Elite-Capstone/Project-ShutTheFrontDoor/Sketches/homepage.png

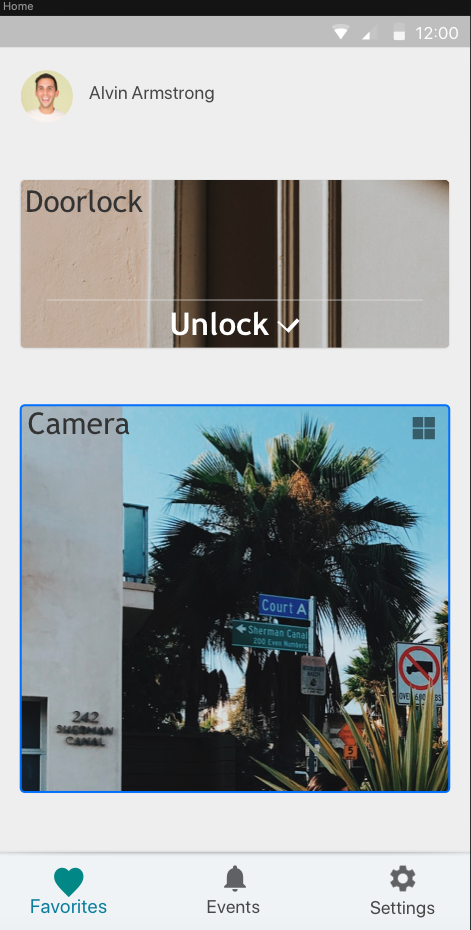
Sketches/homepage.png
