Elite-Capstone/Project-ShutTheFrontDoor/README.md

# Elite-Project
Concordia 2020 Capstone Project

On one side, it can cost a manufacturer tens of thousands of dollars for hundreds of hours of development [1] to develop an IoT product, from the hardware to the software without a dedicated in-house development team, limiting the market to larger companies. On the other side, currently, it can be more costly and troublesome for a customer to acquire a “smart front door”: they will have to buy seperate IoT devices such as a camera, a smart lock and a smart doorbell from one same ecosystem and, then, connect them together themselves. Having access to a complete package might be cheaper and easier to implement. The challenge resides in making both the user’s and the manufacturer’s life easier by helping the latter cut development costs and the former cut implementation costs. 

The aim of this project is to develop a smart door equipped with an expandable IoT platform as a two-part IoT device. The first part, the door, will come as an all-in-one solution for the customer while the second part, the expandable platform, will be available for manufacturers to add new devices to the ecosystem.

The smart door will include functionalities controlled and monitored through a mobile application. These include a smart lock, which can be locked/unlocked from the mobile interface; a camera that will allow the user to view any activities and people at their front door and a doorbell that will notify the homeowner of the presence of a visitor. All features will be enabled and powered through the use of a board. The board’s wifi module will then allow the communications for the IoT capabilities. The expandable platform will facilitate the addition of new devices to the IoT ecosystem. The prototype will use a general modular board that can be integrated in future IoT devices by simply connecting them and mapping them to the board module. All in all, this will solve both the manufacturer’s and the customer’s challenges.

A video of the completed project can be found here: https://www.youtube.com/watch?v=NI2LXENx7tQ

Regards
STFD Team
