Elite-Capstone/Project-ShutTheFrontDoor/Hardware/ESP/main-app/README.txt

This library is used to program the central MCU of the ShutTheFrontDoor Project.

GPIO List of the ESP32-SOLO-1 in ascending order
1:  TXD0 (Reserved)
2:  (in)  Cam CS
3:  RXT0 (Reserved)
4:
5:
6:  SCK
7:  SDO (out)
8:  SDI (in)
9:  SD2
10: SD3
11: CS
12: GND
13: 
14: 
15: (in) Motion Sensor Signal
16:
17:
18:
19:
NO 20
21:
22: BOOT Button
23: 
NO 24
25: (in)  Motor Fault Detect.
26: (in)  N-switch
27: (in)  Battery ADC
NO 28-31
32: (out) Motor CTRL IN 2
33: (out) Motor CTRL IN 1
34: (in)  Doorbell Signal
35: (in)  Reed Sw. Signal
36: SENSOR_VP
NO 37-38
39: SENSOR_VN

Note: Can't use ADC 2 with Wifi driver as Wifi uses ADC 2

 ADC 1           ADC 2
 CH  GPIO        CH  GPIO
 0   36          0   4
 3   39          1   0
 4   32          2   2
 5   33          3   15
 6   34          4   13
 7   35          5   12
                 6   14
                 7   27
                 8   25
                 9   26

The MCU connects to the following MQTT server:

#define MQTT_BROKER_URL "mqtt://34.95.9.208:1883"

And uses its door UUID to publish/subscribe to topics. 
This unit's UUID and topics are defined below:

#define DEFAULT_DOOR_UUID "00b288a8-3db1-40b5-b30f-532af4e12f4b"

#define NOTIFICATION_TOPIC  "notification/" DEFAULT_DOOR_UUID
#define STATUS_TOPIC        "status/" DEFAULT_DOOR_UUID
#define CMD_TOPIC           "command/" DEFAULT_DOOR_UUID

JSONs are used to communicate the MCU's state and commands. 
The formats are defined below for commands.
Command Format JSON:
{
  "name": "timeOfPublish",
  "type": "record",
  "fields": [
      {
      "name": "year",
      "type": "int"
      },
      {
      "name": "month",
      "type": "int"
      },
      {
      "name": "day",
      "type": "int"
      },
      {
      "name": "hour",
      "type": "int"
      },
      {
      "name": "minute",
      "type": "int"
      },
      {
      "name": "second",
      "type": "int"
      }
  ],
  {
    "name": "targetDevice",
    "type": "string"
  },
  {
    "name": "commandRequest",
    "type": "string"
  },
  {
    "name": "requestFlag",
    "type": "int"
  },
  {
    "name": "commandDelayMS",
    "type": "int"
  }
}

Command types:
#define MCU_SHUTDOWN_STR    "MCU shutdown"
#define MCU_GETSTATUS_STR   "Get status"
#define LOCK_DOOR_STR       "Lock door"
#define UNLOCK_DOOR_STR     "Unlock door"
#define STREAM_CAM_STR      "Stream camera"

Example command:
{
  "timeOfPublish":
  {
      "year": 2021,
      "month": 3,
      "day": 31,
      "hour": 10,
      "minute": 30,
      "second": 30
  },
  "targetDevice": "ESP32 - Main MCU",
  "commandRequest": "Get status",
  "requestFlag": 0,
  "commandDelayMS": 0
}
