Elite-Capstone/Project-ShutTheFrontDoor/Hardware/Smart Door Design with ESP32/ESP32-SOLO-1_Reference_Design/README.pdf

请使⽤用以下⼯工具打开原理理图和 PCB ⽂文件 / Use the following tools to open schematics and PCB files: SCH: Cadence/OrCAD Capture V16.6
PCB: Mentor Graphics/Pads VⅩ.2

修订历史 / Revision History

⽇日期 / Date | 版本 / Version | 发布说明 / Release notes
2018.09 | r1.0 | ⾸首次发布 / First release
2020.01 | r1.1 | 增加 asc ⽂文件/ Added an asc file.
