Elite-Capstone/Project-ShutTheFrontDoor/Division of work.png

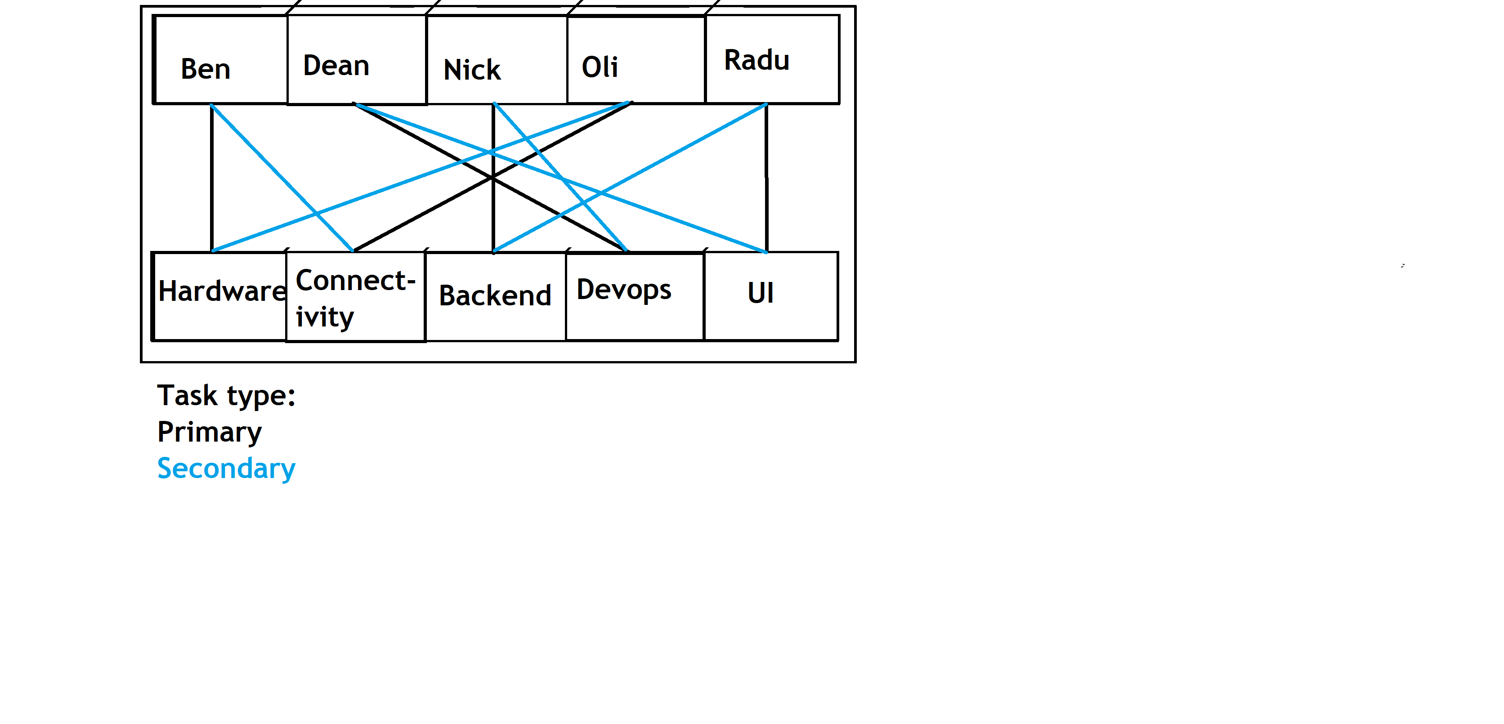
Division of work.png
