Elite-Capstone/Project-ShutTheFrontDoor/Hardware/Smart Door Design with ESP32/Team_26_Schematic_Diagrams/main pcb.png

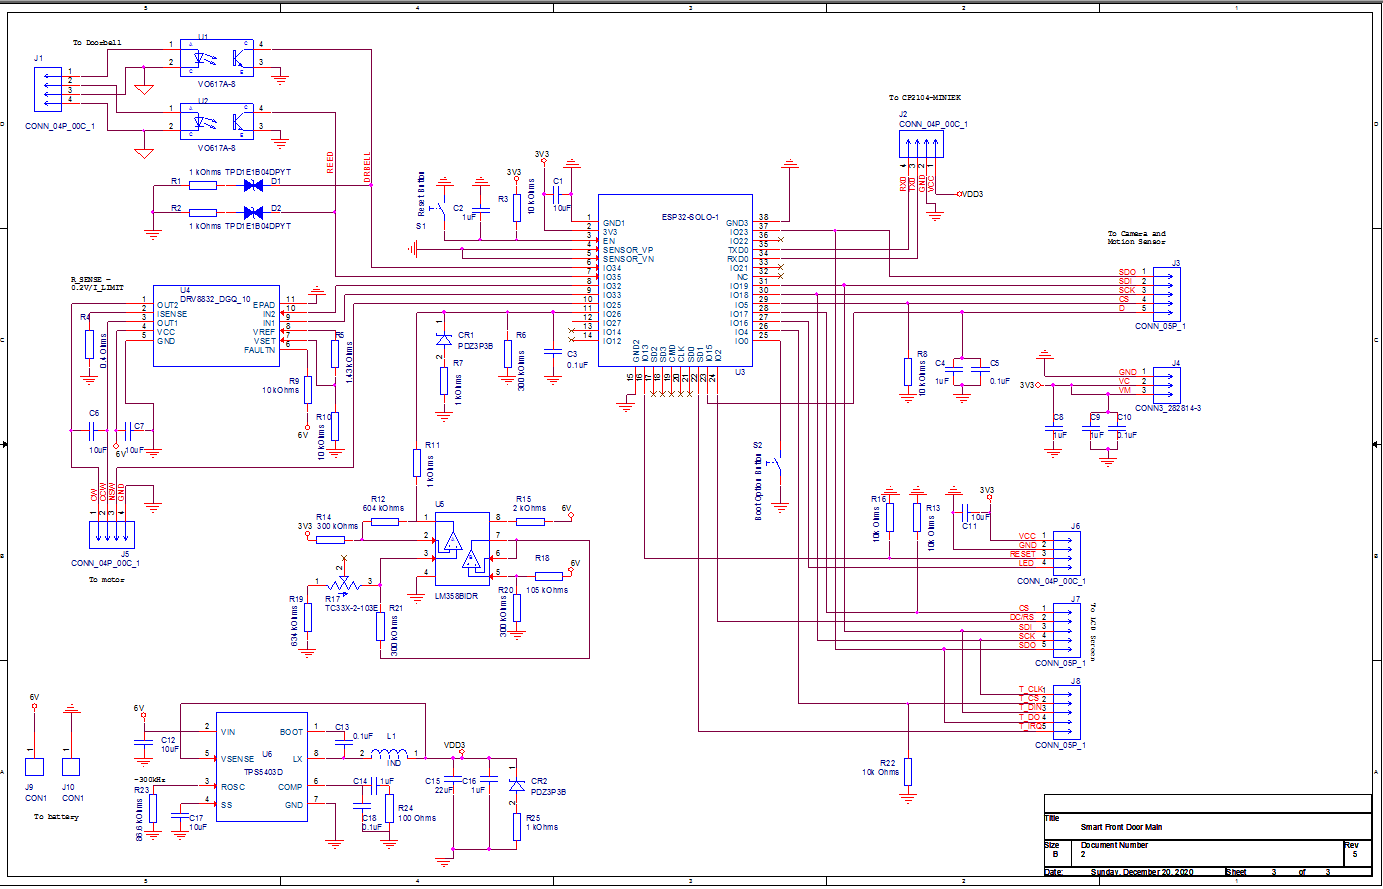
Hardware/Smart Door Design with ESP32/Team_26_Schematic_Diagrams/main pcb.png
