Elite-Capstone/Project-ShutTheFrontDoor/Hardware/Team26_PCB_Layer_Screenshots/PCB_Bottom_without_silkscreen_screenshot.PNG

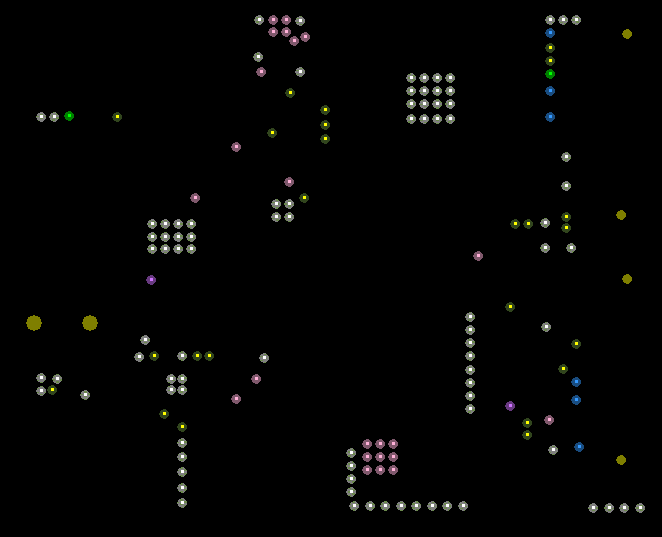
Hardware/Team26_PCB_Layer_Screenshots/PCB_Bottom_without_silkscreen_screenshot.PNG
