Elite-Capstone/Project-ShutTheFrontDoor/Hardware/Team26_PCB_Layer_Screenshots/PCB_Bypass_without_silkscreen_screenshot.PNG

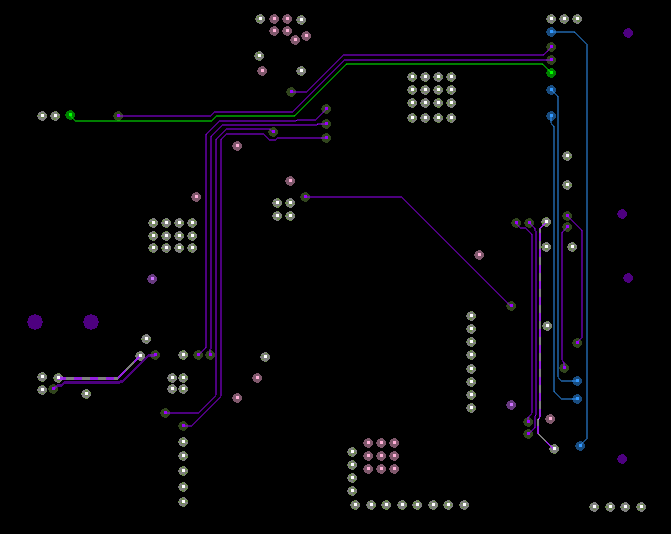
Hardware/Team26_PCB_Layer_Screenshots/PCB_Bypass_without_silkscreen_screenshot.PNG
