Elite-Capstone/Project-ShutTheFrontDoor/Hardware/Team26_PCB_Layer_Screenshots/PCB_Top_screenshot.PNG

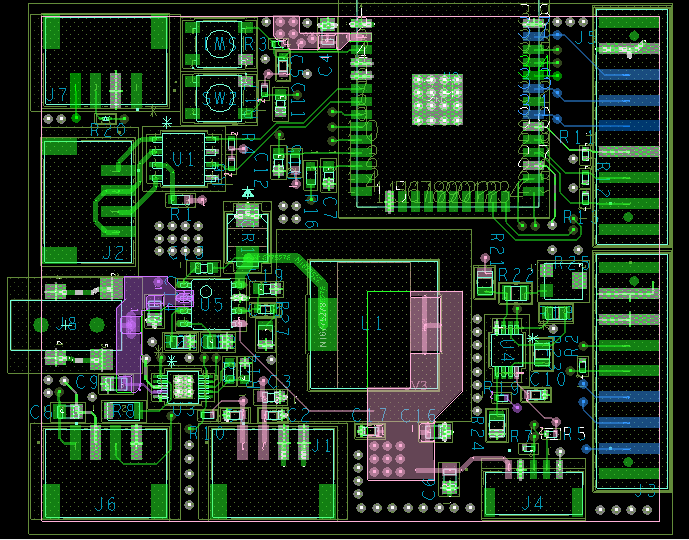
Hardware/Team26_PCB_Layer_Screenshots/PCB_Top_screenshot.PNG
