Elite-Capstone/Project-ShutTheFrontDoor/Sketches/account.png

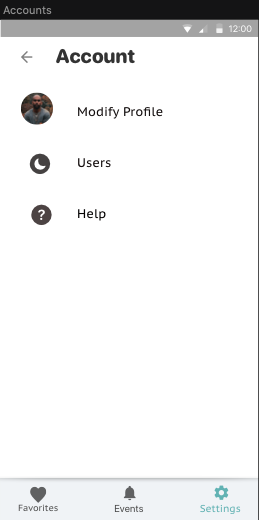
Sketches/account.png
