Elite-Capstone/Project-ShutTheFrontDoor/Sketches/add new user.png

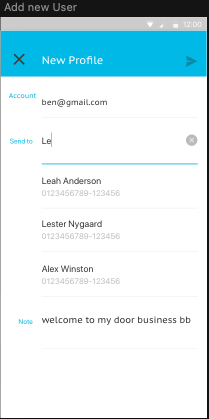
Sketches/add new user.png
