Elite-Capstone/Project-ShutTheFrontDoor/Sketches/all recordings.png

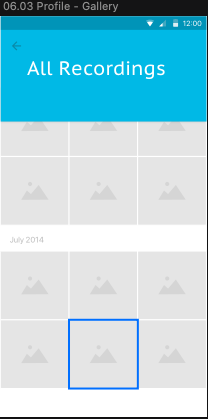
Sketches/all recordings.png
