Elite-Capstone/Project-ShutTheFrontDoor/Sketches/delete user.png

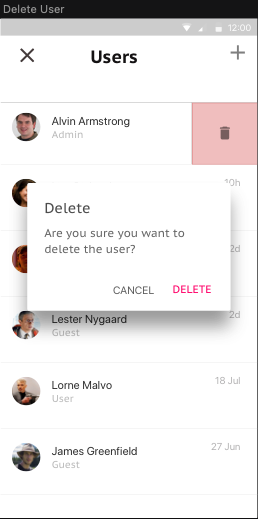
Sketches/delete user.png
