Elite-Capstone/Project-ShutTheFrontDoor/Sketches/device status.png

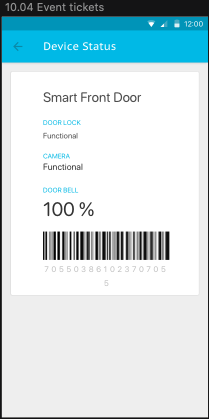
Sketches/device status.png
