Elite-Capstone/Project-ShutTheFrontDoor/Sketches/edit user.png

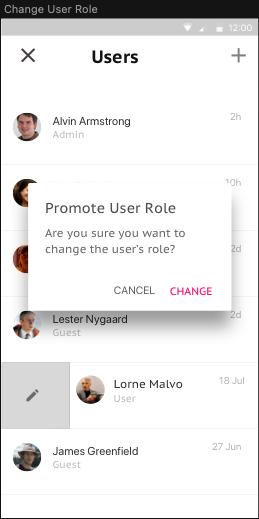
Sketches/edit user.png
