Elite-Capstone/Project-ShutTheFrontDoor/Sketches/events log.png

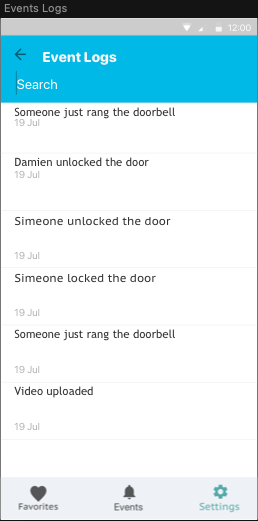
Sketches/events log.png
