Elite-Capstone/Project-ShutTheFrontDoor/Sketches/login.png

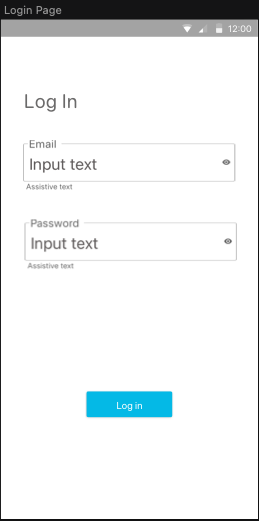
Sketches/login.png
