Elite-Capstone/Project-ShutTheFrontDoor/Sketches/modify profile.png

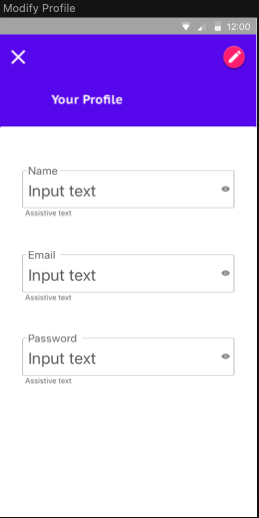
Sketches/modify profile.png
