Elite-Capstone/Project-ShutTheFrontDoor/Sketches/notifications.png

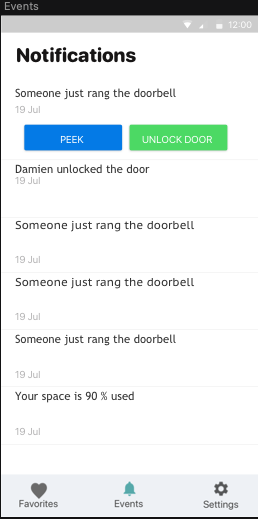
Sketches/notifications.png
