Elite-Capstone/Project-ShutTheFrontDoor/Sketches/register.png

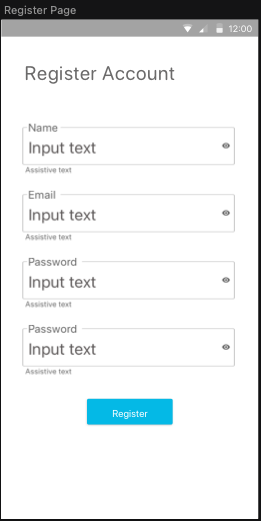
Sketches/register.png
