Elite-Capstone/Project-ShutTheFrontDoor/Sketches/settings.png

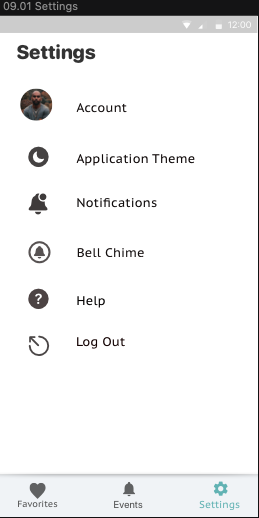
Sketches/settings.png
