Elite-Capstone/Project-ShutTheFrontDoor/Hardware/Product Orders/Team26_BOM_V4.pdf

# Bill of Materials

Company: | University of Concordia
Project Name: | Smart Front Door
Revision: | Release 4 BOM
Prepared by: | Dean Chong San, Nick Di Marco and Benjamin Lanthier, Team 26
Approved by: | Dmitry Rozhdestvenskiy
Production date 1/25/2021
Design Reference | Name | Description | Value | Qty | Unit | Manufacturer | Manufacturer P/N | Package | Type | Supplier | Supplier P/N | Unit Cost ($CDN) | Total Cost ($CDN)
- | Battery Charger | Desktop Battery Charger 7A 300 mA 6V | 300mA, 6V | 1 | pcs | ZEUS Battery Products | PCCG-SLA6V300 | Bulk | Desktop | Digi-Key | 2059-PCCG- SLA6V300-ND | 16.1 | 16.1
- | Magnet | MAGNET 1.125"L X 0.259"W PLASTIC for 59145-030 Reed switch | 57150-000 | 1 | pcs | Littelfuse Inc. | 57150-000 | Bulk | Alnico 5 (AlNiCo) | Digi-Key | 57150-000-ND | 4.05 | 4.05
- | PCB Board | Project 4-Layer PCB board - 63.5mm x 63.5 mm | - | 5 | pcs | JLCPCB | - | - | - | JLCPCB | - | | 8
- | SD Card 64 GB | SanDisk A1 Memory micro SD Card 64 GB | 64gb | 1 | pcs | SanDisk | A1 micro sd card | Single card | micro SD | Ali-Express | A1 micro sd card | 8.61 | 8.61
- | USB to Serial | RF Explorer - Adapter Board | 317990279 | 1 | pcs | Seeed Technology Co. Ltd | 317990279 | Evaluation Board | Adapter Board | Digi-Key | 1597-1492-ND | 8.42 | 8.42
BT1 | Batteries | Battery HHR PACK NIMH 6V L-A | 3.7Ah | 2 | pcs | Panasonic - BSG | HHR-380AB27F5 | 5 cells | side-to-side | Digi-Key | P018-F051-ND | 52.26 | 104.52
BT2, SW4 | Wireless Doorbell | Heath Zenith Wireless Battery Operated Door Bell Kit with 1-Push Button | # SL-7306-03 | 1 | pcs | Heath Zenith | # SL-7306-03 | Box | // | HomeDepot | # 1001341241 | 30 | 30
C1, C2, C5, C10, C15, C17 | 1µF Cap SMD | Ceramic Capacitor 1µF | 1 µF | 12 | pcs | Samsung Electro-Mechanics | CL10B105KO8NFNC | 0603 | SM | Digi-Key | 1276-1943-1-ND | 0.14 | 1.68
C16 | 22µF Cap SMD | Ceramic Capacitor 22µF | 22 µF | 2 | pcs | Samsung Electro-Mechanics | CL21A226KPCLRNC | 0805 | SM | Digi-Key | 1276-6786-1-ND | 0.52 | 1.04
C3, C7, C11, C12, C13, C19 | 0.1uF Cap SMD | 0.1µF Ceramic Capacitor | 0.1 uF | 12 | pcs | Samsung Electro-Mechanics | CC0603JRX7R7BB10 4 | 0603 | SM | Digi-Key | 311-1776-1-ND | 0.14 | 1.68
C4, C6, C8, C9, C14, C18 | 10µF Cap SMD | Ceramic Capacitor 10µF | 10 µF | 12 | pcs | Samsung Electro-Mechanics | CL21A106KOQNNNG | 0805 | SM | Digi-Key | 1276-6455-1-ND | 0.16 | 1.92
CR1 | Schottky Diode | Diode Schottky 25V 2A SMB | 25V, 2A | 4 | pcs | STMicroelectronics | STPS2L25U | DO-214AA | SM | Digi-Key | 497-5573-1-ND | 0.51 | 2.04
D1, D2 | TVS Diodes | TVS DIODE 3.6V 8.5V 2X1SON | TPD1E1B04DP YT | 4 | pcs | Texas Instruments | TPD1E1B04DPYT | 0402 | SM | Digi-Key | 296-46892-2-ND - Tape & Reel | 1.02 | 4.08
J1, J2, J6, J7 | 4-wire connector male | Connector Header Surface Mount, Right Angle 4 position | S4B-PH-SM4- TB(LF)(SN) | 8 | pcs | JST Sales America Inc | S4B-PH-SM4-TB(LF) (SN) | Shrouded | SM, Right Angle | Digi-Key | 455-1751-1-ND | 1.02 | 8.16
J14, J19 | 7-wire connector female | 7 Position Terminal Block Plug, Female Sockets 0.100" (2.54mm) 180° Free Hanging (In-Line) | 1431071310100 0 | 2 | pcs | HARTING | 14310713101000 | Shrouded | Free Hanging (In- Line) | Digi-Key | 1195-3604-ND | 3.72 | 7.44
J15 - J17 | 4-wire connector female | 4 Position Cable Assembly Rectangular Socket to Individual Wire Leads | CABLE-EH04 | 4 | pcs | Trinamic Motion Control GmbH | CABLE-EH04 | Shrouded, Socket to individual wire leads | Free Hanging, (In- Line) | Digi-Key | 1460-1292-ND | 1.7 | 6.8
J18 | 5-wire connector female | 5 Rectangular Connectors - Housing Receptable Natural | GHR-05V-S | 1 | pcs | JST Sales America Inc. | GHR-05V-S | Shrouded | Free Hanging (In- Line) | Digi-Key | 455-1595-ND | 0.25 | 0.25
J3, J5 | 7-connector male | 7 Position Terminal Block Header, Male Pins, Shrouded (4 Side) 0.100" (2.54mm) 90°, Right Angle Surface Mount | 1411071300200 0 | 4 | pcs | HARTING | 14110713002000 | Shrouded | SM, Right Angle | Digi-Key | 1195-3639-1-ND | 2.87 | 11.48
J4 | 5-wire connector male | CONN HEADER SMD R/A 5POS 1.25MM | SM05B-GHS- TB(LF)(SN) | 2 | pcs | JST Sales America Inc | SM05B-GHS-TB(LF) (SN) | Shrouded | SM, Right Angle | Digi-Key | 455-1567-1-ND | 0.5 | 1
J8 | Barrel Connector | DC POWER JACK, SMT, HORIZONTAL, | DCJ065-05-A- K1-A | 2 | pcs | GCT | DCJ065-05-A-K1-A | Bulk | SM, Right Angle | Digi-Key | 2073-DCJ065-05-A- K1-ACT-ND | 1.05 | 2.1
J9 | Barrel Plug | Cable Assembly 0.7mm ID, 2.35mm OD Plug to wire | CA-2192 | 2 | pcs | Tensility International Corp | CA-2192 | Bulk | Free Hanging, Plug to wire leads | Digi-Key | CP-2192-ND | 3.79 | 7.58
L1 | 180uH Inductor | Shielded Wirewound Inductor | 180 µH | 2 | pcs | Bourns Inc | SRR1210-181M | Nonstandard | SM | Digi-Key | SRR1210-181MCT- ND | 1.64 | 3.28
M1 | Defiant Door lock | Defiant Castle Matte Black SIngle Cylinder Electronic Keypad Deadbolt | # G7XKD01AA | 1 | pcs | Defiant | # G7XKD01AA | Box | Electronic Keypad | HomeDepot | # 1001134626 | 90 | 90
MS1 | Motion Sensor | Motion Sensor SEN0171 PIR (MOTION) SENSOR | Gravity | 1 | pcs | DFRobot | SEN0171 | Board and cables | Sensor | Digi-Key | 1738-1129-ND | 6.93 | 6.93
R1, R15, R16 | 1 kΩ Res | 1 kΩ with 1% Tolerance | 1 kΩ | 6 | pcs | Yageo | RE0603FRE071KL | 0603 | SM | Digi-Key | 13- RE0603FRE071KLCT -ND | 0.15 | 0.9
R14 | 10 kΩ Res (0.1% Tol) | RES SMD 10K OHM 0.1% 1/10W 0603 | 10 kΩ | 2 | pcs | Yageo | RE0603BRE0710KL | 0603 | SM | Digi-Key | 13- RE0603BRE0710KLC T-ND | 0.48 | 0.96
R18 | 931 kΩ Res | RES SMD 931K OHM 1% 1/8W 0805 | 931 kΩ | 2 | pcs | Yageo | RC0805FR-07931KL | 0805 | SM | Digi-Key | 311-931KCRTR-ND | 0.15 | 0.3
R19 | 300 kΩ Res | RES 300 kΩ | 300 kΩ | 2 | pcs | Yageo | RC0402JR-07300KL | 0402 | SM | Digi-Key | 311-300KJRCT-ND | 0.15 | 0.3
R2 - R7, R10 - R13, R17 | 10kΩ Res (1% Tol) | RES 10K OHM 1% 1/10W 0402 | 10 kΩ | 22 | pcs | KOA Speer Electronics Inc | RK73G1ETTP1002F | 0402 | SM | Digi-Key | 2019- RK73G1ETTP1002FC T-ND | 0.39 | 8.58
R20 - R22 | 200 kΩ Res | RES SMD 200K OHM 0.5% 1/10W 0805 | 200 kΩ | 6 | pcs | Susumu | RR1220P-204-D | 0805 | SM | Digi-Key | RR12P200KDTR-ND | 0.15 | 0.9
R23 | 150 kΩ Res | RES SMD 150K OHM 0.5% 1/10W 0805 | 150 kΩ | 2 | pcs | Susumu | RR1220P-154-D | 0805 | SM | Digi-Key | RR12P150KDTR-ND | 0.15 | 0.3
R24 | 499 Ω Res | 499 Ω Chip Resistor | 499Ω | 2 | pcs | Stackpole Electronics | RMCF0201FT499R | 0201 | SM | Digi-Key | RMCF0201FT499RCT -ND | 0.15 | 0.3
R25 | 10 kΩ Trimmer | Trimmer 10k Ω | 10 kΩ | 2 | pcs | Bourns Inc | TC33X-2-103E | SOD-23 | SM | Digi-Key | TC33X-103ECT-ND | 0.4 | 0.8
R26 | 86.6 kΩ Res | RES SMD 86.6K OHM 1% 1/8W 0805 | 86.6 kΩ | 2 | pcs | Yageo | RC0805FR-0786K6L | 0805 | SM | Digi-Key | 311-86.6KCRTR-ND | 0.15 | 0.3
R27 | 100 Ω Res | RES 100 OHM 5% 1/8W 0805 | 100 Ω | 2 | pcs | Vishay Dale | CRCW0805100RJNE AC | 0805 | SM | Digi-Key | 541-4166-2-ND | 0.15 | 0.3
R28 | 1 kΩ Res | RES 1K OHM 1/4W 1% AXIAL | 1 kΩ | 2 | pcs | Yageo | MFR-25FBF52-1K | Axial | Through hole | Digi-Key | 1.00KXBK-ND | 0.14 | 0.28
R8 | 0.4 Ω Res | 400 mΩ Chip Resistor | 400 mΩ | 2 | pcs | Yageo | RL1206FR-070R4L | 1206 | SM | Digi-Key | 311-.4LWCT-ND | 0.54 | 1.08
R9 | 1.43 kΩ Res | 1.43 kΩ Chip Resistor | 1.43 kΩ | 2 | pcs | Bourns Inc | RT0603BRE071K43L | 0603 | SM | Digi-Key | YAG4654CT-ND | 0.57 | 1.14
SW1, SW2 | Switch Button | Tactile Switch Top Actuated Surface Mount | PTS 647 SK50 SMTR2 LFS | 4 | pcs | C&K | PTS 647 SK50 SMTR2 LFS | PTS647-NO | SM | Digi-Key | PTS647SK50SMTR2L FSCT | 0.2 | 0.8
SW3 | Switch Button | Tactile Switch SPST-NO Top Actuated Through Hole | 1825910-6 | 2 | pcs | TE Connectivity ALCOSWITCH Switches | 1825910-6 | SPST-NO | Through hole | Digi-Key | 450-1650-ND | 0.15 | 0.3
SW5 | Reed Switch | SENSOR REED SW SPDT WIRE LEADS | 59145-030 | 1 | pcs | Littelfuse Inc. | 59145-030 | Wire terminated | SPDT | Digi-Key | 59145-030-ND | 6.58 | 6.58
U1 | OptoCoupler | Optoisolator Transistor Output 2500Vrms 2 Channel 8-SOIC | 2500Vrms | 2 | pcs | ON Semiconductor | MOCD207D2M | 8-SOIC | SM | Digi-Key | MOCD207D2MCT-ND | 2.18 | 4.36
U2 | ESP32-SOLO-1 | ESP32-SOLO-1 Board, 2.4GHz, 150Mbps, 3.6V | ESP32-SOLO-1 | 2 | pcs | Espressif Systems | ESP32-SOLO-1 | 38-SMD Module | SMD | Digi-Key | 1965-ESP32-SOLO- 1CT-ND | 5.12 | 10.24
U3 | Motor Controller | Bipolar Motor Driver Power MOSFET Parallel | 296-51093-1- ND | 2 | pcs | Texas Instruments | DRV8832QDGQRQ1 | 10-TFSOP. 10- MSOP | SM | Digi-Key | 296-51093-1-ND | 3.92 | 7.84
U4 | Op-Amp | IC OPAMP GP 2 CIRCUIT 8VSSOP | TLV8812DGKR | 2 | pcs | Texas Instruments | TLV8812DGKR | 8-VSSOP | SM | Digi-Key | 296-45065-2-ND | 1.28 | 2.56
U5 | Switching Reg. | Buck Switching Regulator IC Positive | 296-34972-1- ND | 2 | pcs | Texas Instruments | TPS5403DR | 8-SOIC | SM | Digi-Key | 296-34972-1-ND | 2.41 | 4.82
U6 | ESP32-CAM | ESP32-CAM DEVELOPMENT BOARD | ESP32-CAM | 1 | pcs | Seeed Technology Co., Ltd | 113990580 | DIP-16 | DIP | Digi-Key | 1597-1687-ND | 15.99 | 15.99
U7 | LCD Screen | LCD Screen Serial Port Module With PCB Adapter Micro SD (240x320) | 240x320px | 1 | pcs | Generic | MSP2807 | Bulk | DIP | Ali-Express | 2.8 inch TFT LCD Modul | 7.09 | 7.09
Note 1: The PCB price accounts for free shipping in 4-5 days | Total Cost: | 407.09
