Elite-Capstone/Project-ShutTheFrontDoor/Hardware/Product Orders/Final_BOM_Digi-Key.xlsx

# | QUANTITY | PART NUMBER | MANUFACTURER PART NUMBER | DESCRIPTION | CUSTOMER REFERENCE | BACKORDER | UNIT PRICE | EXTENDED PRICE
1 | 1 | 2059-PCCG-SLA6V300-ND | PCCG-SLA6V300 | BATT CHARGER DESKTOP 7V 300MA |  | 0 | 15.74 | 15.74
2 | 1 | 57150-000-ND | 57150-000 | MAGNET 1.125"L X 0.259"W PLASTIC |  | 0 | 4.05 | 4.05
3 | 1 | 1597-1492-ND | 317990279 | USB CP2102 SERIAL CONVERTER |  | 0 | 8.23 | 8.23
4 | 1 | 1528-2005-ND | 1446 | WIRE WRAP THIN PROTOTYPING & REP |  | 0 | 10.37 | 10.37
5 | 2 | P018-F051-ND | HHR-380AB27F5 | BATTERY PACK NIMH 6V L-A |  | 2 | 51.08 | 102.16
6 | 4 | 445-FK24X5R1C106KR000-ND | FK24X5R1C106KR000 | CAP CER 10UF 16V X5R RADIAL |  | 0 | 0.69 | 2.76
7 | 4 | 497-5573-1-ND | STPS2L25U | DIODE SCHOTTKY 25V 2A SMB |  | 0 | 0.61 | 2.44
8 | 2 | P6KE6.8ALFCT-ND | P6KE6.8A | TVS DIODE 5.8V 10.5V DO204AC |  | 0 | 0.48 | 0.96
9 | 8 | 455-1751-1-ND | S4B-PH-SM4-TB(LF)(SN) | CONN HEADER SMD R/A 4POS 2MM |  | 0 | 1 | 8.00
10 | 2 | 1195-3604-ND | 14310713101000 | TERM BLOCK PLUG 7POS STR 2.54MM |  | 0 | 3.67 | 7.34
11 | 4 | 1460-1292-ND | CABLE-EH04 | CABLE JST EHR-04 AWG 24, LENGTH |  | 0 | 1.66 | 6.64
12 | 1 | 455-1595-ND | GHR-05V-S | CONN GH HOUSING 5POS 1.25MM |  | 0 | 0.25 | 0.25
13 | 4 | 1195-3639-1-ND | 14110713002000 | TERM BLOCK HDR 7POS 90DEG 2.54MM |  | 0 | 2.82 | 11.28
14 | 2 | 455-1567-1-ND | SM05B-GHS-TB(LF)(SN) | CONN HEADER SMD R/A 5POS 1.25MM |  | 0 | 0.69 | 1.38
15 | 2 | 2073-DCJ065-05-A-K1-ACT-ND | DCJ065-05-A-K1-A | DC POWER JACK, SMT, HORIZONTAL, |  | 0 | 1.02 | 2.04
16 | 2 | CP-2192-ND | CA-2192 | CABLE ASSY STR 0.70MM 6' 24 AWG |  | 0 | 3.71 | 7.42
17 | 2 | SRR1210-181MCT-ND | SRR1210-181M | FIXED IND 180UH 1.9A 250MOHM SMD |  | 0 | 1.76 | 3.52
18 | 1 | 1738-1129-ND | SEN0171 | PIR (MOTION) SENSOR |  | 0 | 6.78 | 6.78
19 | 2 | P300KDACT-ND | ERA-6AEB304V | RES 300K OHM 0.1% 1/8W 0805 |  | 0 | 0.46 | 0.92
20 | 2 | 311-931KCRCT-ND | RC0805FR-07931KL | RES SMD 931K OHM 1% 1/8W 0805 |  | 0 | 0.15 | 0.30
21 | 2 | 541-CRCW0805499RFKEACCT-ND | CRCW0805499RFKEAC | RES 499 OHM 1% 1/8W 0805 |  | 0 | 0.15 | 0.30
22 | 2 | TC33X-103ECT-ND | TC33X-2-103E | TRIMMER 10K OHM 0.1W J LEAD TOP |  | 0 | 0.38 | 0.76
23 | 2 | 311-86.6KCRCT-ND | RC0805FR-0786K6L | RES SMD 86.6K OHM 1% 1/8W 0805 |  | 0 | 0.15 | 0.30
24 | 2 | CF18JT180RCT-ND | CF18JT180R | RES 180 OHM 1/8W 5% CF AXIAL |  | 0 | 0.15 | 0.30
25 | 2 | 13-RL0805FR-070R4LCT-ND | RL0805FR-070R4L | RES 0.4 OHM 1% 1/8W 0805 |  | 0 | 0.65 | 1.30
26 | 2 | 311-1.43KCRCT-ND | RC0805FR-071K43L | RES SMD 1.43K OHM 1% 1/8W 0805 |  | 0 | 0.15 | 0.30
27 | 4 | PTS647SK50SMTR2LFSCT | PTS 647 SK50 SMTR2 LFS | TACT 4.5 X 4.5, 5.0 MM H, 2.5N, |  | 0 | 0.19 | 0.76
28 | 2 | 450-1650-ND | 1825910-6 | SWITCH TACTILE SPST-NO 0.05A 24V |  | 0 | 0.15 | 0.30
29 | 1 | 59145-030-ND | 59145-030 | SENSOR REED SW SPDT WIRE LEADS |  | 0 | 6.57 | 6.57
30 | 2 | MOCD207D2MCT-ND | MOCD207D2M | OPTOCOUPLER PHOTOTRANS |  | 0 | 2.25 | 4.50
31 | 2 | 1965-ESP32-SOLO-1CT-ND | ESP32-SOLO-1 | RX TXRX MOD WIFI TRACE ANT SMD |  | 0 | 5.01 | 10.02
32 | 2 | 296-51093-1-ND | DRV8832QDGQRQ1 | IC MOTOR DRIVER PAR 10-MSOP |  | 0 | 3.83 | 7.66
33 | 2 | 296-45065-1-ND | TLV8812DGKR | IC OPAMP GP 2 CIRCUIT 8VSSOP |  | 0 | 1.28 | 2.56
34 | 2 | 296-34972-1-ND | TPS5403DR | IC REG BUCK 3.3V 1.7A 8SOIC |  | 0 | 2.49 | 4.98
35 | 1 | 1597-1687-ND | 113990580 | ESP32-CAM DEVELOPMENT BOARD(WITH |  | 0 | 15.63 | 15.63
