Elite-Capstone/Project-ShutTheFrontDoor/Hardware/Smart Door Design with ESP32/ESP32-SOLO-1_Reference_Design/05_BOM List/ESP32-SOLO-1_V1_BOM(V1.1).xlsx

ESP32-SOLO-1_V1_BOM(V1.1)
ID | Qty | Ref Des | Value | Package | ICs | Description
1 | 2 | C1, C2 | 22 pF ± 10%/6.3 V | 0201 | Capacitor | Ceramic capacitor
2 | 1 | C3 | 100 pF ± 10%/6.3 V | 0201 | Capacitor | Ceramic capacitor
3 | 4 | C4, C9, C10, C19 | 0.1 uF ± 10%/6.3 V | 0201 | Capacitor | Ceramic capacitor
4 | 1 | C5 | 10 nF ± 10%/6.3 V | 0201 | Capacitor | Ceramic capacitor
5 | 1 | C6 | 3.3 nF ± 10%/6.3 V | 0201 | Capacitor | Ceramic capacitor
6 | 3 | C11, C18, C20 | 1 uF ± 20%/10 V | 0201 | Capacitor | Ceramic capacitor
7 | 1 | C13 | 10 uF ± 20%/6.3 V | 0402 | Capacitor | Ceramic capacitor
9 | 1 | C14 * | 3.6 pF ± 0.1 pF/50 V | 0201 | Capacitor | Ceramic capacitor
10 | 1 | C15 * | 2.7 pF ± 0.1 pF/50 V | 0201 | Capacitor | Ceramic capacitor
11 | 1 | L4 * | 2.0 nH ± 0.1 nH | 0201 | Inductor | Inductor
12 | 1 | L5 | 2.0 nH ± 0.1 nH | 0201 | Inductor | Inductor
14 | 1 | R2 | 0 R ± 5% | 0201 | Resistor | Chip resistor
15 | 1 | R3 | 499 R ± 1% | 0201 | Resistor | Chip resistor
16 | 1 | R1 | 20 K ± 5% | 0201 | Resistor | Chip resistor
17 | 1 | D1 | LESD8D3.3CAT5G | SOD882 | ESD protection (TVS) | TVS diode, 3.3 V
18 | 1 | U1 | 40 MHz ± 10 ppm | CRYS/SMD/4P/3.2X2.5 | Crystal | 40 MHz crystal
19 | 1 | U2 | ESP32-S0WD | QFN48_5x5 | Chip | ESP32 (5 mm * 5 mm)
20 | 1 | U3 | GD25Q32CSIG&GD25Q32CTIG | SOP8-208 mil & 150 mil | Flash | Flash (3.3 V)
Note: * Please note that Murata is recommended for C14, C15 and L4.
