Elite-Capstone/Project-ShutTheFrontDoor/(list of files, cad)

Other CAD files:
Hardware/Smart Door Design with ESP32/LIB_ESP32-SOLO-1/ESP32-SOLO-1/Allegro/esp32solo1.psm
Hardware/Smart Door Design with ESP32/LIB_ESP32-SOLO-1/ESP32-SOLO-1/DEHDL/esp32_solo_1/chips/chips.prt
