Elite-Capstone/Project-ShutTheFrontDoor/(threads)

Thread 57 (2020-11-17):

DOC-4.4.1 - ESP32 - Solo-1 Ki-CAD component design

BigBen03, 2020-11-17:
---
ESP32 - Solo-1 Ki-CAD component design
Component design to be used in the hardware schematic

BigBen03, 2020-11-17:
Found an OrCAD already made design by Espressif themselves. Design will be pushed to git.

Closed 2020-11-17.

Thread 60 (2020-11-18):

Make list of tools used during design phase

BigBen03, 2020-11-18:
Ben: I used OrCAD Pspice and draw.io for the flow chart

nickydime, 2020-11-25:
Draw.io for flowchart
Azure for CosmosDB set up
Azure for Blob Storage set up

RaduP13, 2020-11-26:
draw.io
google forms
survey monkey

BigBen03, 2020-11-26:
Google sheets and schematic/flow chart standards IEC/ISO

superDeano, 2020-11-26:
I used:
 Sketch for ui sketches design,
omnigaffle for the different charts and diagrams,
Android studio to create project.
GitKraken for committing the stuffs I made.

nickydime, 2020-11-30:
Tools discussed in the report (Skipped some that were common/repetitive):
- Draw.io
- Survey Monkey/Google Forms
- Google Sheets
- Sketch
- Android Studio
- Azure

Closed 2020-11-30.

Thread 67 (2020-11-28):

Add Alternatives Tables for Hardware

BigBen03, 2020-11-28:
Discuss different choices for
Board
Camera
Lock                                 ----DONE----
Doorbell                          ----DONE----
Power Supply
Optional: LCD Screen

RaduP13, 2020-12-03:
Lock and Doorbell done

Closed 2021-01-11.

Thread 78 (2021-01-13):

UI-1.8.2 Authentication Page

superDeano, 2021-01-13:
- Text Fields for email, name, password, ...
- Log in button
- Shortcut for Register page in case user needs to create an account

Closed 2021-02-03.

Thread 86 (2021-01-13):

UI-1.11.2 Saved Recordings (MediaShare) Activity

superDeano, 2021-01-13:
- Shortcut from camera view on homepage
- Display saved videos in recycler view in 3 columns
- Ability to watch a selected video
- Ability to download videos
- Ability to delete videos

Closed 2021-04-08.

Thread 113 (2021-02-02):

Design PCB

BigBen03, 2021-02-02:
Use approved schematic and basic components from JLC PCB's library to design the projects PCB

BigBen03, 2021-02-02:
PCB has been given feedback by Dmitry on Jan 27th and has been given green light to order once ready.

BigBen03, 2021-02-02:
The PCB design was ordered on Jan 31st. 5 PCBs will be produced with all capacitors and most of the resistors surface mounted by JLC PCB.

Closed 2021-02-02.

Thread 125 (2021-02-18):

CAM-1.1.3 - Taking pictures

BigBen03, 2021-02-18:
The ESP module must be able to take pictures at the press of a button (through an app or through a physical switch attached to the ESP32-CAM GPIOs). The picture must be locally saved (SD card) or sent through wifi/http request

Thread 128 (2021-02-18):

LOCK-1.1.2.2 - Confirming lock operation is successful

BigBen03, 2021-02-18:
---
The MCU must be able to detect that the lock has fully rotated into the bolt socket and isn't stuck somewhere.
If the bolt is stuck, a fault current will be detected and the signal will be send from the motor controller

Closed 2021-04-04.

Thread 134 (2021-02-19):

CAM-1.1.6 - Toggle start/end Video stream with GPIO

BigBen03, 2021-02-19:
The camera must be able to start and end streaming on an event, such as a button press or hardware signal toggle so that we can implement event detection later on with the motion sensor.

The signal can be received through a pulled-up GPIO.

The start/end stream should be able to receive an HTTP end point and stream to it

Closed 2021-03-25.

Thread 174 (2021-03-16):

BCK - MQTT requests

BigBen03, 2021-03-16:
Create HTTP requests to send to the board when a user wants to (un)lock the door, start the camera server, access the battery voltage

Closed 2021-04-02.

Thread 185 (2021-04-02):

BELL-1.1 - Attach doorbell switch to MCU

BigBen03, 2021-04-02:
Solder wires to the doorbell switch such that when it is pressed, the board's GPIO is pulled down

Closed 2021-04-08.
