Elite-Capstone/Project-ShutTheFrontDoor/Hardware/Team26 _ Schematics/Component _ Door Lock_R2.pdf

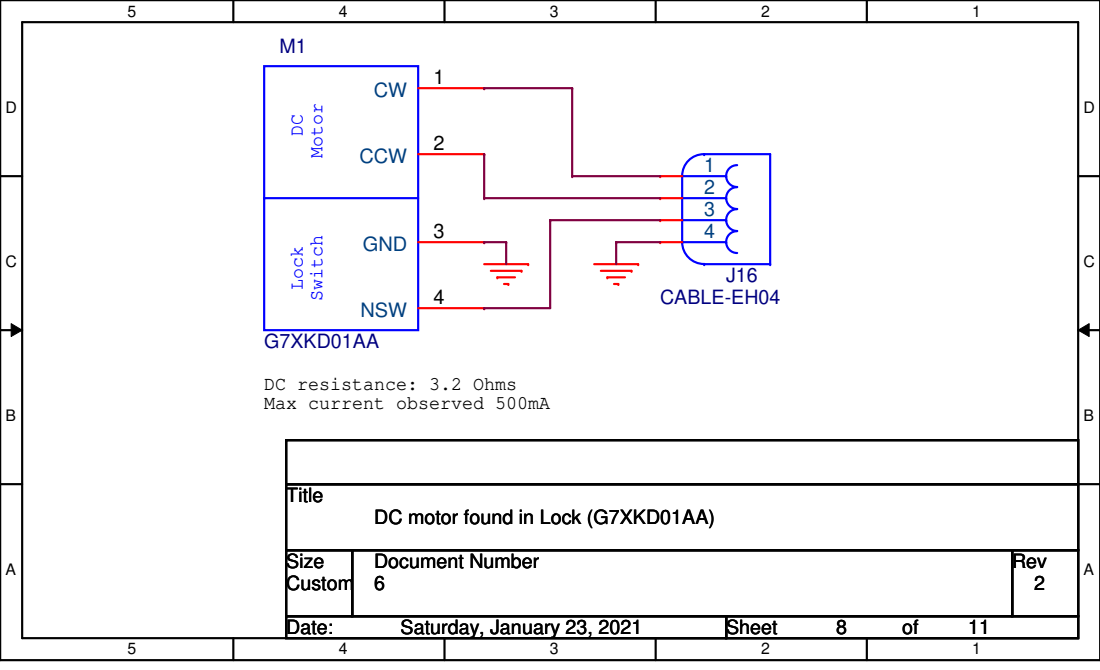
[picture p19: page 1]
Title; Size; Document Number; Rev; Date:; Sheet; Custom; Saturday, January 23, 2021; J16 CABLE-EH04; Motor 1; Lock; Switch; G7XKD01AA; CCW; GND; NSW

DC resistance: 3.2 Ohms
Max current observed 500mA

DC motor found in Lock (G7XKD01AA)
