Elite-Capstone/Project-ShutTheFrontDoor/Hardware/Team26 _ Schematics/Component _ LCD Screen_R3.pdf

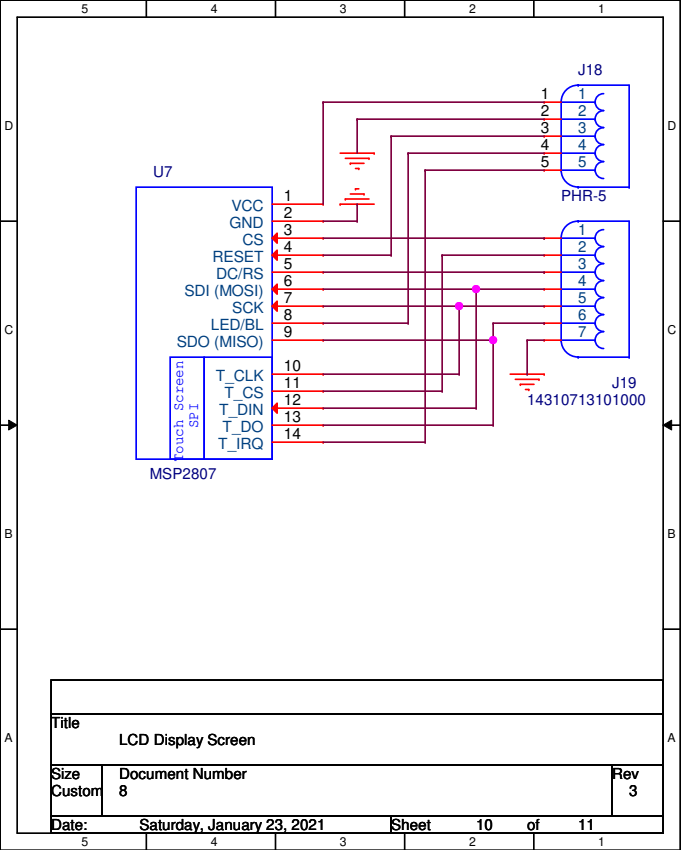
[picture p20: page 1]
Title; Size; Document Number; Rev; Date:; Sheet; Custom; Saturday, January 23, 2021; PHR-5; Touch Screen; SPI; MSP2807; VCC; GND; RESET; SDI (MOSI); SCK; LED/BL; SDO (MISO); T_CLK; T_DIN; T_IRQ

LCD Display Screen
