Elite-Capstone/Project-ShutTheFrontDoor/Hardware/Team26 _ Schematics/Components _ Battery_R1.pdf

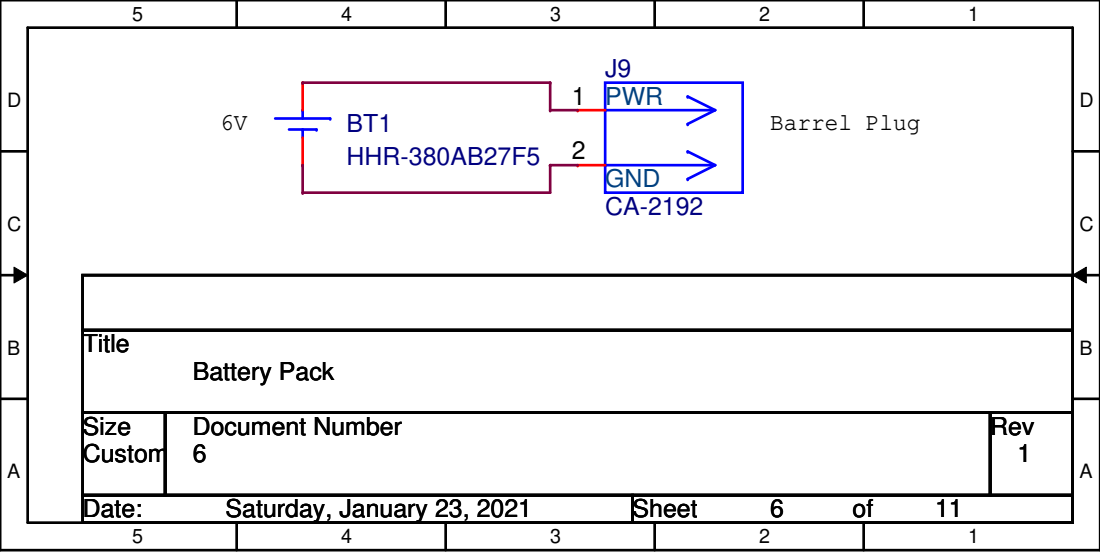
[picture p21: page 1]
Barrel Plug; Title; Size; Document Number; Rev; Date:; Sheet; Battery Pack; Custom; Saturday, January 23, 2021; 1 PWR; GND; BT1 HHR-380AB27F5
