Elite-Capstone/Project-ShutTheFrontDoor/Hardware/Team26 _ Schematics/Components _ Cam_and_MSensor_R3.pdf

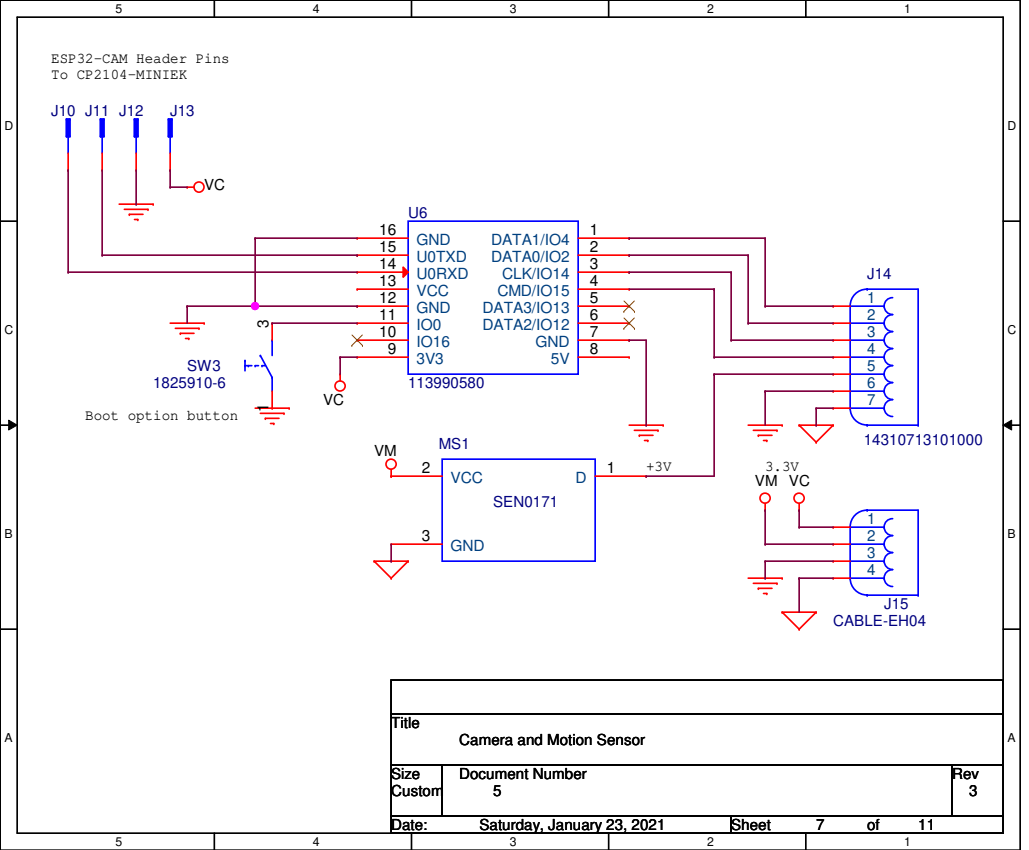
[picture p22: page 1]

ESP32-CAM Header Pins To CP2104-MINIEK | | J12

Camera and Motion Sensor
