Elite-Capstone/Project-ShutTheFrontDoor/Hardware/Team26 _ Schematics/Components _ Doorbell_Reed_R4.pdf

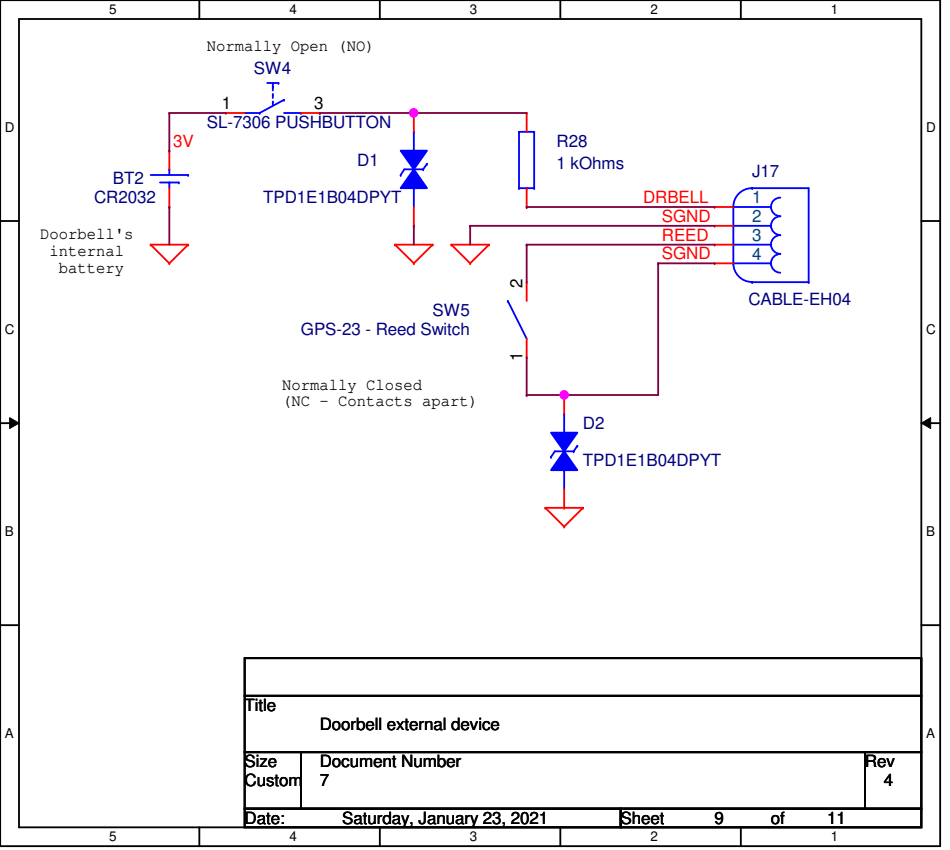
[picture p23: page 1]
Doorbell's internal battery; Title; Size; Document Number; Rev; Date:; Sheet; Custom; Saturday, January 23, 2021; SL-7306 PUSHBUTTON; R28 1 kOhms; TPD1E1B04DPYT; CABLE-EH04; SGND REED SGND; DRBELL

Normally Open (NO)

GPS-23 - Reed Switch

Normally Closed
(NC - Contacts apart)

Doorbell external device
