Elite-Capstone/Project-ShutTheFrontDoor/Hardware/Smart Door Design with ESP32/Components Schematics/Component _ Door Lock_R2.pdf

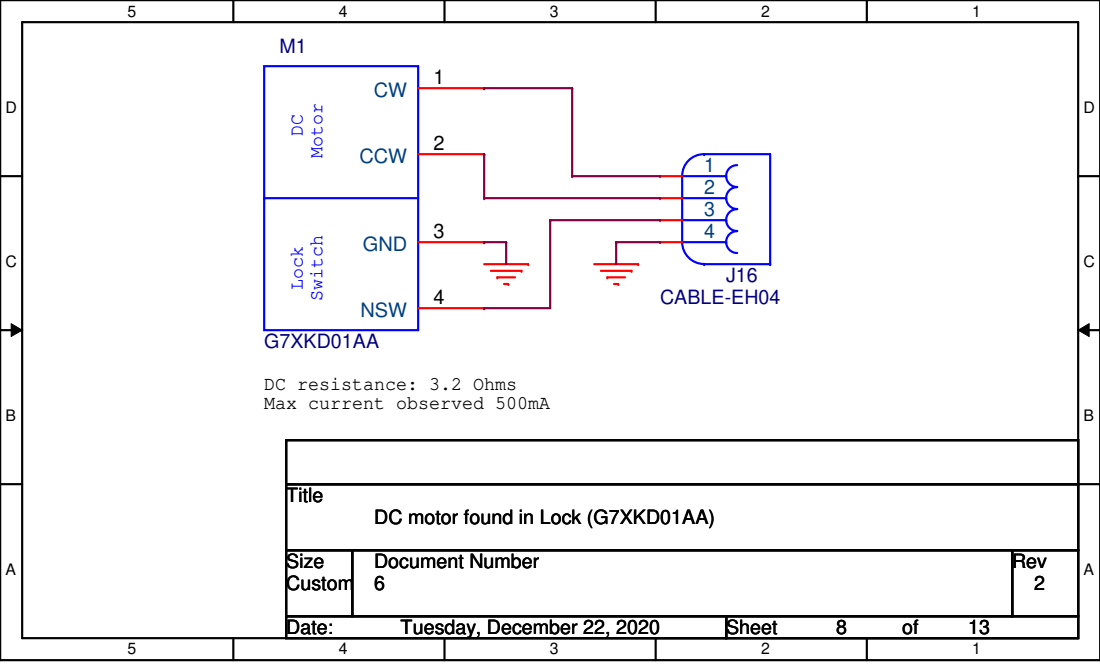
[picture p24: page 1]
Title; Size; Document Number; Rev; Date:; Sheet; Custom; Tuesday, December 22, 2020; Motor; Lock; Switch; G7XKD01AA; CCW; GND; NSW; J16 CABLE-EH04

DC resistance: 3.2 Ohms
Max current observed 500mA

DC motor found in Lock (G7XKD01AA)
