Elite-Capstone/Project-ShutTheFrontDoor/Hardware/Smart Door Design with ESP32/Components Schematics/Components _ Battery_R1.pdf

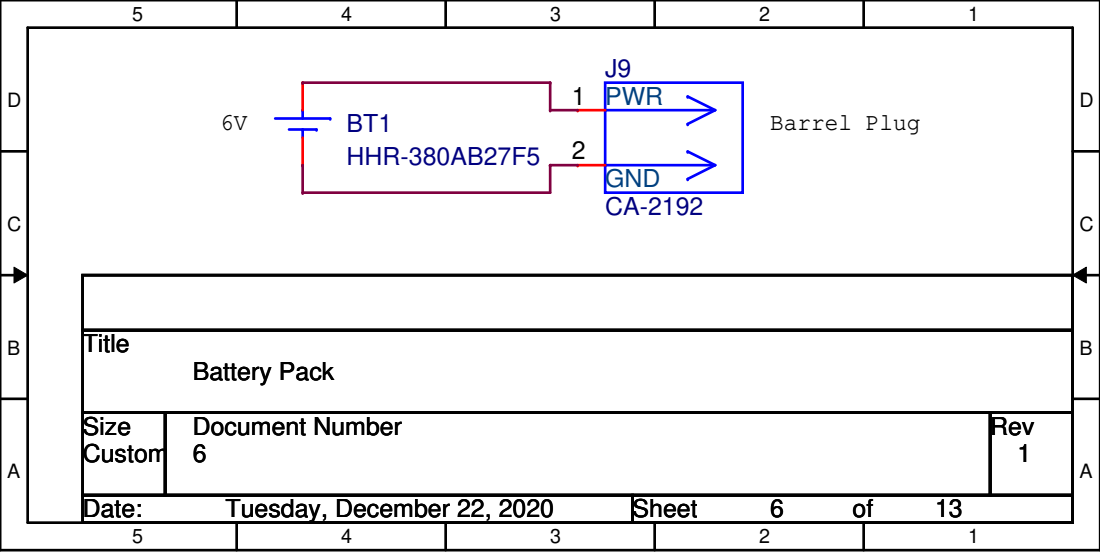
[picture p25: page 1]
Barrel Plug; Title; Size; Document Number; Rev; Date:; Sheet; Battery Pack; Custom; Tuesday, December 22, 2020; 1 PWR; GND; BT1 HHR-380AB27F5
