Elite-Capstone/Project-ShutTheFrontDoor/Hardware/Smart Door Design with ESP32/Components Schematics/Components _ Cam_and_MSensor_R3.pdf

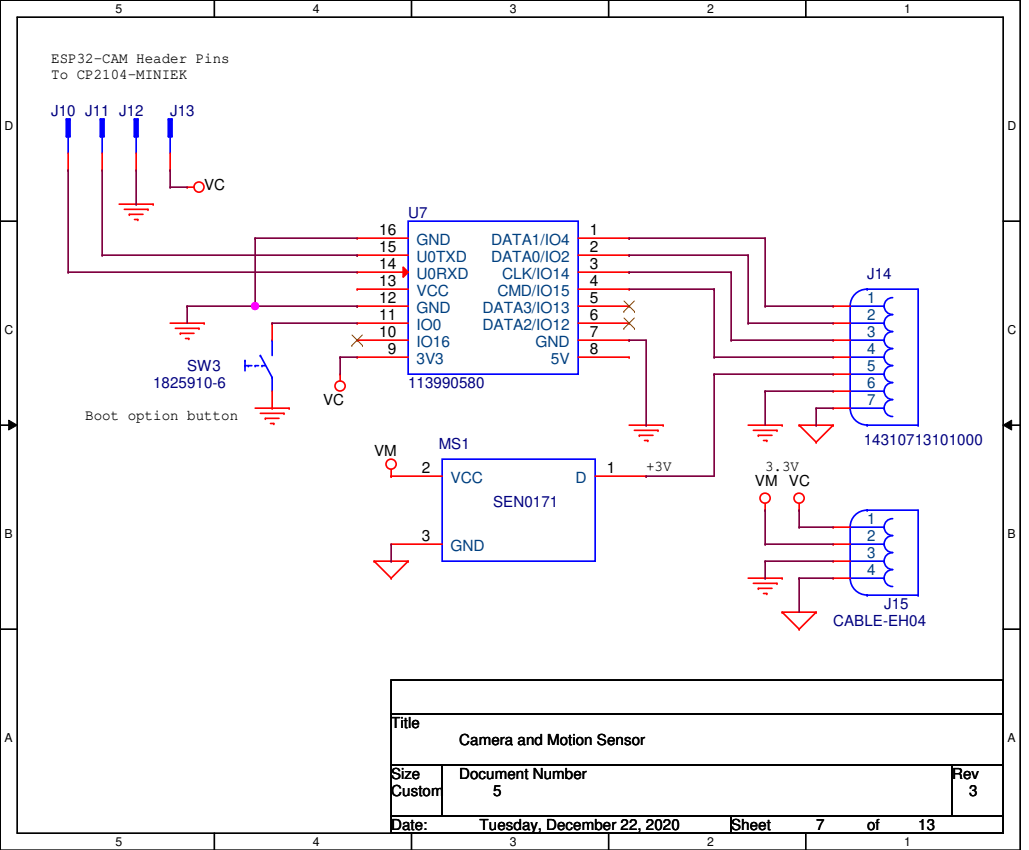
[picture p26: page 1]

ESP32-CAM Header Pins To CP2104-MINIEK | | J12 | | J13

Camera and Motion Sensor
