Elite-Capstone/Project-ShutTheFrontDoor/Hardware/Smart Door Design with ESP32/Components Schematics/Components _ Doorbell_Reed_R4.pdf

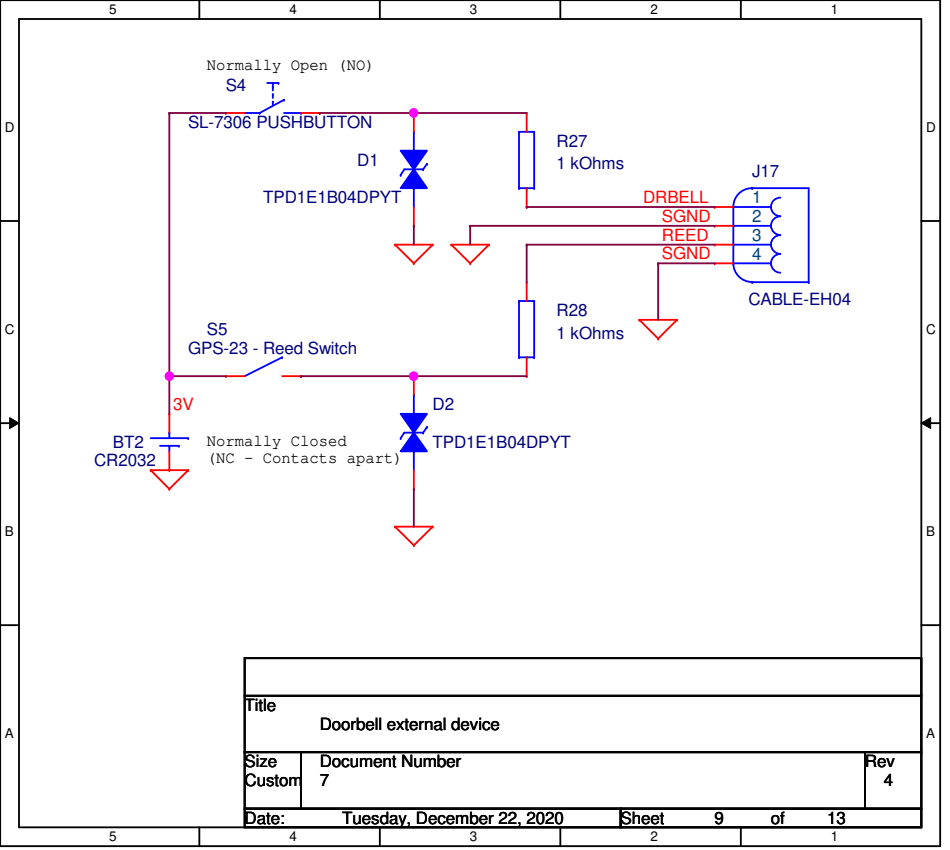
[picture p27: page 1]
Title; Size; Document Number; Rev; Date:; Sheet; Custom; Tuesday, December 22, 2020; CABLE-EH04; SL-7306 PUSHBUTTON; TPD1E1B04DPYT; 1 kOhms; R27 1 kOhms; SGND REED SGND; DRBELL

Normally Open (NO)

GPS-23 - Reed Switch

Normally Closed
(NC - Contacts apart)

Doorbell external device
