Elite-Capstone/Project-ShutTheFrontDoor/Hardware/Smart Door Design with ESP32/Team_26_Schematic_Diagrams/Camera-and-Motion-Sensor_V1.pdf

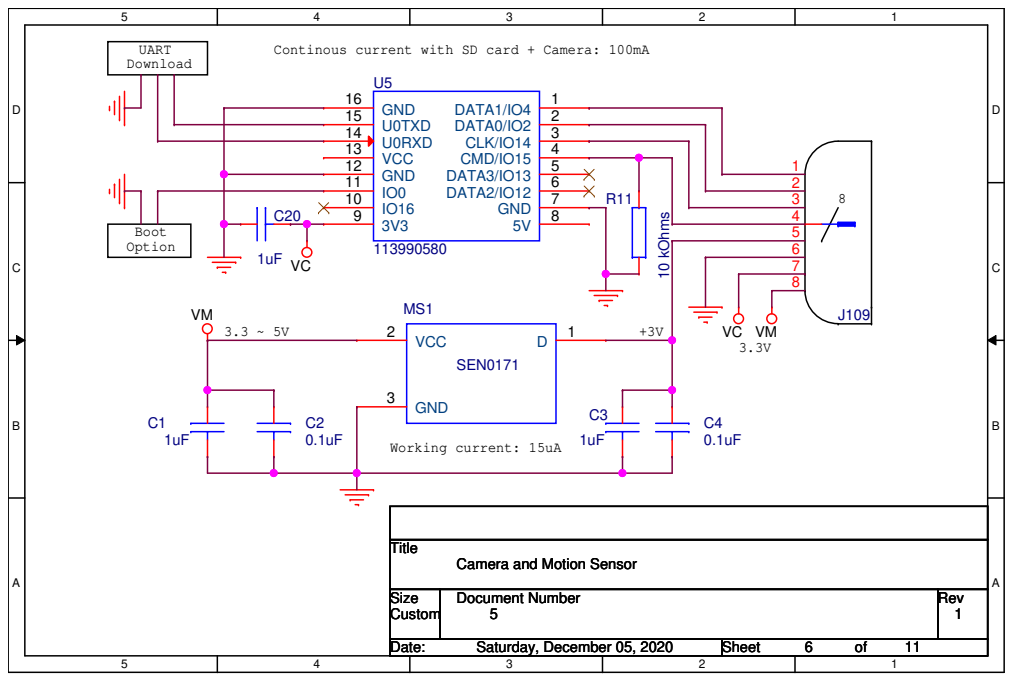
[picture p28: page 1]

Continous current with SD card + Camera: 100mA

Camera and Motion Sensor
