Elite-Capstone/Project-ShutTheFrontDoor/Hardware/Smart Door Design with ESP32/Team_26_Schematic_Diagrams/DC-motor-found-in-Lock_V1.pdf

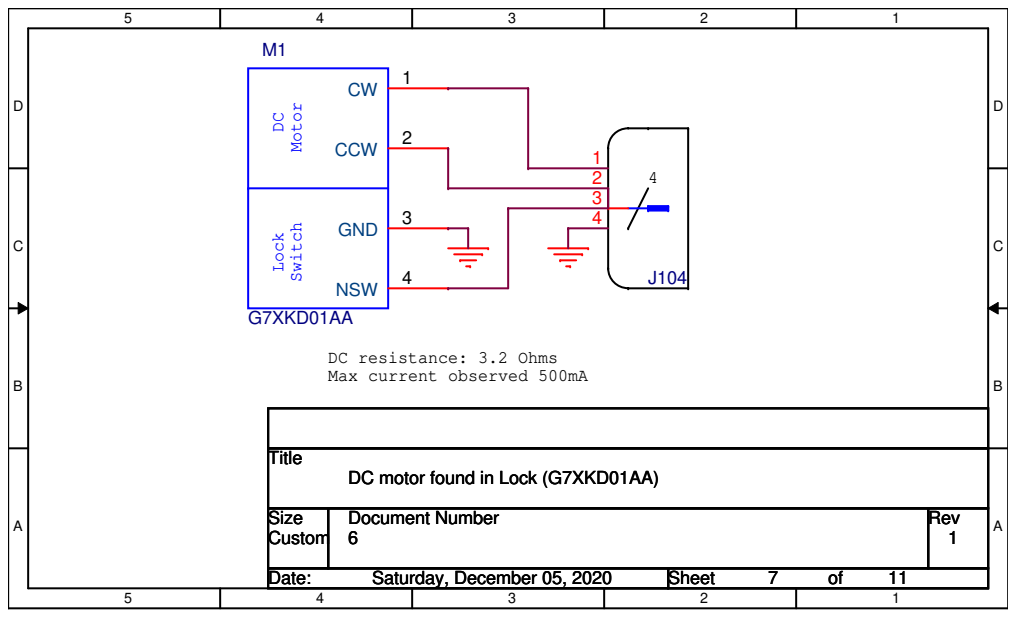
[picture p29: page 1]
Title; Size; Document Number; Rev; Date:; Sheet; Custom; Saturday, December 05, 2020; Motor; Lock; Switch; G7XKD01AA; CCW; GND; NSW

DC resistance: 3.2 Ohms
Max current observed 500mA

DC motor found in Lock (G7XKD01AA)
