Elite-Capstone/Project-ShutTheFrontDoor/Hardware/Smart Door Design with ESP32/Team_26_Schematic_Diagrams/Doorbell-external-device_V1.pdf

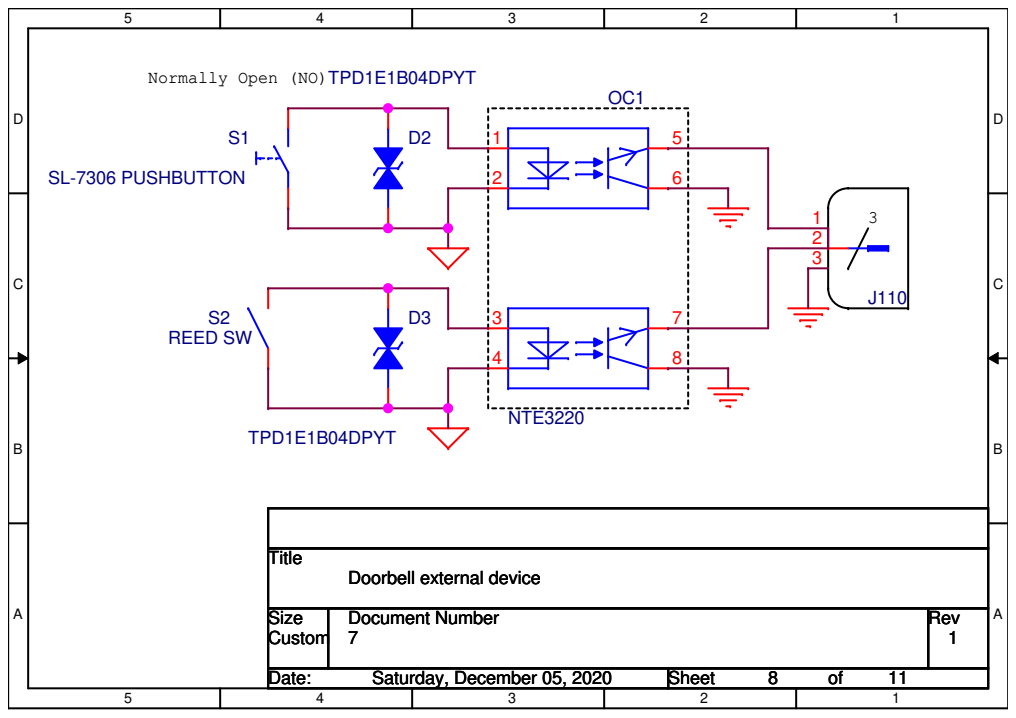
[picture p30: page 1]
Title; Size; Document Number; Rev; Date:; Sheet; Custom; Saturday, December 05, 2020; TPD1E1B04DPYT; SL-7306 PUSHBUTTON; NTE3220; S2 REED SW

Normally Open (NO)

Doorbell external device
