Elite-Capstone/Project-ShutTheFrontDoor/Hardware/Smart Door Design with ESP32/Team_26_Schematic_Diagrams/LCD-Display_V1.pdf

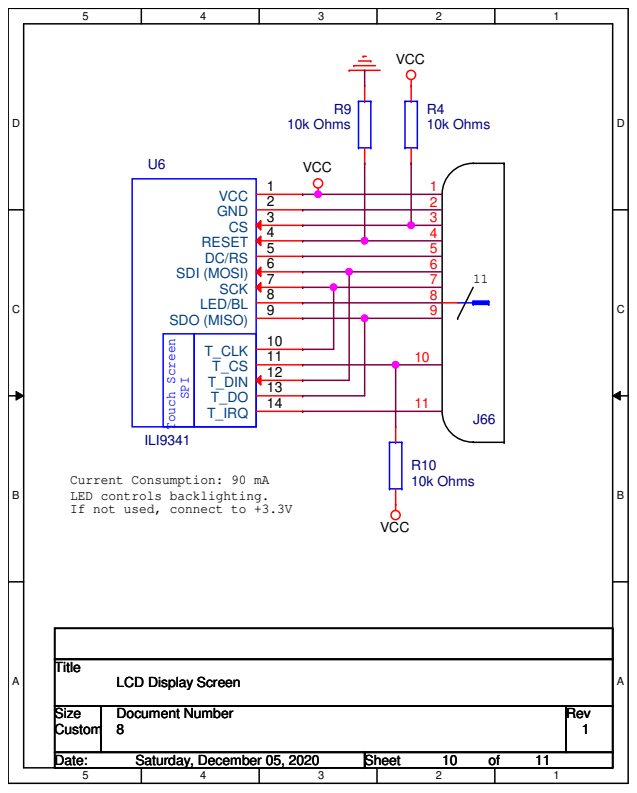
[picture p31: page 1]
VCC; Title; Size; Document Number; Rev; Date:; Sheet; Custom; Saturday, December 05, 2020; R10 10k Ohms; R9 10k Ohms; R4 10k Ohms; Touch Screen; SPI; ILI9341; GND; RESET; SDI (MOSI); SCK; LED/BL; SDO (MISO); T_CLK; T_DIN; T_IRQ

Current Consumption: 90 mA
LED controls backlighting.
If not used, connect to +3.3V

LCD Display Screen
