Elite-Capstone/Project-ShutTheFrontDoor/Hardware/Smart Door Design with ESP32/Team_26_Schematic_Diagrams/Purchased-Lock-Block-Diagram_V1.pdf

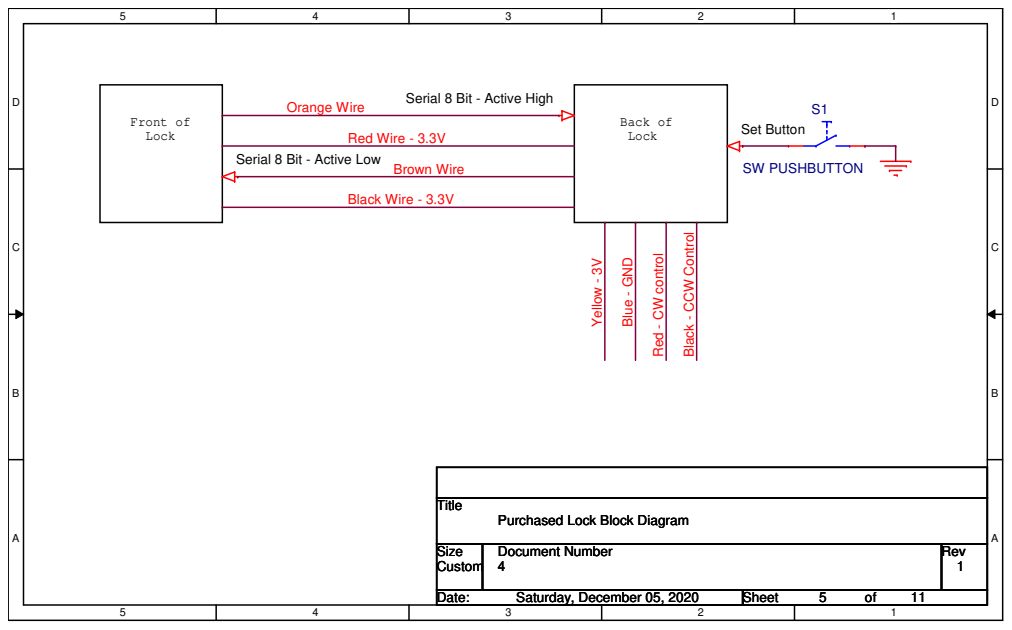
[picture p32: page 1]
Back of; Lock; Front of; Set Button; Title; Size; Document Number; Rev; Date:; Sheet; Custom; Saturday, December 05, 2020; SW PUSHBUTTON; Orange Wire; Red Wire - 3.3V; Black Wire - 3.3V; Brown Wire; Yellow - 3V; Blue - GND

Serial 8 Bit - Active High

Serial 8 Bit - Active Low

Black - CCW Control

Red - CW control

Purchased Lock Block Diagram
