Elite-Capstone/Project-ShutTheFrontDoor/Hardware/Smart Door Design with ESP32/Team_26_Schematic_Diagrams/Smart Door _ 01_Main Design.pdf

# Motion SensorTo LCD Screen

## R1¹⁰ kOhms

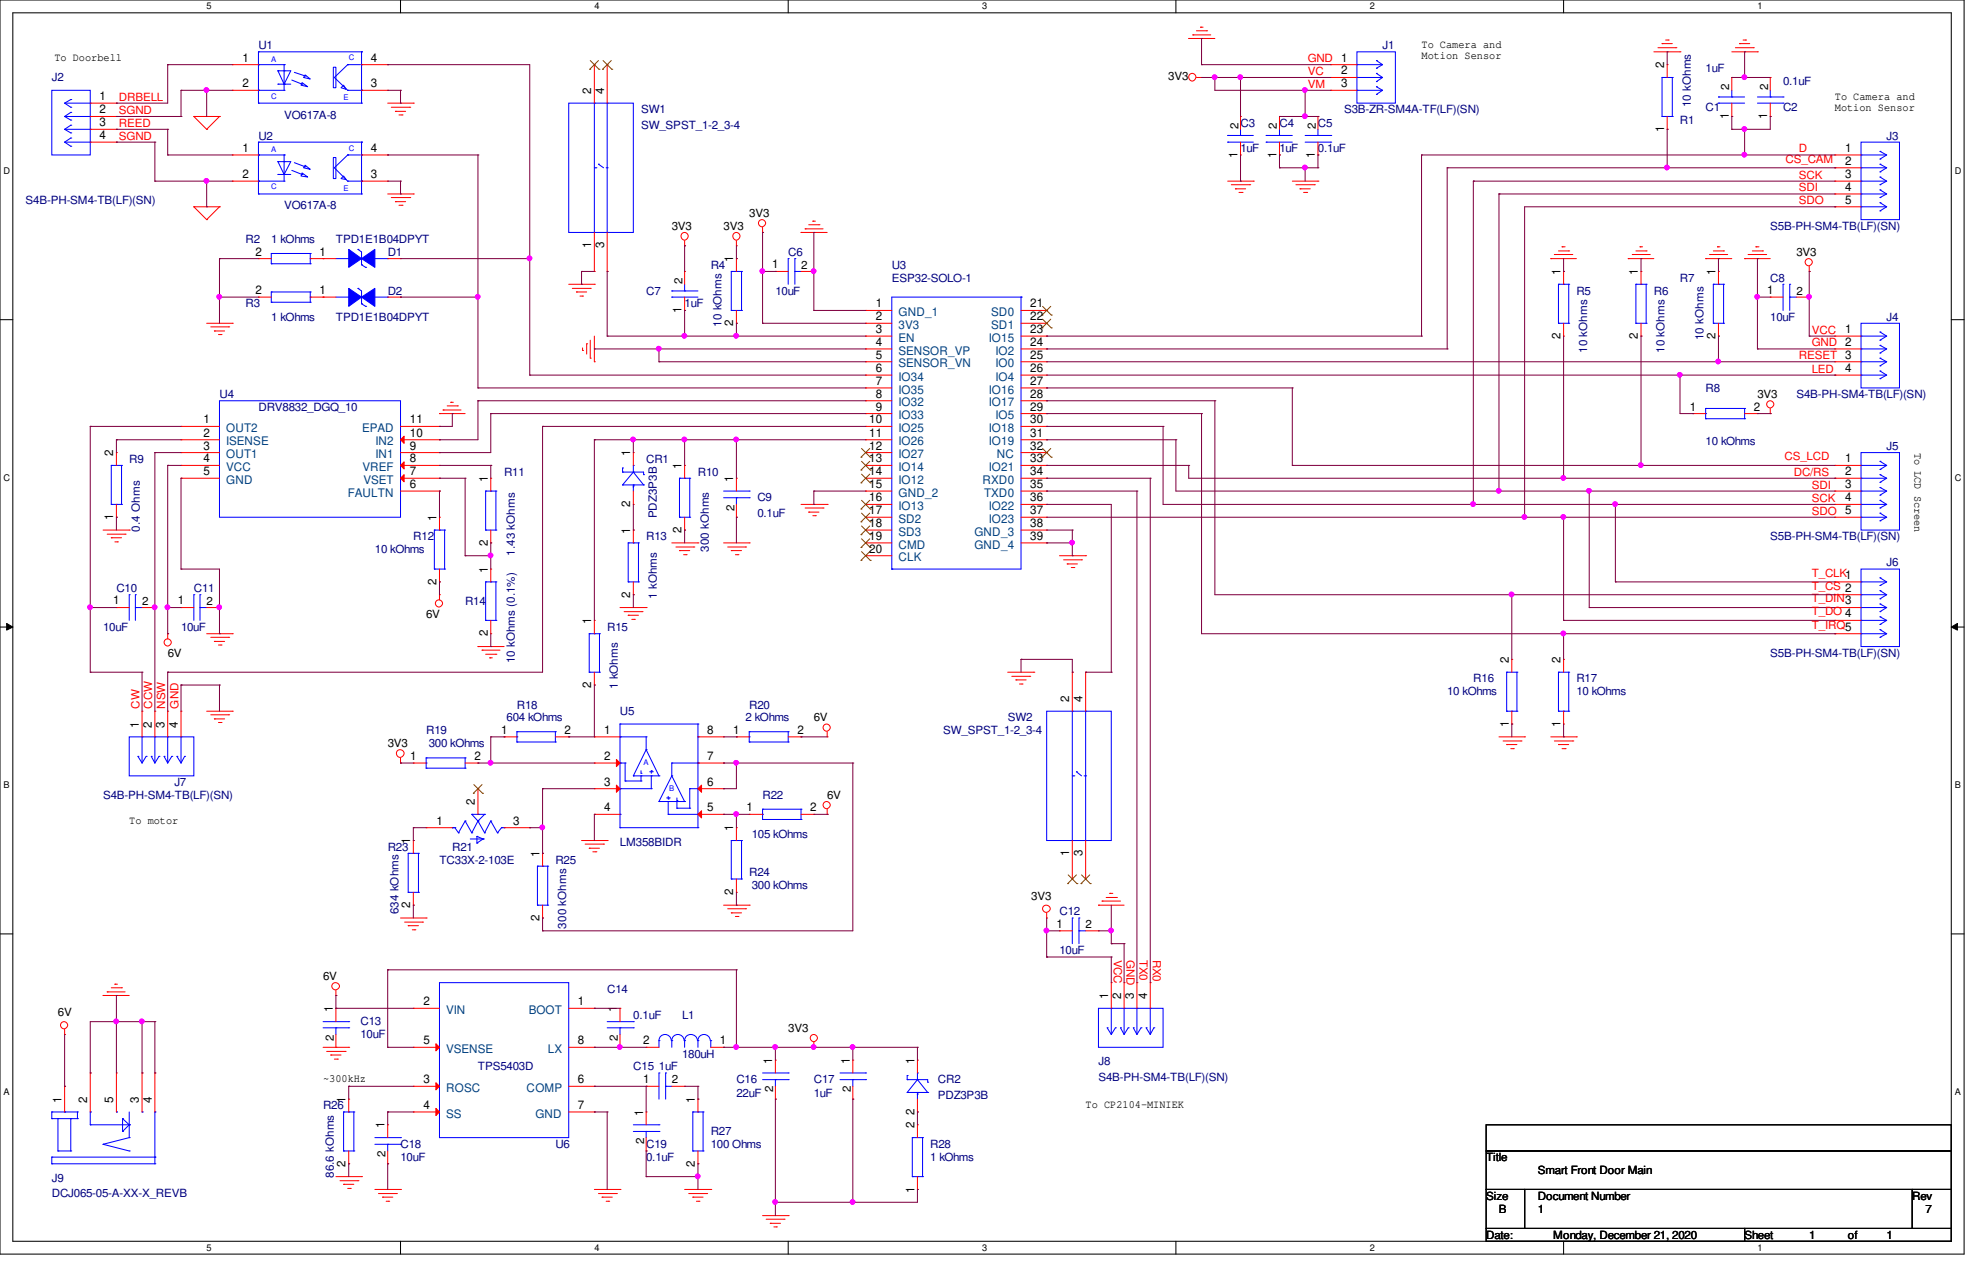
[picture p33: page 1]

GND_2 15 | 35

Smart Front Door Main
