Elite-Capstone/Project-ShutTheFrontDoor/Hardware/Smart Door Design with ESP32/Team_26_Schematic_Diagrams/System-Block-Diagram_V1.pdf

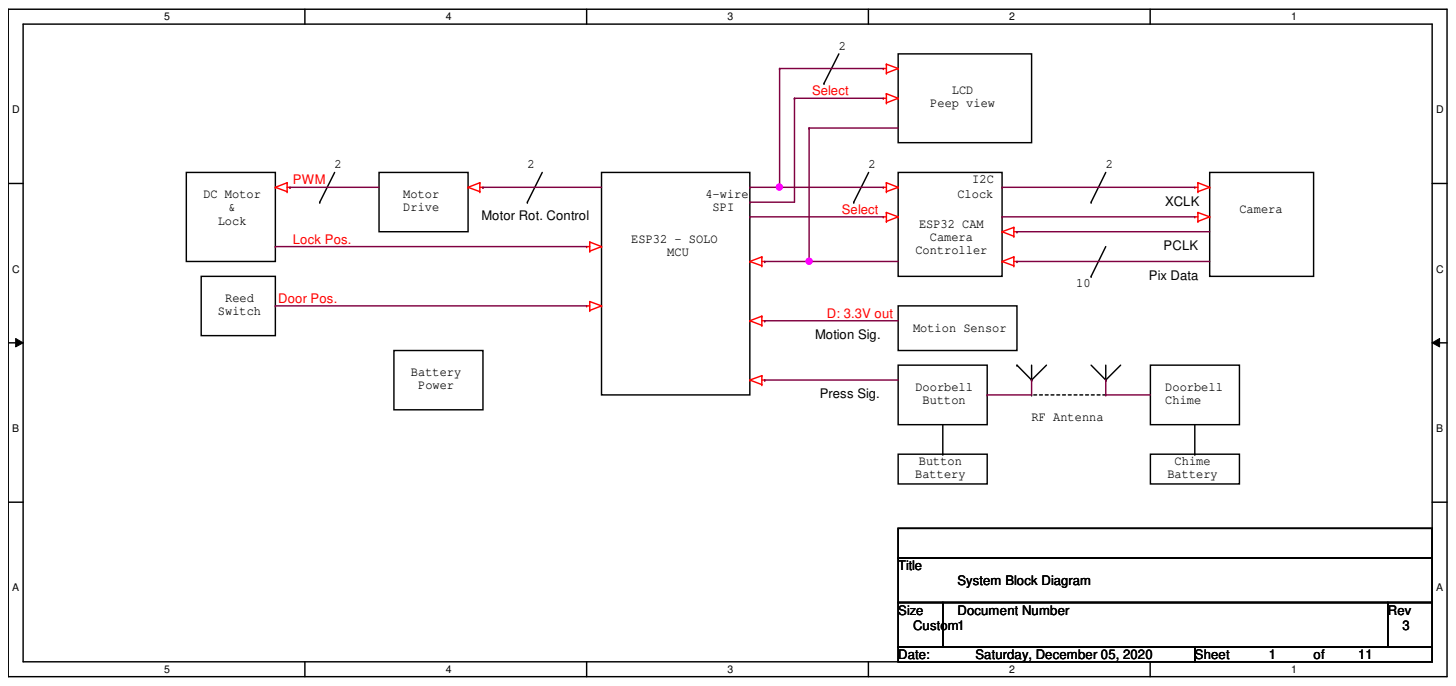
[picture p34: page 1]
ESP32 - SOLO MCU; Motor Drive; ESP32 CAM Camera Controller; Motion Sensor; Doorbell Chime; Battery Power; Clock; LCD Peep view; RF Antenna; Doorbell Button; Button Battery; 4-wire; SPI; Camera; DC Motor & Lock; Reed Switch; Chime Battery; XCLK; PCLK; Pix Data; Press Sig.; Motion Sig.; Title; Size; Document Number; Rev; Date:; Sheet; Custom; Saturday, December 05, 2020; D: 3.3V out; Lock Pos.; PWM; Select; Door Pos.

Motor Rot. Control

System Block Diagram
