Elite-Capstone/Project-ShutTheFrontDoor/Hardware/Smart Door Design with ESP32/ESP32-SOLO-1_Reference_Design/01_Schematic/ESP32-SOLO-1_V1_0316.pdf

## The capacitance of C1 and C2 varies

with the selection of the crystal.

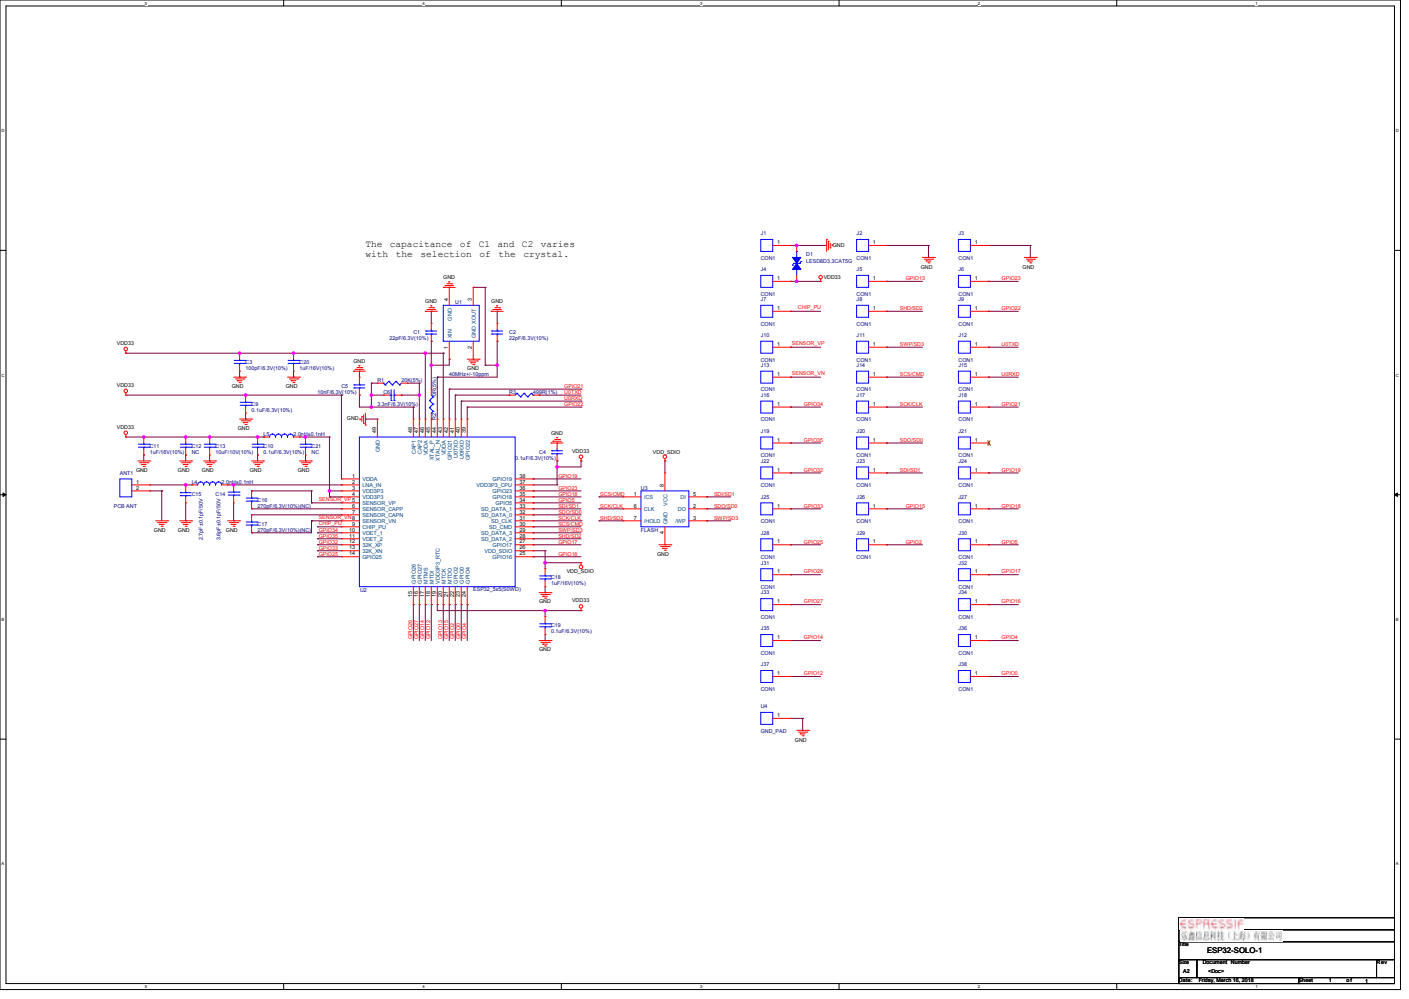
[picture p35: page 1]
