Elite-Capstone/Project-ShutTheFrontDoor/Sketches/software flowcharts.pdf

Door Button | Camera Feed

# Event Notifications

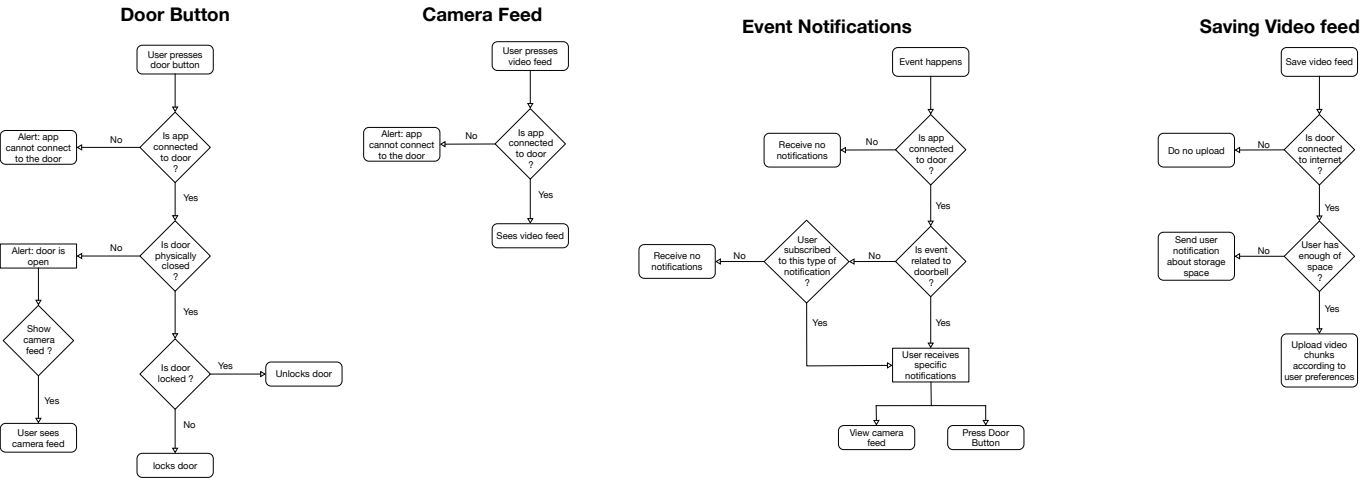
[picture p36: page 1]
User presses door button; Is door; locked ?; Unlocks door; locks door; Yes; Is app; connected to door ?; Is door physically closed ?; Alert: door is; open; Show camera feed ?; User sees camera feed; User presses video feed; Event happens; Receive no notifications; Is event related to doorbell ?; User subscribed to this type of notification ?; User receives specific notifications; View camera feed; Press Door Button; Receive no; notifications; Is door connected to internet ?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

Saving Video feed

Save video feed

Alert: app
cannot connect
to the door

No Do no upload

Sees video feed
