Elite-Capstone/Project-ShutTheFrontDoor/Hardware/Product Orders/Digi_key_order_feb_06.pdf

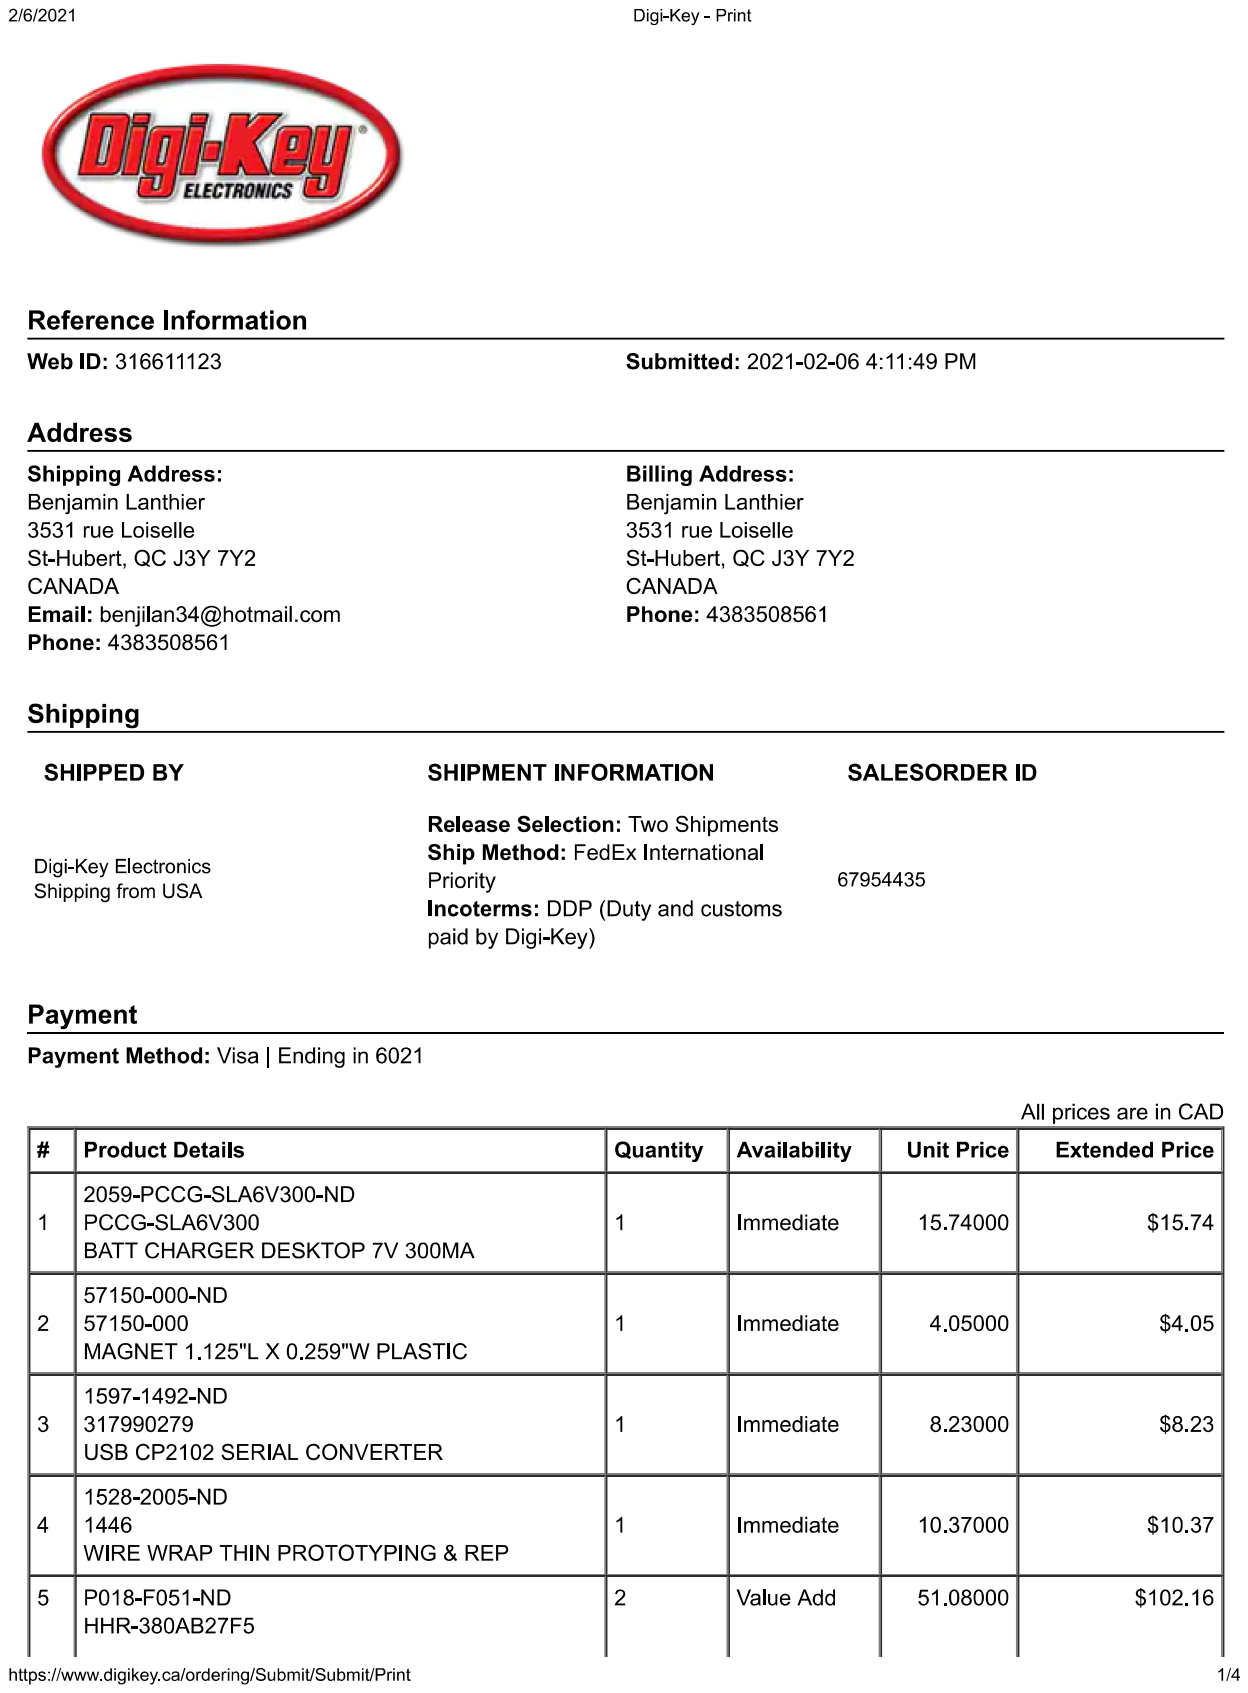
[picture p37: page 1]

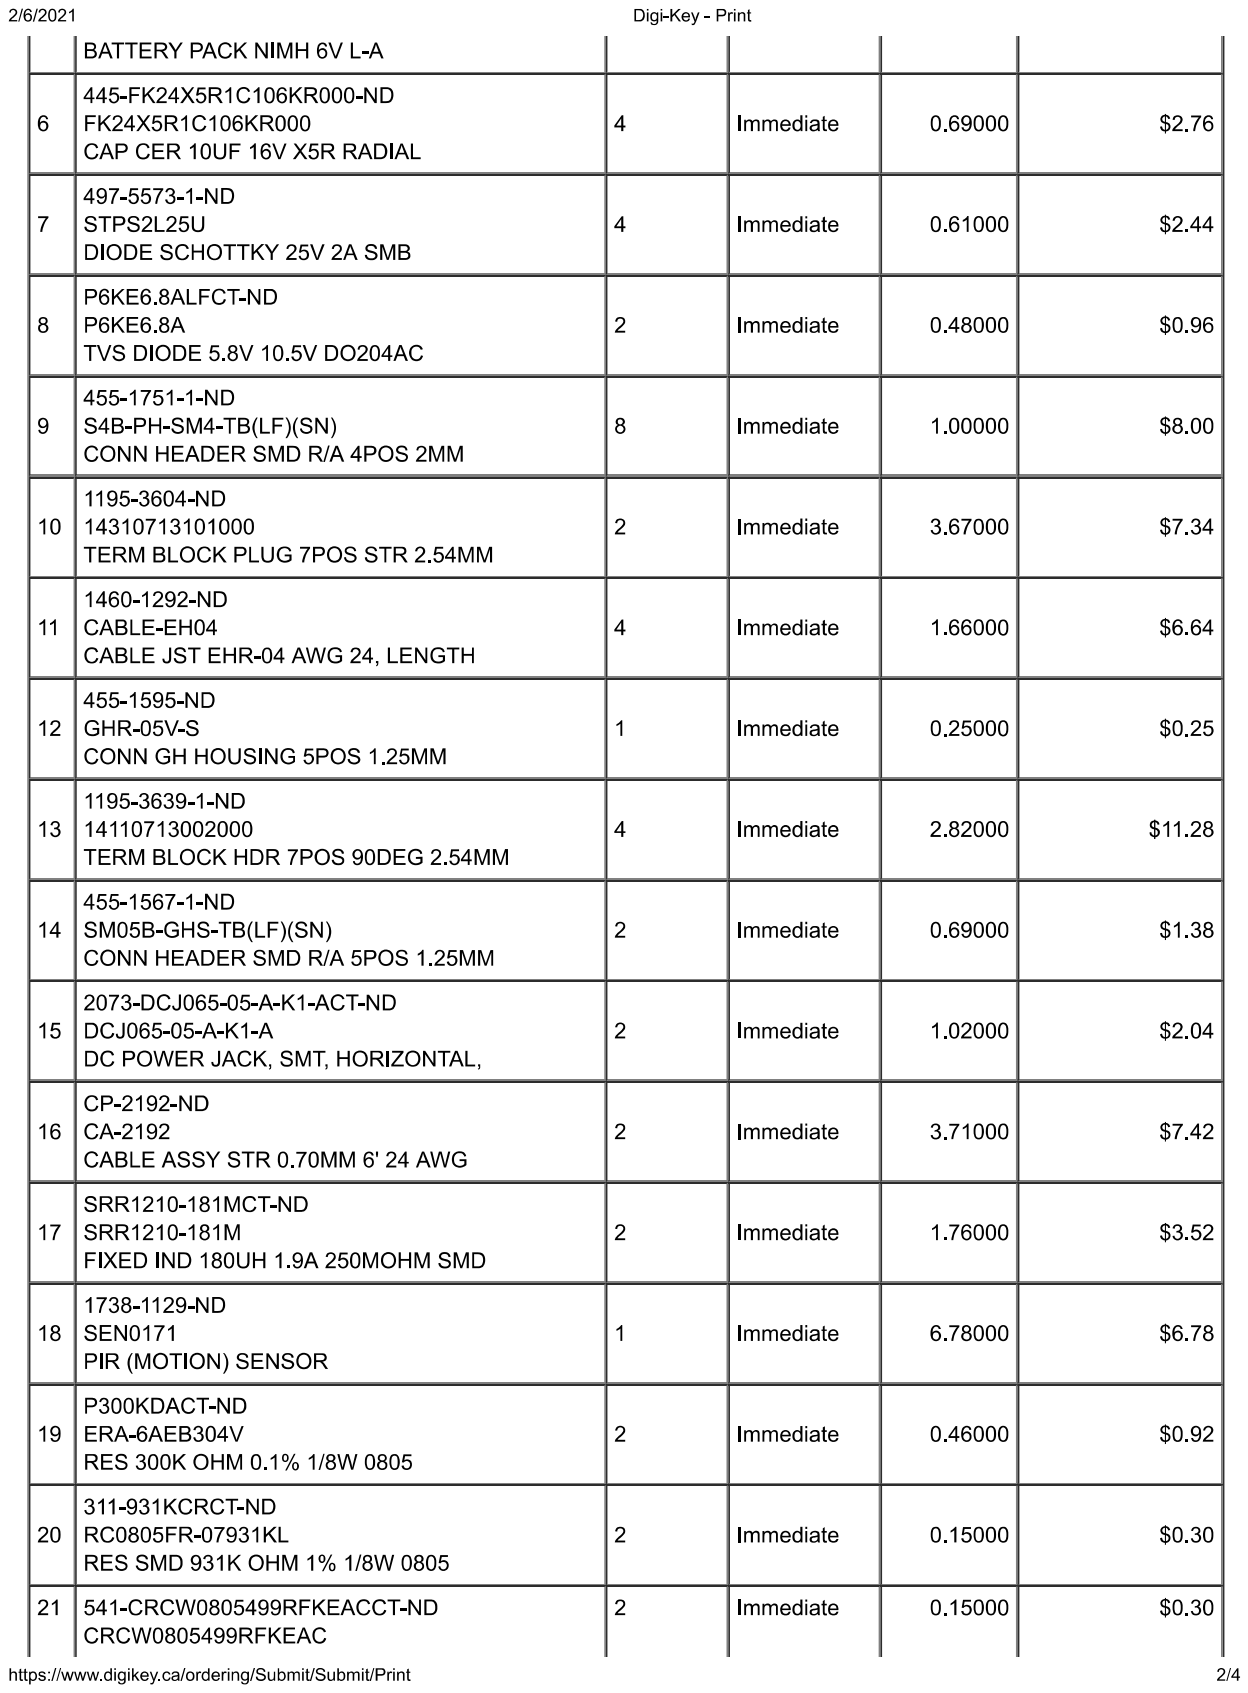
[picture p38: page 2]

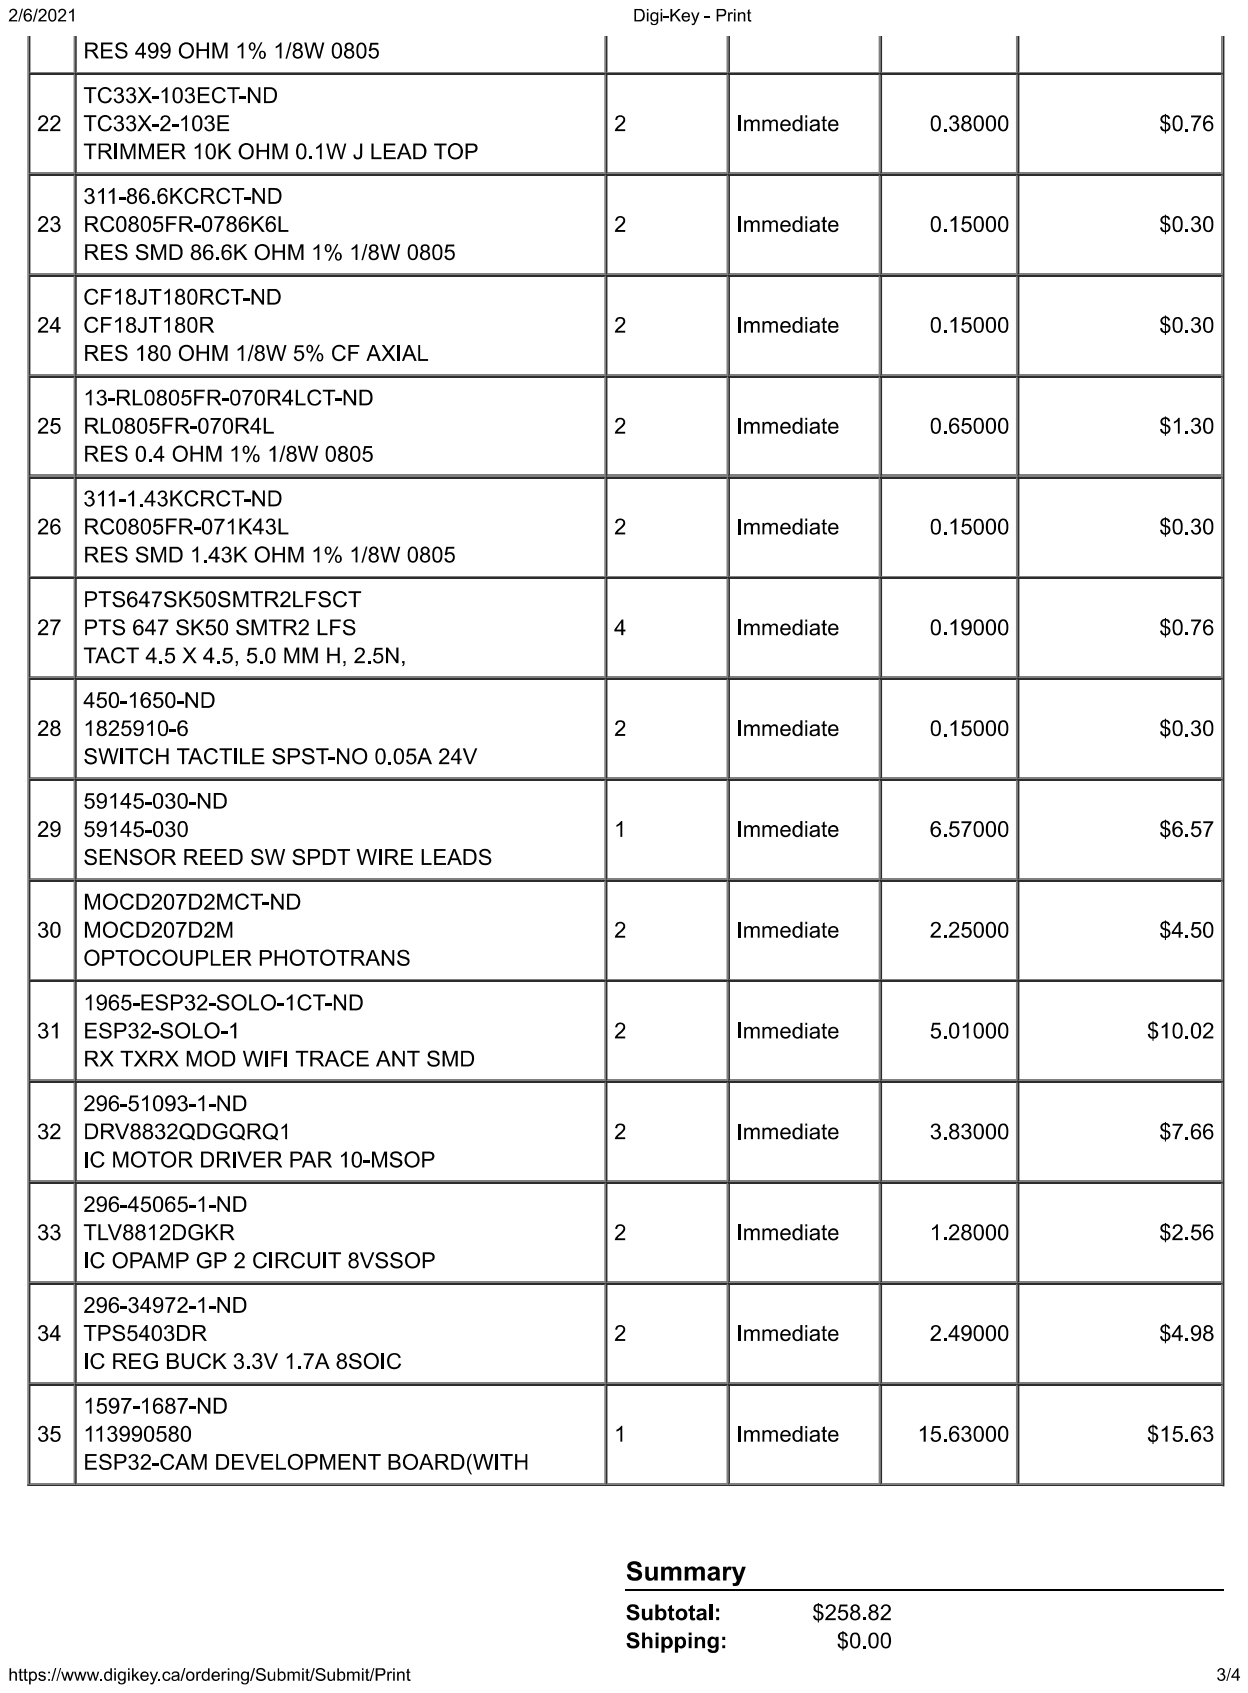
[picture p39: page 3]

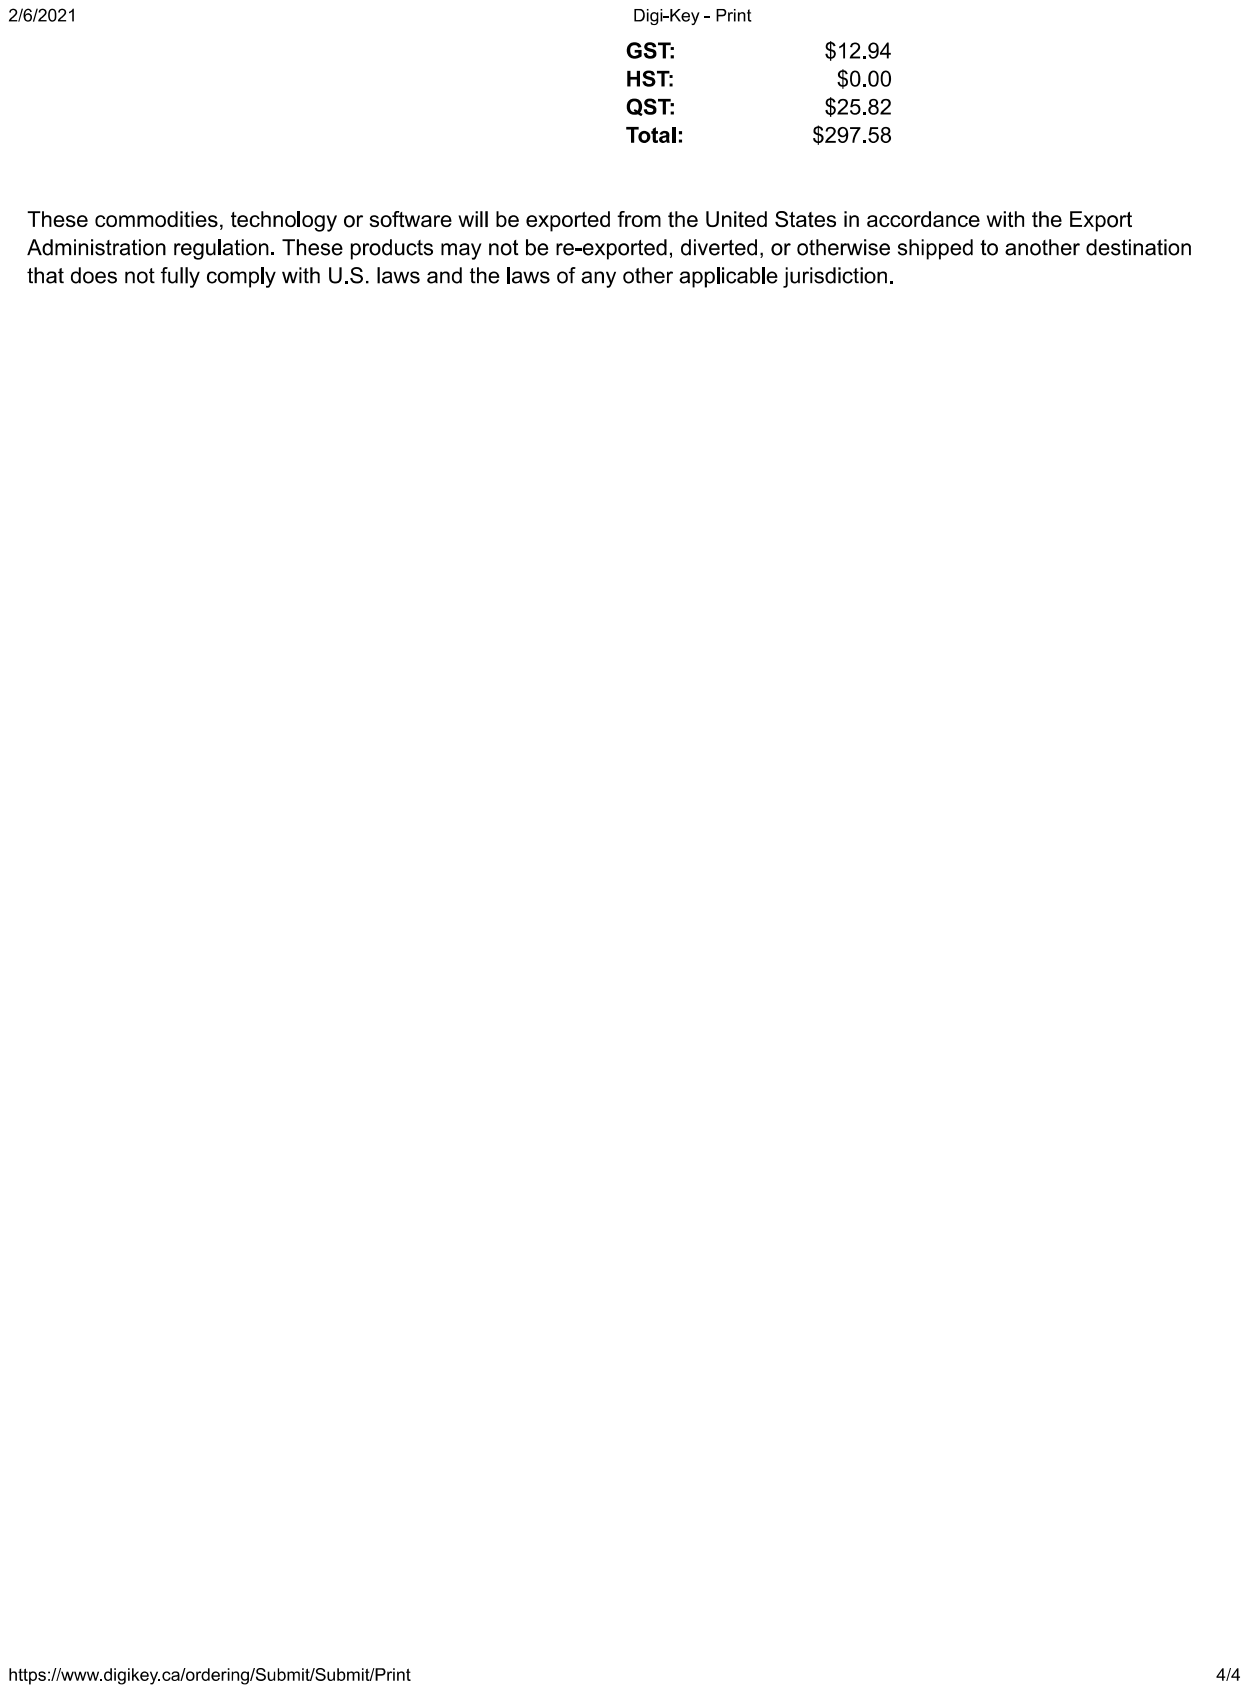
[picture p40: page 4]
