Elite-Capstone/Project-ShutTheFrontDoor/Hardware/Smart Door Design with ESP32/Team_26_Smart Door_Main_Board_R8.pdf

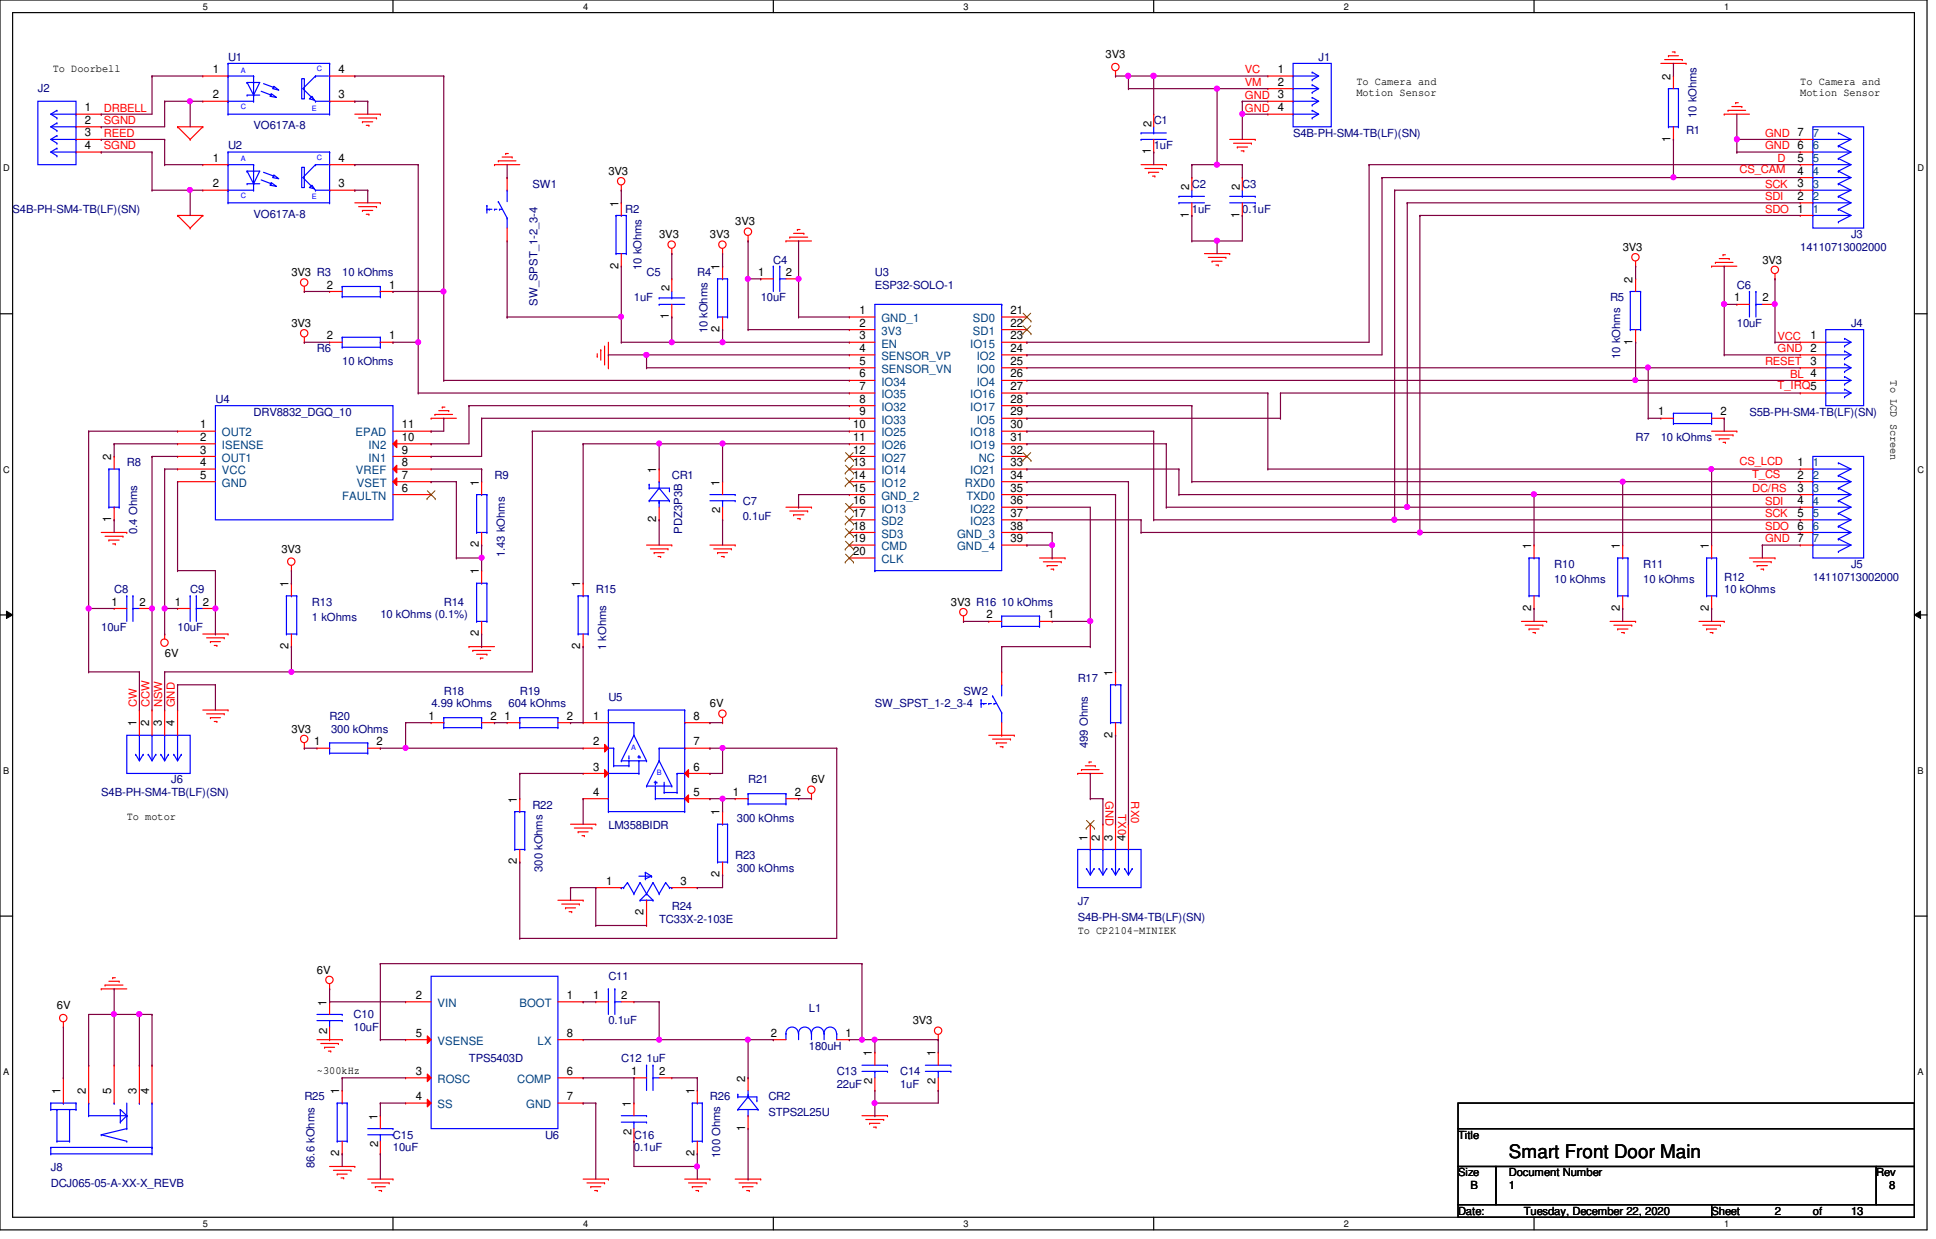
[picture p41: page 1]

Title
Smart Front Door Main
