Elite-Capstone/Project-ShutTheFrontDoor/Hardware/Team26 _ Schematics/Smart Door _ Main_Board_R9.pdf

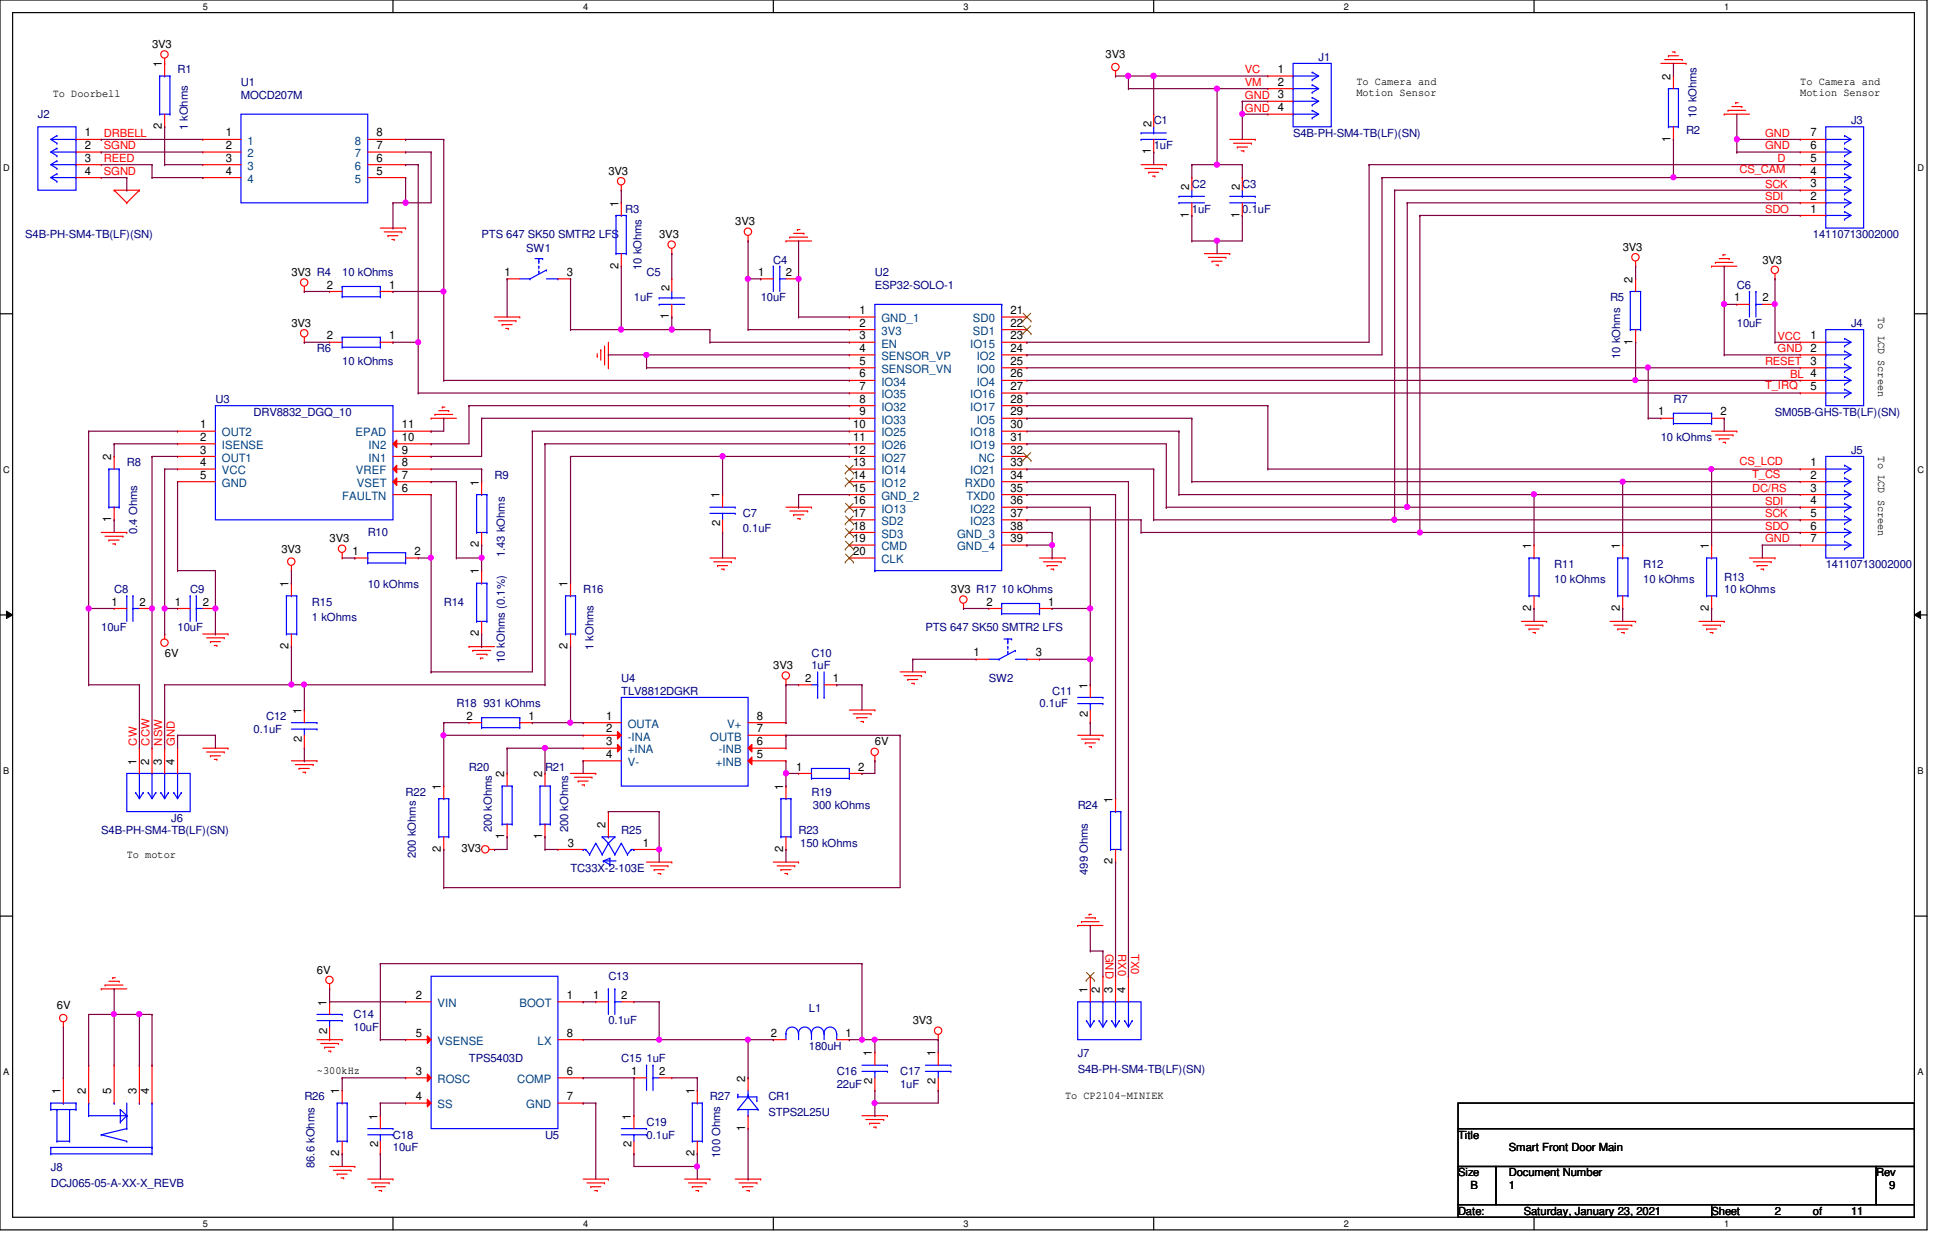
[picture p42: page 1]

SM05B-GHS-TB(LF)(SN)

Smart Front Door Main
