Elite-Capstone/Project-ShutTheFrontDoor/Hardware/Smart Door Design with ESP32/Team_26_Schematic_Diagrams/Smart-Door-System-Schematic_V4.pdf

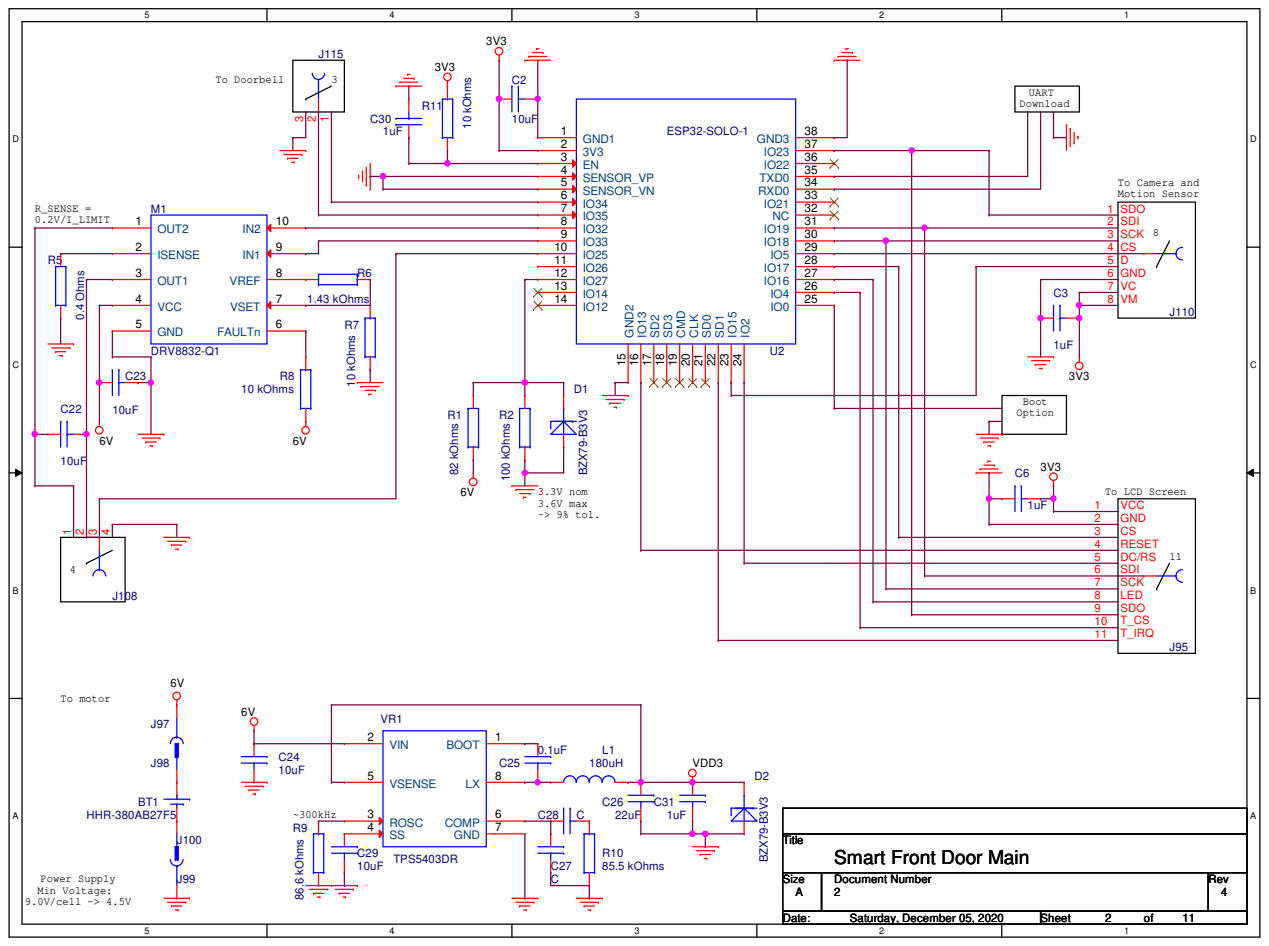
[picture p43: page 1]

Title
Smart Front Door Main
