Elite-Capstone/Project-ShutTheFrontDoor/Hardware/Smart Door Design with ESP32/Team_26_Schematic_Diagrams/Smart_Door_Main_PCB.pdf

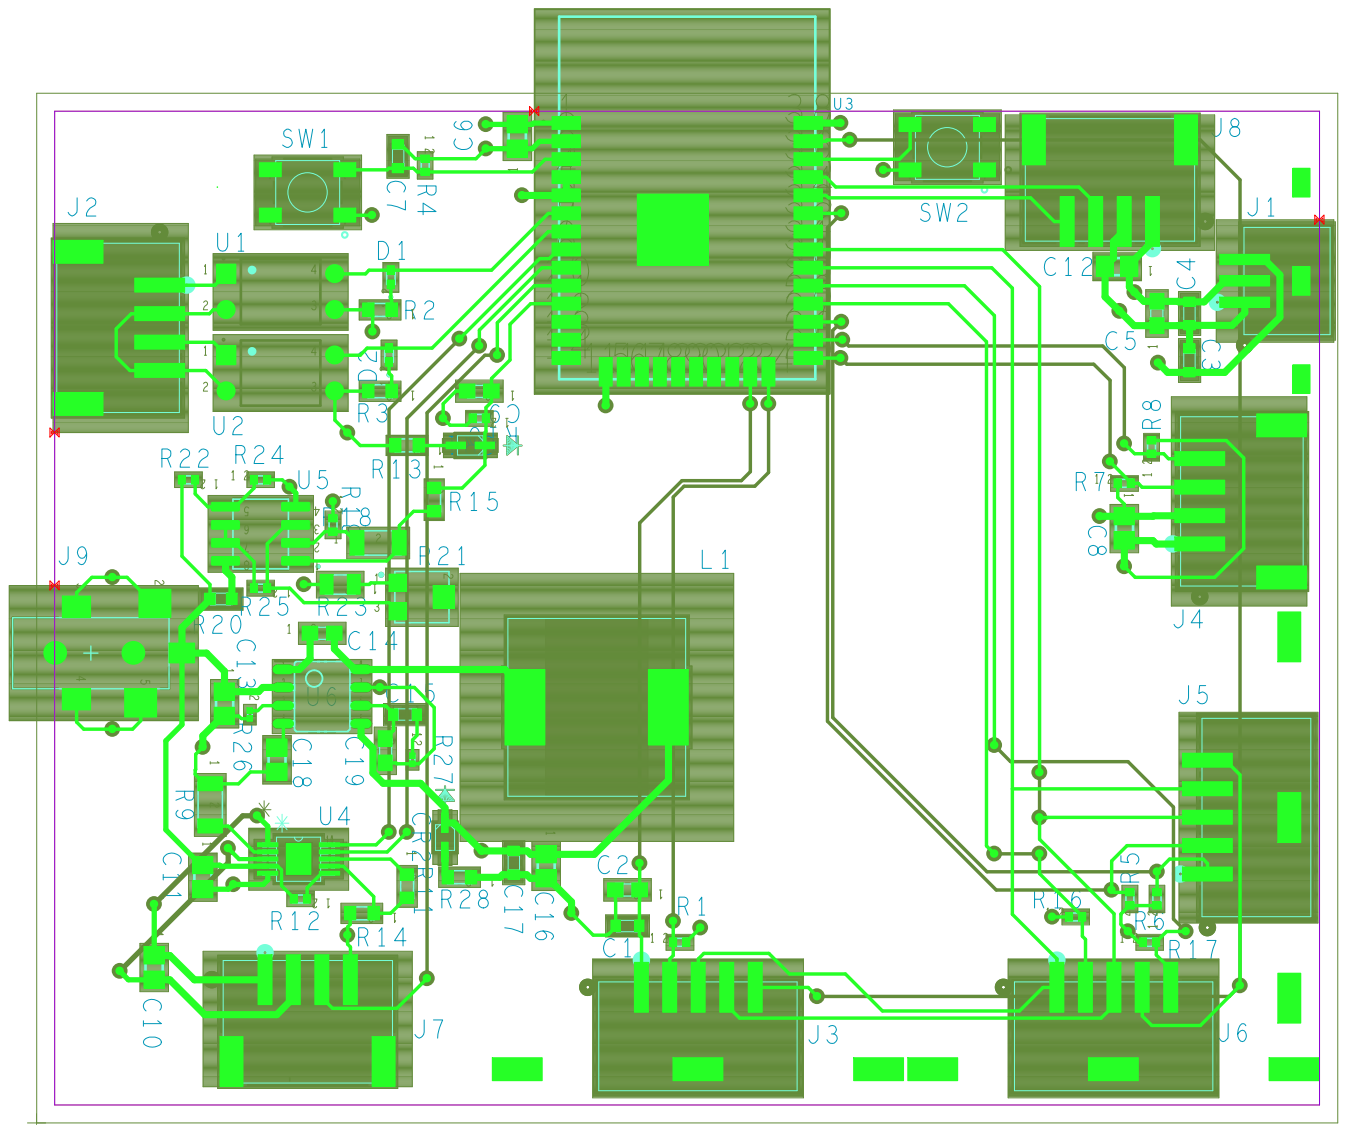
[picture p44: page 1]
