Elite-Capstone/Project-ShutTheFrontDoor/Hardware/Smart Door Design with ESP32/Team_26_Schematic_Diagrams/Smart-Door-System-Schematic_V3.pdf

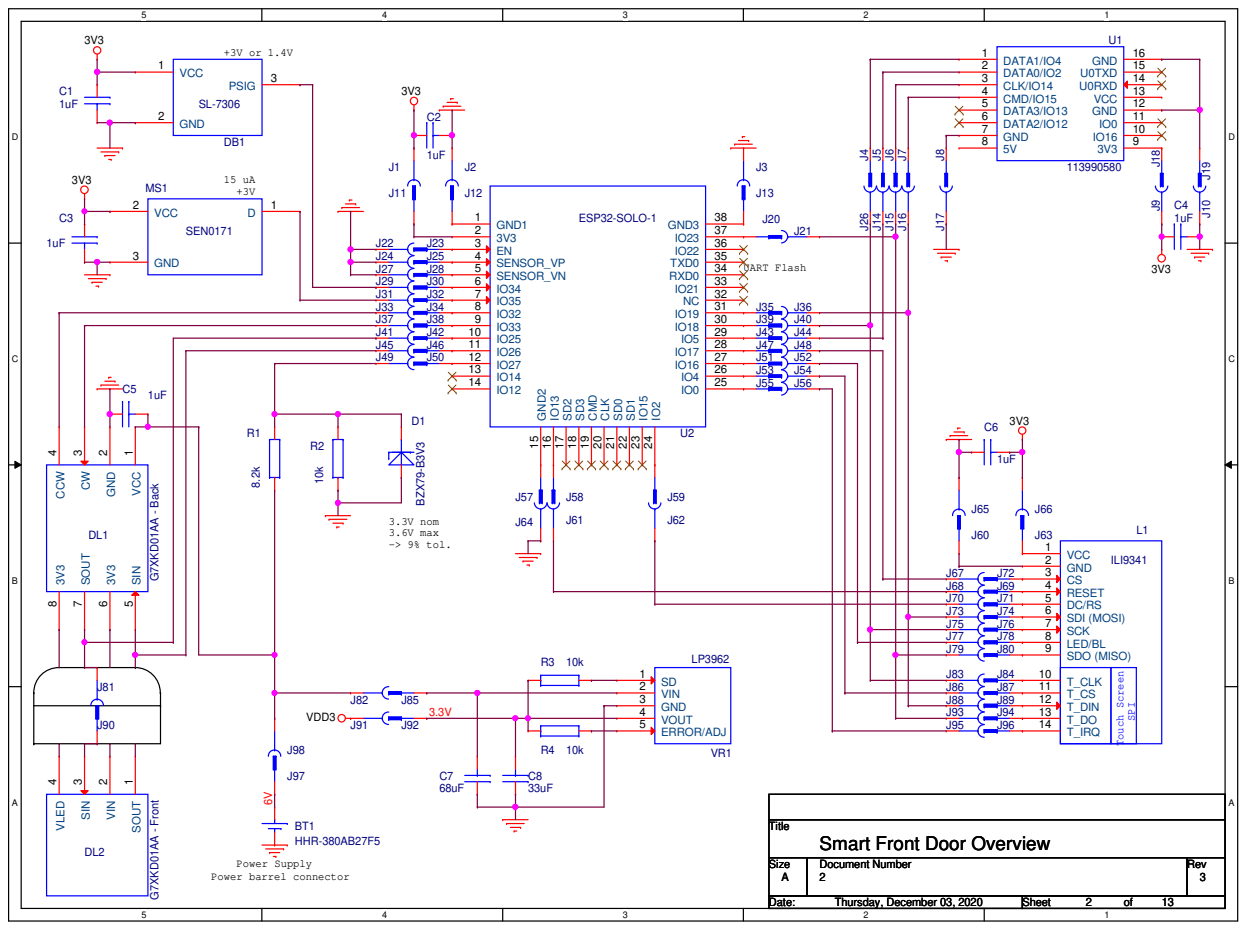
[picture p46: page 1]

Title
Smart Front Door Overview
