Elite-Capstone/Project-ShutTheFrontDoor/(list of files, drawings)

Other design files:
Hardware/Smart Door Design with ESP32/ESP32-SOLO-1_Reference_Design/01_Schematic/esp32-solo-1_v1_0316.opj
Hardware/Smart Door Design with ESP32/ESP32-SOLO-1_Reference_Design/01_Schematic/SMARTDOOR.OLB
Hardware/Smart Door Design with ESP32/ESP32-SOLO-1_Reference_Design/01_Schematic/smartdoor.opj
Hardware/Smart Door Design with ESP32/ESP32-SOLO-1_Reference_Design/02_PCB Layout/ESP32-SOLO-1_V1.pcb
