Elite-Capstone/Project-ShutTheFrontDoor/Hardware/ESP/main-app/components/peripherals/include/stfd_gpio_config.h

/*
    Project:    ShutTheFrontDoor
    File:       stfd_gpio_config.h
    Author:     Benjamin Lanthier
    Date:       06/03/2021

    Desc:       This file contains the gpio setup and gpio assignment 
                error detection for both input/output
                Sets up the following GPIOs:
                    GPIO_INPUT_BOOT             (Boot button)
                    GPIO_INPUT_MS               (Motion Sensor)
                    GPIO_INPUT_MOTOR_FAULT      (Motor fault current detection)
                    GPIO_INPUT_NSW              (N-switch)
                    GPIO_INPUT_BATTERY
                    GPIO_INPUT_DRBELL_NOTIF     (Doorbell button press)
                    GPIO_INPUT_REEDSW_STATUS    (Reed switch current status)

                    GPIO_OUTPUT_MOTOR_IN1       (Clockwise rotation output)
                    GPIO_OUTPUT_MOTOR_IN2       (Counter-clockwise rotation output)
*/

#include <string.h>

//===========================================
//
//              INPUT CONFIG
//
//===========================================

#if CONFIG_MAIN_MCU

    #if CONFIG_GPIO_INPUT_0_BOOT
    #define GPIO_INPUT_BOOT 0
    #elif CONFIG_GPIO_INPUT_2_BOOT
    #define GPIO_INPUT_BOOT 2
    #elif CONFIG_GPIO_INPUT_4_BOOT
    #define GPIO_INPUT_BOOT 4
    #elif CONFIG_GPIO_INPUT_5_BOOT
    #define GPIO_INPUT_BOOT 5
    #elif CONFIG_GPIO_INPUT_6_BOOT
    #define GPIO_INPUT_BOOT 6
    #elif CONFIG_GPIO_INPUT_7_BOOT
    #define GPIO_INPUT_BOOT 7
    #elif CONFIG_GPIO_INPUT_8_BOOT
    #define GPIO_INPUT_BOOT 8
    #elif CONFIG_GPIO_INPUT_9_BOOT
    #define GPIO_INPUT_BOOT 9
    #elif CONFIG_GPIO_INPUT_10_BOOT
    #define GPIO_INPUT_BOOT 10
    #elif CONFIG_GPIO_INPUT_11_BOOT
    #define GPIO_INPUT_BOOT 11
    #elif CONFIG_GPIO_INPUT_12_BOOT
    #define GPIO_INPUT_BOOT 12
    #elif CONFIG_GPIO_INPUT_13_BOOT
    #define GPIO_INPUT_BOOT 13
    #elif CONFIG_GPIO_INPUT_14_BOOT
    #define GPIO_INPUT_BOOT 14
    #elif CONFIG_GPIO_INPUT_15_BOOT
    #define GPIO_INPUT_BOOT 15
    #elif CONFIG_GPIO_INPUT_16_BOOT
    #define GPIO_INPUT_BOOT 16
    #elif CONFIG_GPIO_INPUT_17_BOOT
    #define GPIO_INPUT_BOOT 17
    #elif CONFIG_GPIO_INPUT_18_BOOT
    #define GPIO_INPUT_BOOT 18
    #elif CONFIG_GPIO_INPUT_19_BOOT
    #define GPIO_INPUT_BOOT 19
    #elif CONFIG_GPIO_INPUT_21_BOOT
    #define GPIO_INPUT_BOOT 21
    #elif CONFIG_GPIO_INPUT_22_BOOT
    #define GPIO_INPUT_BOOT 22
    #elif CONFIG_GPIO_INPUT_23_BOOT
    #define GPIO_INPUT_BOOT 23
    #elif CONFIG_GPIO_INPUT_25_BOOT
    #define GPIO_INPUT_BOOT 25
    #elif CONFIG_GPIO_INPUT_26_BOOT
    #define GPIO_INPUT_BOOT 26
    #elif CONFIG_GPIO_INPUT_27_BOOT
    #define GPIO_INPUT_BOOT 27
    #elif CONFIG_GPIO_INPUT_32_BOOT
    #define GPIO_INPUT_BOOT 32
    #elif CONFIG_GPIO_INPUT_33_BOOT
    #define GPIO_INPUT_BOOT 33
    #elif CONFIG_GPIO_INPUT_34_BOOT
    #define GPIO_INPUT_BOOT 34
    #elif CONFIG_GPIO_INPUT_35_BOOT
    #define GPIO_INPUT_BOOT 35
    #elif CONFIG_GPIO_INPUT_36_BOOT
    #define GPIO_INPUT_BOOT 36
    #elif CONFIG_GPIO_INPUT_39_BOOT
    #define GPIO_INPUT_BOOT 39
    #else
    #define GPIO_INPUT_BOOT 22
    #endif /* CONFIG_GPIO_INPUT_BOOT */

    #if CONFIG_GPIO_INPUT_0_MS
    #define GPIO_INPUT_MS 0
    #elif CONFIG_GPIO_INPUT_2_MS
    #define GPIO_INPUT_MS 2
    #elif CONFIG_GPIO_INPUT_4_MS
    #define GPIO_INPUT_MS 4
    #elif CONFIG_GPIO_INPUT_5_MS
    #define GPIO_INPUT_MS 5
    #elif CONFIG_GPIO_INPUT_6_MS
    #define GPIO_INPUT_MS 6
    #elif CONFIG_GPIO_INPUT_7_MS
    #define GPIO_INPUT_MS 7
    #elif CONFIG_GPIO_INPUT_8_MS
    #define GPIO_INPUT_MS 8
    #elif CONFIG_GPIO_INPUT_9_MS
    #define GPIO_INPUT_MS 9
    #elif CONFIG_GPIO_INPUT_10_MS
    #define GPIO_INPUT_MS 10
    #elif CONFIG_GPIO_INPUT_11_MS
    #define GPIO_INPUT_MS 11
    #elif CONFIG_GPIO_INPUT_12_MS
    #define GPIO_INPUT_MS 12
    #elif CONFIG_GPIO_INPUT_13_MS
    #define GPIO_INPUT_MS 13
    #elif CONFIG_GPIO_INPUT_14_MS
    #define GPIO_INPUT_MS 14
    #elif CONFIG_GPIO_INPUT_15_MS
    #define GPIO_INPUT_MS 15
    #elif CONFIG_GPIO_INPUT_16_MS
    #define GPIO_INPUT_MS 16
    #elif CONFIG_GPIO_INPUT_17_MS
    #define GPIO_INPUT_MS 17
    #elif CONFIG_GPIO_INPUT_18_MS
    #define GPIO_INPUT_MS 18
    #elif CONFIG_GPIO_INPUT_19_MS
    #define GPIO_INPUT_MS 19
    #elif CONFIG_GPIO_INPUT_21_MS
    #define GPIO_INPUT_MS 21
    #elif CONFIG_GPIO_INPUT_22_MS
    #define GPIO_INPUT_MS 22
    #elif CONFIG_GPIO_INPUT_23_MS
    #define GPIO_INPUT_MS 23
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
    #define BATTERY_ADC_UNIT 1
    #elif CONFIG_GPIO_INPUT_34_BATTERY
    #define GPIO_INPUT_BATTERY 34
    #define BATTERY_ADC_CH 7
    #define BATTERY_ADC_UNIT 1
    #elif CONFIG_GPIO_INPUT_35_BATTERY
    #define GPIO_INPUT_BATTERY 35
    #define BATTERY_ADC_CH 7
    #define BATTERY_ADC_UNIT 1
    #elif CONFIG_GPIO_INPUT_36_BATTERY
    #define GPIO_INPUT_BATTERY 36
    #define BATTERY_ADC_CH 0
    #define BATTERY_ADC_UNIT 1
    #elif CONFIG_GPIO_INPUT_39_BATTERY
    #define GPIO_INPUT_BATTERY 39
    #define BATTERY_ADC_CH 3
    #define BATTERY_ADC_UNIT 1
    #else
    #define GPIO_INPUT_BATTERY 36
    #define BATTERY_ADC_CH 7
    #define BATTERY_ADC_UNIT 2
    #endif /* CONFIG_GPIO_INPUT_BATTERY */

#endif /* MAIN_MCU specific GPIOs */


#if CONFIG_ESP32_CAM_MCU

    #if CONFIG_GPIO_INPUT_0_BOOT
    #define GPIO_INPUT_BOOT 0
    #elif CONFIG_GPIO_INPUT_2_BOOT
    #define GPIO_INPUT_BOOT 2
    #elif CONFIG_GPIO_INPUT_4_BOOT
    #define GPIO_INPUT_BOOT 4
    #elif CONFIG_GPIO_INPUT_12_BOOT
    #define GPIO_INPUT_BOOT 12
    #elif CONFIG_GPIO_INPUT_13_BOOT
    #define GPIO_INPUT_BOOT 13
    #elif CONFIG_GPIO_INPUT_14_BOOT
    #define GPIO_INPUT_BOOT 14
    #elif CONFIG_GPIO_INPUT_15_BOOT
    #define GPIO_INPUT_BOOT 15
    #elif CONFIG_GPIO_INPUT_16_BOOT
    #define GPIO_INPUT_BOOT 16
    #else
    #define GPIO_INPUT_BOOT 0
    #endif /* CONFIG_GPIO_INPUT_BOOT */

    // Commented out GPIOs are used for SD card comms.
    #if CONFIG_GPIO_INPUT_0_MS
    #define GPIO_INPUT_MS 0
    // #elif CONFIG_GPIO_INPUT_2_MS
    // #define GPIO_INPUT_BOOT 2
    // #elif CONFIG_GPIO_INPUT_4_MS
    // #define GPIO_INPUT_MS 4
    // #elif CONFIG_GPIO_INPUT_12_MS
    // #define GPIO_INPUT_MS 12
    // #elif CONFIG_GPIO_INPUT_13_MS
    // #define GPIO_INPUT_MS 13
    #elif CONFIG_GPIO_INPUT_14_MS
    #define GPIO_INPUT_MS 14
    // #elif CONFIG_GPIO_INPUT_15_MS
    // #define GPIO_INPUT_MS 15
    #elif CONFIG_GPIO_INPUT_16_MS
    #define GPIO_INPUT_MS 16
    #else
    #define GPIO_INPUT_MS 16
    #endif /* CONFIG_GPIO_INPUT_MS */

    // Commented out GPIOs are used for SD card comms.
    #if CONFIG_GPIO_INPUT_0_PIC
    #define GPIO_INPUT_PIC 0
    // #elif CONFIG_GPIO_INPUT_2_PIC
    // #define GPIO_INPUT_PIC 2
    // #elif CONFIG_GPIO_INPUT_4_PIC
    // #define GPIO_INPUT_PIC 4
    // #elif CONFIG_GPIO_INPUT_12_PIC
    // #define GPIO_INPUT_PIC 12
    // #elif CONFIG_GPIO_INPUT_13_PIC
    // #define GPIO_INPUT_PIC 13
    #elif CONFIG_GPIO_INPUT_14_PIC
    #define GPIO_INPUT_PIC 14
    // #elif CONFIG_GPIO_INPUT_15_PIC
    // #define GPIO_INPUT_PIC 15
    #elif CONFIG_GPIO_INPUT_16_PIC
    #define GPIO_INPUT_PIC 16
    #else
    #define GPIO_INPUT_PIC 14
    #endif /* CONFIG_GPIO_INPUT_PIC */

    #if  CONFIG_GPIO_INPUT_0_DRBELL_NOTIF
    #define GPIO_INPUT_DRBELL_NOTIF 0
    #elif CONFIG_GPIO_INPUT_2_DRBELL_NOTIF
    #define GPIO_INPUT_DRBELL_NOTIF 2
    #elif  CONFIG_GPIO_INPUT_4_DRBELL_NOTIF
    #define GPIO_INPUT_DRBELL_NOTIF 4
    #elif  CONFIG_GPIO_INPUT_12_DRBELL_NOTIF
    #define GPIO_INPUT_DRBELL_NOTIF 12
    #elif  CONFIG_GPIO_INPUT_13_DRBELL_NOTIF
    #define GPIO_INPUT_DRBELL_NOTIF 13
    #elif  CONFIG_GPIO_INPUT_14_DRBELL_NOTIF
    #define GPIO_INPUT_DRBELL_NOTIF 14
    #elif  CONFIG_GPIO_INPUT_15_DRBELL_NOTIF
    #define GPIO_INPUT_DRBELL_NOTIF 15
    #elif  CONFIG_GPIO_INPUT_16_DRBELL_NOTIF
    #define GPIO_INPUT_DRBELL_NOTIF 16
    #else
    #define GPIO_INPUT_DRBELL_NOTIF 13
    #endif /* CONFIG_GPIO_INPUT_DRBELL_NOTIF */

    #if  GPIO_INPUT_0_REEDSW_STATUS
    #define GPIO_INPUT_REEDSW_STATUS 0
    #elif CONFIG_GPIO_INPUT_2_REEDSW_STATUS
    #define GPIO_INPUT_REEDSW_STATUS 2
    #elif  CONFIG_GPIO_INPUT_4_REEDSW_STATUS
    #define GPIO_INPUT_REEDSW_STATUS 4
    #elif  CONFIG_GPIO_INPUT_12_REEDSW_STATUS
    #define GPIO_INPUT_REEDSW_STATUS 12
    #elif  CONFIG_GPIO_INPUT_13_REEDSW_STATUS
    #define GPIO_INPUT_REEDSW_STATUS 13
    #elif  CONFIG_GPIO_INPUT_14_REEDSW_STATUS
    #define GPIO_INPUT_REEDSW_STATUS 14
    #elif  CONFIG_GPIO_INPUT_15_REEDSW_STATUS
    #define GPIO_INPUT_REEDSW_STATUS 15
    #elif  CONFIG_GPIO_INPUT_16_REEDSW_STATUS
    #define GPIO_INPUT_REEDSW_STATUS 16
    #else
    #define GPIO_INPUT_REEDSW_STATUS 15
    #endif /* CONFIG_GPIO_INPUT_REEDSW_STATUS */

#endif /* ESP32_CAM_MCU specific GPIOs */

#define GPIO_INPUT_BOOT_PIN_SEL         (1ULL<<GPIO_INPUT_BOOT)
#define GPIO_INPUT_MS_PIN_SEL           (1ULL<<GPIO_INPUT_MS)
#define GPIO_INPUT_DRBELL_PIN_SEL       (1ULL<<GPIO_INPUT_DRBELL_NOTIF)
#define GPIO_INPUT_REEDSW_PIN_SEL       (1ULL<<GPIO_INPUT_REEDSW_STATUS)

#if CONFIG_MAIN_MCU
    #define GPIO_INPUT_MOTOR_FAULT_PIN_SEL  (1ULL<<GPIO_INPUT_MOTOR_FAULT)
    #define GPIO_INPUT_NSW_PIN_SEL          (1ULL<<GPIO_INPUT_NSW)
    #define GPIO_INPUT_BATTERY_PIN_SEL      (1ULL<<GPIO_INPUT_BATTERY)
#endif /* MAIN_MCU specific GPIOs */

#if CONFIG_ESP32_CAM_MCU
    #define GPIO_INPUT_PIC_PIN_SEL          (1ULL<<GPIO_INPUT_PIC)
#endif /* ESP32_CAM specific GPIOs */

//===========================================
//
//              OUTPUT CONFIG
//
//===========================================

#if CONFIG_MAIN_MCU

    #if CONFIG_GPIO_OUTPUT_0_MOTOR_IN1
    #define GPIO_OUTPUT_MOTOR_IN1 0
    #elif CONFIG_GPIO_OUTPUT_2_MOTOR_IN1
    #define GPIO_OUTPUT_MOTOR_IN1 2
    #elif CONFIG_GPIO_OUTPUT_4_MOTOR_IN1
    #define GPIO_OUTPUT_MOTOR_IN1 4
    #elif CONFIG_GPIO_OUTPUT_5_MOTOR_IN1
    #define GPIO_OUTPUT_MOTOR_IN1 5
    #elif CONFIG_GPIO_OUTPUT_6_MOTOR_IN1
    #define GPIO_OUTPUT_MOTOR_IN1 6
    #elif CONFIG_GPIO_OUTPUT_7_MOTOR_IN1
    #define GPIO_OUTPUT_MOTOR_IN1 7
    #elif CONFIG_GPIO_OUTPUT_8_MOTOR_IN1
    #define GPIO_OUTPUT_MOTOR_IN1 8
    #elif CONFIG_GPIO_OUTPUT_9_MOTOR_IN1
    #define GPIO_OUTPUT_MOTOR_IN1 9
    #elif CONFIG_GPIO_OUTPUT_10_MOTOR_IN1
    #define GPIO_OUTPUT_MOTOR_IN1 10
    #elif CONFIG_GPIO_OUTPUT_11_MOTOR_IN1
    #define GPIO_OUTPUT_MOTOR_IN1 11
    #elif CONFIG_GPIO_OUTPUT_12_MOTOR_IN1
    #define GPIO_OUTPUT_MOTOR_IN1 12
    #elif CONFIG_GPIO_OUTPUT_13_MOTOR_IN1
    #define GPIO_OUTPUT_MOTOR_IN1 13
    #elif CONFIG_GPIO_OUTPUT_14_MOTOR_IN1
    #define GPIO_OUTPUT_MOTOR_IN1 14
    #elif CONFIG_GPIO_OUTPUT_15_MOTOR_IN1
    #define GPIO_OUTPUT_MOTOR_IN1 15
    #elif CONFIG_GPIO_OUTPUT_16_MOTOR_IN1
    #define GPIO_OUTPUT_MOTOR_IN1 16
    #elif CONFIG_GPIO_OUTPUT_17_MOTOR_IN1
    #define GPIO_OUTPUT_MOTOR_IN1 17
    #elif CONFIG_GPIO_OUTPUT_18_MOTOR_IN1
    #define GPIO_OUTPUT_MOTOR_IN1 18
    #elif CONFIG_GPIO_OUTPUT_19_MOTOR_IN1
    #define GPIO_OUTPUT_MOTOR_IN1 19
    #elif CONFIG_GPIO_OUTPUT_21_MOTOR_IN1
    #define GPIO_OUTPUT_MOTOR_IN1 21
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
    #define GPIO_OUTPUT_MOTOR_IN2 35
    #elif CONFIG_GPIO_OUTPUT_36_MOTOR_IN2
    #define GPIO_OUTPUT_MOTOR_IN2 36
    #elif CONFIG_GPIO_OUTPUT_39_MOTOR_IN2
    #define GPIO_OUTPUT_MOTOR_IN2 39
    #else
    #define GPIO_OUTPUT_MOTOR_IN2 32
    #endif /* CONFIG_GPIO_OUTPUT_MOTOR_IN2 */

    #if CONFIG_GPIO_OUTPUT_0_STREAM
    #define GPIO_OUTPUT_STREAM 0
    #elif CONFIG_GPIO_OUTPUT_2_STREAM
    #define GPIO_OUTPUT_STREAM 2
    #elif CONFIG_GPIO_OUTPUT_4_STREAM
    #define GPIO_OUTPUT_STREAM 4
    #elif CONFIG_GPIO_OUTPUT_5_STREAM
    #define GPIO_OUTPUT_STREAM 5
    #elif CONFIG_GPIO_OUTPUT_6_STREAM
    #define GPIO_OUTPUT_STREAM 6
    #elif CONFIG_GPIO_OUTPUT_7_STREAM
    #define GPIO_OUTPUT_STREAM 7
    #elif CONFIG_GPIO_OUTPUT_8_STREAM
    #define GPIO_OUTPUT_STREAM 8
    #elif CONFIG_GPIO_OUTPUT_9_STREAM
    #define GPIO_OUTPUT_STREAM 9
    #elif CONFIG_GPIO_OUTPUT_10_STREAM
    #define GPIO_OUTPUT_STREAM 10
    #elif CONFIG_GPIO_OUTPUT_11_STREAM
    #define GPIO_OUTPUT_STREAM 11
    #elif CONFIG_GPIO_OUTPUT_12_STREAM
    #define GPIO_OUTPUT_STREAM 12
    #elif CONFIG_GPIO_OUTPUT_13_STREAM
    #define GPIO_OUTPUT_STREAM 13
    #elif CONFIG_GPIO_OUTPUT_14_STREAM
    #define GPIO_OUTPUT_STREAM 14
    #elif CONFIG_GPIO_OUTPUT_15_STREAM
    #define GPIO_OUTPUT_STREAM 15
    #elif CONFIG_GPIO_OUTPUT_16_STREAM
    #define GPIO_OUTPUT_STREAM 16
    #elif CONFIG_GPIO_OUTPUT_17_STREAM
    #define GPIO_OUTPUT_STREAM 17
    #elif CONFIG_GPIO_OUTPUT_18_STREAM
    #define GPIO_OUTPUT_STREAM 18
    #elif CONFIG_GPIO_OUTPUT_19_STREAM
    #define GPIO_OUTPUT_STREAM 19
    #elif CONFIG_GPIO_OUTPUT_21_STREAM
    #define GPIO_OUTPUT_STREAM 21
    #elif CONFIG_GPIO_OUTPUT_22_STREAM
    #define GPIO_OUTPUT_STREAM 22
    #elif CONFIG_GPIO_OUTPUT_23_STREAM
    #define GPIO_OUTPUT_STREAM 23
    #elif CONFIG_GPIO_OUTPUT_25_STREAM
    #define GPIO_OUTPUT_STREAM 25
    #elif CONFIG_GPIO_OUTPUT_26_STREAM
    #define GPIO_OUTPUT_STREAM 26
    #elif CONFIG_GPIO_OUTPUT_27_STREAM
    #define GPIO_OUTPUT_STREAM 27
    #elif CONFIG_GPIO_OUTPUT_32_STREAM
    #define GPIO_OUTPUT_STREAM 32
    #elif CONFIG_GPIO_OUTPUT_33_STREAM
    #define GPIO_OUTPUT_STREAM 33
    #elif CONFIG_GPIO_OUTPUT_34_STREAM
    #define GPIO_OUTPUT_STREAM 34
    #elif CONFIG_GPIO_OUTPUT_35_STREAM
    #define GPIO_OUTPUT_STREAM 35
    #elif CONFIG_GPIO_OUTPUT_36_STREAM
    #define GPIO_OUTPUT_STREAM 36
    #elif CONFIG_GPIO_OUTPUT_39_STREAM
    #define GPIO_OUTPUT_STREAM 39
    #else
    #define GPIO_OUTPUT_STREAM 2
    #endif /* CONFIG_GPIO_OUTPUT_STREAM */

    #define GPIO_OUTPUT_MOTOR_IN1_PIN_SEL   (1ULL<<GPIO_OUTPUT_MOTOR_IN1)
    #define GPIO_OUTPUT_MOTOR_IN2_PIN_SEL   (1ULL<<GPIO_OUTPUT_MOTOR_IN2)
    #define GPIO_OUTPUT_STREAM_PIN_SEL   (1ULL<<GPIO_OUTPUT_STREAM)

#endif /* MAIN_MCU specific GPIOs */

#if CONFIG_ESP32_CAM_MCU

    #if CONFIG_GPIO_OUTPUT_0_CONFIRM
    #define GPIO_OUTPUT_CONFIRM_UPLOAD 0
    #elif CONFIG_GPIO_OUTPUT_2_CONFIRM
    #define GPIO_OUTPUT_CONFIRM_UPLOAD 4
    #elif CONFIG_GPIO_OUTPUT_12_CONFIRM
    #define GPIO_OUTPUT_CONFIRM_UPLOAD 12
    #elif CONFIG_GPIO_OUTPUT_13_CONFIRM
    #define GPIO_OUTPUT_CONFIRM_UPLOAD 13
    #elif CONFIG_GPIO_OUTPUT_14_CONFIRM
    #define GPIO_OUTPUT_CONFIRM_UPLOAD 14
    #elif CONFIG_GPIO_OUTPUT_15_CONFIRM
    #define GPIO_OUTPUT_CONFIRM_UPLOAD 15
    #elif CONFIG_GPIO_OUTPUT_16_CONFIRM
    #define GPIO_OUTPUT_CONFIRM_UPLOAD 16
    #else
    #define GPIO_OUTPUT_CONFIRM_UPLOAD 4
    #endif /* CONFIG_GPIO_OUTPUT_CONFIRM_UPLOAD */
 
    #define GPIO_OUTPUT_CONFIRM_PIN_SEL   (1ULL<<GPIO_OUTPUT_CONFIRM_UPLOAD)

#endif /* ESP32_CAM_MCU specific GPIOs */

#if CONFIG_MAIN_MCU
#define NUM_GPIO 10
#elif CONFIG_ESP32_CAM_MCU
#define NUM_GPIO 6
#else
#define NUM_GPIO 4
#endif

//===========================================
//
//        Wrong GPIO assignment check
//
//===========================================

#define GPIO_MULTA_ERR_MSG "Multiple functions assigned to same GPIO: "

static const uint8_t gpio_array[NUM_GPIO] = {
#if CONFIG_MAIN_MCU
    GPIO_INPUT_BATTERY, 
    GPIO_INPUT_MOTOR_FAULT,
    GPIO_INPUT_NSW,
    GPIO_OUTPUT_MOTOR_IN1,
    GPIO_OUTPUT_MOTOR_IN2,
    GPIO_OUTPUT_STREAM,
#elif CONFIG_ESP32_CAM_MCU
    GPIO_INPUT_PIC,
    GPIO_OUTPUT_CONFIRM_UPLOAD,
#endif
    GPIO_INPUT_BOOT, 
    GPIO_INPUT_DRBELL_NOTIF, 
    GPIO_INPUT_MS,
    GPIO_INPUT_REEDSW_STATUS
    };

/*#define CHECK_GPIO_ASSIGNMENT(_gpio) ({     \
    char err[100];                          \
    int cnt = 0;                            \
    (_gpio == GPIO_INPUT_MS)            ? strcat(err, "Motion Sensor & "); cnt++;   \
    (_gpio == GPIO_INPUT_MOTOR_FAULT)   ? strcat(err, "Motor Fault & "); cnt++;     \
    (_gpio == GPIO_INPUT_NSW)           ? strcat(err, "N-switch & "); cnt++;        \
    (_gpio == GPIO_INPUT_BATTERY)       ? strcat(err, "Battery & "); cnt++;         \
    (_gpio == GPIO_INPUT_DRBELL_NOTIF)  ? strcat(err, "Doorbell & "); cnt++;        \
    (_gpio == GPIO_INPUT_REEDSW_STATUS) ? strcat(err, "Reed Switch & "); cnt++;     \
    (_gpio == GPIO_OUTPUT_MOTOR_IN1)    ? strcat(err, "Motor CW (In 1) & "); cnt++; \
    (_gpio == GPIO_OUTPUT_MOTOR_IN2)    ? strcat(err, "Motor CCW (In 2) & "); cnt++;\
    (cnt > 1) ? memmove(err, err, strlen(err)-3); err; : NULL;                      \
})*/

/*
#if (CHECK_GPIO_ASSIGNMENT(GPIO_INPUT_MS) != NULL)
#error GPIO_MULTA_ERR_MSG CHECK_GPIO_ASSIGNMENT(GPIO_INPUT_MS)
#endif

#if (CHECK_GPIO_ASSIGNMENT(GPIO_INPUT_MOTOR_FAULT) != NULL)
#error GPIO_MULTA_ERR_MSG CHECK_GPIO_ASSIGNMENT(GPIO_INPUT_MOTOR_FAULT)
#endif

#if (CHECK_GPIO_ASSIGNMENT(GPIO_INPUT_NSW) != NULL)
#error GPIO_MULTA_ERR_MSG CHECK_GPIO_ASSIGNMENT(GPIO_INPUT_NSW)
#endif

#if (CHECK_GPIO_ASSIGNMENT(GPIO_INPUT_BATTERY) != NULL)
#error GPIO_MULTA_ERR_MSG CHECK_GPIO_ASSIGNMENT(GPIO_INPUT_BATTERY)
#endif

#if (CHECK_GPIO_ASSIGNMENT(GPIO_INPUT_DRBELL_NOTIF) != NULL)
#error GPIO_MULTA_ERR_MSG CHECK_GPIO_ASSIGNMENT(GPIO_INPUT_DRBELL_NOTIF)
#endif

#if (CHECK_GPIO_ASSIGNMENT(GPIO_INPUT_REEDSW_STATUS) != NULL)
#error GPIO_MULTA_ERR_MSG CHECK_GPIO_ASSIGNMENT(GPIO_INPUT_REEDSW_STATUS)
#endif

#if (CHECK_GPIO_ASSIGNMENT(GPIO_INPUT_MOTOR_IN1) != NULL)
#error GPIO_MULTA_ERR_MSG CHECK_GPIO_ASSIGNMENT(GPIO_INPUT_MOTOR_IN1)
#endif

#if (CHECK_GPIO_ASSIGNMENT(GPIO_INPUT_MOTOR_IN2) != NULL)
#error GPIO_MULTA_ERR_MSG CHECK_GPIO_ASSIGNMENT(GPIO_INPUT_MOTOR_IN2)
#endif*/

static void check_single_gpio_assignment(uint8_t _gpio, char* _err) {
    char err[100];
    int cnt = 0;
    if(_gpio == GPIO_INPUT_BOOT) {
        strcat(err, "Boot & ");
        cnt++;
    }
    if(_gpio == GPIO_INPUT_MS) {
        strcat(err, "Motion Sensor & ");
        cnt++;
    }
    if(_gpio == GPIO_INPUT_DRBELL_NOTIF) {
        strcat(err, "Doorbell & ");
        cnt++;
    }
    if(_gpio == GPIO_INPUT_REEDSW_STATUS) {
        strcat(err, "Reed Switch & ");
        cnt++;
    }
#if CONFIG_MAIN_MCU
    if(_gpio == GPIO_INPUT_MOTOR_FAULT) {
        strcat(err, "Motor Fault & ");
        cnt++;
    }
    if(_gpio == GPIO_INPUT_NSW) {
        strcat(err, "N-switch & ");
        cnt++;
    }
    if(_gpio == GPIO_INPUT_BATTERY) {
        strcat(err, "Battery & ");
        cnt++;
    }
    if(_gpio == GPIO_OUTPUT_MOTOR_IN1) {
        strcat(err, "Motor CW (In 1) & ");
        cnt++;
    }
    if(_gpio == GPIO_OUTPUT_MOTOR_IN2) {
        strcat(err, "Motor CCW (In 2) & ");
        cnt++;
    }
    if(_gpio == GPIO_OUTPUT_STREAM) {
        strcat(err, "Output Stream & ");
        cnt++;
    }
#elif CONFIG_ESP32_CAM_MCU
    if(_gpio == GPIO_INPUT_PIC) {
        strcat(err, "Picture & ");
        cnt++;
    }
    if(_gpio == GPIO_OUTPUT_CONFIRM_UPLOAD) {
        strcat(err, "Confirm Upload & ");
        cnt++;
    }
#endif
    if(cnt > 1) {
        memmove(_err, err, strlen(err)-3);
    }
    else {
        free(_err);
        _err = NULL;
    }
}

static void gpio_overlap_check(const char* TAG) {
    char* err = NULL;
    for (uint32_t active_gpio = 0; active_gpio < sizeof(gpio_array)/sizeof(uint8_t); active_gpio++) {
        check_single_gpio_assignment(gpio_array[active_gpio], err);
        if (err != NULL)
            ESP_LOGE(TAG, "%s %s", GPIO_MULTA_ERR_MSG, err);
    }
    /*
    check_gpio_assignment(GPIO_INPUT_BOOT, err);
    if (err != NULL)
        ESP_LOGE(TAG, "%s %s", GPIO_MULTA_ERR_MSG, err);
    check_gpio_assignment(GPIO_INPUT_MS, err);
    if (err != NULL)
        ESP_LOGE(TAG, "%s %s", GPIO_MULTA_ERR_MSG, err);
    check_gpio_assignment(GPIO_INPUT_MOTOR_FAULT, err);
    if (err != NULL)
        ESP_LOGE(TAG, "%s %s", GPIO_MULTA_ERR_MSG, err);
    check_gpio_assignment(GPIO_INPUT_NSW, err);
    if (err != NULL)
        ESP_LOGE(TAG, "%s %s", GPIO_MULTA_ERR_MSG, err);
    check_gpio_assignment(GPIO_INPUT_BATTERY, err);
    if (err != NULL)
        ESP_LOGE(TAG, "%s %s", GPIO_MULTA_ERR_MSG, err);
    check_gpio_assignment(GPIO_INPUT_DRBELL_NOTIF, err);
    if (err != NULL)
        ESP_LOGE(TAG, "%s %s", GPIO_MULTA_ERR_MSG, err);
    check_gpio_assignment(GPIO_INPUT_REEDSW_STATUS, err);
    if (err != NULL)
        ESP_LOGE(TAG, "%s %s", GPIO_MULTA_ERR_MSG, err);
    check_gpio_assignment(GPIO_OUTPUT_MOTOR_IN1, err);
    if (err != NULL)
        ESP_LOGE(TAG, "%s %s", GPIO_MULTA_ERR_MSG, err);
    check_gpio_assignment(GPIO_OUTPUT_MOTOR_IN2, err);
    if (err != NULL)
        ESP_LOGE(TAG, "%s %s", GPIO_MULTA_ERR_MSG, err);
        */
}

//================= ADC Array ==================
/** 
 * ADC values are in inverse order with respect to battery voltage
 * as in a full battery (6V) shows 0 mV, 
 * while an empty battery (4.5V) shows 2450+ mV
 */
extern const uint32_t adc_val[99];

extern const uint32_t bat_val[100];
