Elite-Capstone/Project-ShutTheFrontDoor/Hardware/ESP/cam-app-http-server/components/peripherals/stfd_gcp_client.c

/*
    Project:    ShutTheFrontDoor
    File:       stfd_gcp_client.c
    Author:     Benjamin Lanthier
    Date:       19/03/2021

    Desc:       File containing the functions used to communicate (publish and subscribe) to MQTT topics on the Google Cloud IoT Core
*/
#include "stfd_comms.h"

#include <stdlib.h>
#include <string.h>
#include <cJSON.h>
//#include "freertos/event_groups.h"
#include "esp_event_loop.h"
#include "nvs_flash.h"
#include "jsmn.h"
#include <time.h>
#include "lwip/apps/sntp.h"

#include "lwip/err.h"
#include "lwip/sys.h"
#include <iotc_jwt.h>

#define IOTC_UNUSED(x) (void)(x)

#define DEVICE_PATH "projects/%s/locations/%s/registries/%s/devices/%s"
#define SUBSCRIBE_TOPIC_COMMAND "/devices/%s/commands/#"
#define SUBSCRIBE_TOPIC_CONFIG "/devices/%s/config"
#define PUBLISH_TOPIC_EVENT "/devices/%s/events"
#define PUBLISH_TOPIC_STATE "/devices/%s/state"

extern const uint8_t ec_pv_key_start[] asm("_binary_rsa_private_pem_start");
extern const uint8_t ec_pv_key_end[] asm("_binary_rsa_private_pem_end");

static const char *TAG = "stfd_gcp_client";

static char *subscribe_topic_command, *subscribe_topic_config;

static iotc_mqtt_qos_t iotc_qos = IOTC_MQTT_QOS_AT_LEAST_ONCE;
static iotc_timed_task_handle_t delayed_publish_task = IOTC_INVALID_TIMED_TASK_HANDLE;
static iotc_context_handle_t iotc_context = IOTC_INVALID_CONTEXT_HANDLE;

/**
 * Using Device Configurations from Google Cloud IoT, the Device state can be changed.
 * Configurations over commands because commands are discarded if the device is not connected/subscribed
 * Configurations remain until they are consummed by the device
 * Once the device is connected it could receive commands
 */

void initialize_sntp(void)
{
    ESP_LOGI(TAG, "Initializing SNTP");
    sntp_setoperatingmode(SNTP_OPMODE_POLL);
    sntp_setservername(0, "time.google.com");
    sntp_init();
}

void obtain_time(void)
{
    initialize_sntp();
    // wait for time to be set
    time_t now = 0;
    struct tm timeinfo = {0};
    while (timeinfo.tm_year < (2016 - 1900)) {
        ESP_LOGI(TAG, "Waiting for system time to be set...");
        vTaskDelay(2000 / portTICK_PERIOD_MS);
        time(&now);
        localtime_r(&now, &timeinfo);
    }
    ESP_LOGI(TAG, "Time is set...");
}

esp_err_t iotc_init(char* device_path) {
    ESP_LOGI(TAG, "Setting up GCP IoT client...");
    // Initialize SNTP and obtain time
    obtain_time();

    asprintf(&device_path, DEVICE_PATH, CONFIG_GIOT_PROJECT_ID, CONFIG_GIOT_LOCATION, CONFIG_GIOT_REGISTRY_ID, CONFIG_GIOT_DEVICE_ID);

    return ESP_OK;
}

void iotc_init_context(char* jwt) {

    /* Format the key type descriptors so the client understands
     which type of key is being represented. In this case, a PEM encoded
     byte array of a ES256 key. */
    iotc_crypto_key_data_t iotc_connect_private_key_data;
    iotc_connect_private_key_data.crypto_key_signature_algorithm = IOTC_CRYPTO_KEY_SIGNATURE_ALGORITHM_ES256;
    iotc_connect_private_key_data.crypto_key_union_type = IOTC_CRYPTO_KEY_UNION_TYPE_PEM;
    iotc_connect_private_key_data.crypto_key_union.key_pem.key = (char *) ec_pv_key_start;

    /* initialize iotc library and create a context to use to connect to the
    * GCP IoT Core Service. */
    const iotc_state_t error_init = iotc_initialize();

    if (IOTC_STATE_OK != error_init) {
        ESP_LOGE(TAG, " iotc failed to initialize, error: %d", error_init);
        vTaskDelete(NULL);
    }

    /*  Create a connection context. A context represents a Connection
        on a single socket, and can be used to publish and subscribe
        to numerous topics. */
    iotc_context = iotc_create_context();
    if (IOTC_INVALID_CONTEXT_HANDLE >= iotc_context) {
        ESP_LOGE(TAG, " iotc failed to create context, error: %d", -iotc_context);
        vTaskDelete(NULL);
    }

    /*  Queue a connection request to be completed asynchronously.
        The 'stfd_on_connection_state_changed' parameter is the name of the
        callback function after the connection request completes, and its
        implementation should handle both successful connections and
        unsuccessful connections as well as disconnections. */
    // const uint16_t connection_timeout = 0;
    // const uint16_t keepalive_timeout = 20;

    /* Generate the client authentication JWT, which will serve as the MQTT
     * token. */
    char _jwt[IOTC_JWT_SIZE] = {0};
    size_t bytes_written = 0;
    iotc_state_t state = iotc_create_iotcore_jwt(
                            CONFIG_GIOT_PROJECT_ID,/*jwt_expiration_period_sec=*/3600, 
                            &iotc_connect_private_key_data, _jwt, IOTC_JWT_SIZE, &bytes_written
                            );

    if (IOTC_STATE_OK != state) {
        ESP_LOGE(TAG, "iotc_create_iotcore_jwt returned with error: %ul", state);
        vTaskDelete(NULL);
    }
    else
        asprintf(&jwt, _jwt);
}

/* Callback for changes on connection state to the Google IoT core */
static void stfd_on_connection_state_changed(iotc_context_handle_t in_context_handle,
                                 void *data, iotc_state_t state)
{
    iotc_connection_data_t *conn_data = (iotc_connection_data_t *)data;

    switch (conn_data->connection_state) {
    /* IOTC_CONNECTION_STATE_OPENED means that the connection has been
       established and the IoTC Client is ready to send/recv messages */
    case IOTC_CONNECTION_STATE_OPENED:
        ESP_LOGI(TAG, "connected to gcp iotc!");
        stfd_mqtt_subscribe_to_commands(in_context_handle);
        stfd_publish_scheduled_events(in_context_handle, NULL);
        
        break;

    /* IOTC_CONNECTION_STATE_OPEN_FAILED is set when there was a problem
       when establishing a connection to the server. The reason for the error
       is contained in the 'state' variable. Here we log the error state and
       exit out of the application. */

    /* Publish immediately upon connect. 'publish_function' is defined
       in this example file and invokes the IoTC API to publish a
       message. */
    case IOTC_CONNECTION_STATE_OPEN_FAILED:
        ESP_LOGI(TAG, "ERROR! Connection has failed reason %d", state);

        /* exit it out of the application by stopping the event loop. */
        iotc_events_stop();
        break;

    /* IOTC_CONNECTION_STATE_CLOSED is set when the IoTC Client has been
       disconnected. The disconnection may have been caused by some external
       issue, or user may have requested a disconnection. In order to
       distinguish between those two situation it is advised to check the state
       variable value. If the state == IOTC_STATE_OK then the application has
       requested a disconnection via 'iotc_shutdown_connection'. If the state !=
       IOTC_STATE_OK then the connection has been closed from one side. */
    case IOTC_CONNECTION_STATE_CLOSED:
        free(subscribe_topic_command);
        free(subscribe_topic_config);
        /* When the connection is closed it's better to cancel some of previously
           registered activities. Using cancel function on handler will remove the
           handler from the timed queue which prevents the registered handle to be
           called when there is no connection. */
        if (IOTC_INVALID_TIMED_TASK_HANDLE != delayed_publish_task) {
            iotc_cancel_timed_task(delayed_publish_task);
            delayed_publish_task = IOTC_INVALID_TIMED_TASK_HANDLE;
        }

        if (state == IOTC_STATE_OK) {
            /* The connection has been closed intentionally. Therefore, stop
               the event processing loop as there's nothing left to do
               in this example. */
            iotc_events_stop();
        } else {
            ESP_LOGE(TAG, "connection closed - reason %d!", state);
            /* The disconnection was unforeseen.  Try reconnect to the server
            with previously set configuration, which has been provided
            to this callback in the conn_data structure. */
            iotc_connect(
                in_context_handle, conn_data->username, conn_data->password, conn_data->client_id,
                conn_data->connection_timeout, conn_data->keepalive_timeout,
                &stfd_on_connection_state_changed);
        }
        break;

    default:
        ESP_LOGE(TAG, "incorrect connection state value.");
        break;
    }
}

//================================================
//=====    Section - Publishing to Topics    =====
//================================================

void stfd_publish_scheduled_events(iotc_context_handle_t context_handle, void *user_data) {
    /* Create a timed task to publish every 10 seconds. */
    delayed_publish_task = iotc_schedule_timed_task(context_handle, publish_telemetry_event, 10, 15, user_data);
}

void stfd_publish_action_event(iotc_context_handle_t context_handle, iotc_timed_task_handle_t timed_task, void *user_data) {
    IOTC_UNUSED(timed_task);
    IOTC_UNUSED(user_data);
}

void publish_telemetry_event(iotc_context_handle_t context_handle, iotc_timed_task_handle_t timed_task, void *user_data)
{
    IOTC_UNUSED(timed_task);
    IOTC_UNUSED(user_data);

    char *publish_topic = NULL;
    asprintf(&publish_topic, PUBLISH_TOPIC_EVENT, CONFIG_GIOT_DEVICE_ID);
    char *publish_message = NULL;
    asprintf(&publish_message, "publishing stuff");
    ESP_LOGI(TAG, "publishing msg \"%s\" to topic: \"%s\"", publish_message, publish_topic);

    iotc_publish(context_handle, publish_topic, publish_message,
                 iotc_qos,
                 /*callback=*/NULL, /*user_data=*/NULL);
    free(publish_topic);
    free(publish_message);
}

//================================================
//=====    Section - Subcribing to Topics    =====
//================================================

static void stfd_mqtt_commands_subscribe_callback(iotc_context_handle_t in_context_handle, iotc_sub_call_type_t call_type, const iotc_sub_call_params_t *const params, iotc_state_t state, void *user_data)
{
    IOTC_UNUSED(in_context_handle);
    IOTC_UNUSED(call_type);
    IOTC_UNUSED(state);
    IOTC_UNUSED(user_data);

    // Received data is in a formatted JSON. Format described in README of top directory
    if (params != NULL && params->message.topic != NULL) {
        ESP_LOGI(TAG, "Subscription Topic: %s", params->message.topic);
        // Allocate memory for payload
        char *sub_message = (char *)malloc(params->message.temporary_payload_data_length + 1);
        if (sub_message == NULL) {
            ESP_LOGE(TAG, "Failed to allocate memory");
            return;
        }

        // Read payload
        memcpy(sub_message, params->message.temporary_payload_data, params->message.temporary_payload_data_length);
        sub_message[params->message.temporary_payload_data_length] = '\0';
        ESP_LOGI(TAG, "Message Payload: %s ", sub_message);

        // Returns 0 if equal
        if (strcmp(subscribe_topic_command, params->message.topic) == 0) {
            // Decode the received string
            cJSON* command_root = cJSON_Parse(sub_message);
            cJSON* request_time = cJSON_GetObjectItem(command_root, COMMAND_TIME);
            ESP_LOGI(TAG, "Received Request from %i/%i/%i - %i:%i:%i",
            cJSON_GetObjectItem(request_time, TIME_DAY)->valueint,
            cJSON_GetObjectItem(request_time, TIME_MONTH)->valueint,
            cJSON_GetObjectItem(request_time, TIME_YEAR)->valueint,
            cJSON_GetObjectItem(request_time, TIME_HOUR)->valueint,
            cJSON_GetObjectItem(request_time, TIME_MIN)->valueint,
            cJSON_GetObjectItem(request_time, TIME_SEC)->valueint
            );

            ESP_LOGI(TAG, "Received command request: %s", 
            cJSON_GetObjectItem(command_root, COMMAND_REQUEST)->valuestring);

            // int value;
            // sscanf(sub_message, "{\"outlet\": %d}", &value);
            // ESP_LOGI(TAG, "value: %d", value);
            // if (value == 1) {
            //     gpio_set_level(OUTPUT_GPIO, true);
            // } else if (value == 0) {
            //     gpio_set_level(OUTPUT_GPIO, false);
            // }
        }
        free(sub_message);
    }
}

void stfd_mqtt_subscribe_to_commands(iotc_context_handle_t in_context_handle) {
    /* Publish immediately upon connect. 'publish_function' is defined
        in this example file and invokes the IoTC API to publish a
        message. */
    asprintf(&subscribe_topic_command, SUBSCRIBE_TOPIC_COMMAND, CONFIG_GIOT_DEVICE_ID);
    ESP_LOGI(TAG, "subscribing to topic: \"%s\"", subscribe_topic_command);
    iotc_subscribe(in_context_handle, subscribe_topic_command, IOTC_MQTT_QOS_AT_LEAST_ONCE,
                    &stfd_mqtt_commands_subscribe_callback, /*user_data=*/NULL);

    asprintf(&subscribe_topic_config, SUBSCRIBE_TOPIC_CONFIG, CONFIG_GIOT_DEVICE_ID);
    ESP_LOGI(TAG, "subscribing to topic: \"%s\"", subscribe_topic_config);
    iotc_subscribe(in_context_handle, subscribe_topic_config, IOTC_MQTT_QOS_AT_LEAST_ONCE,
                    &stfd_mqtt_commands_subscribe_callback, /*user_data=*/NULL);
}

//================================================
//=====         Section - MQTT Task          =====
//================================================

esp_err_t stfd_mqtt_task(char* device_path, char* jwt)
{
    const uint16_t connection_timeout = 0;
    const uint16_t keepalive_timeout = 20;

    iotc_init_context(jwt);

    iotc_connect(iotc_context, NULL, jwt, device_path, connection_timeout,
                 keepalive_timeout, &stfd_on_connection_state_changed);
    // free(device_path);

    /* The IoTC Client was designed to be able to run on single threaded devices.
        As such it does not have its own event loop thread. Instead you must
        regularly call the function iotc_events_process_blocking() to process
        connection requests, and for the client to regularly check the sockets for
        incoming data. This implementation has the loop operate endlessly. The loop
        will stop after closing the connection, using iotc_shutdown_connection() as
        defined in on_connection_state_change logic, and exit the event handler
        handler by calling iotc_events_stop(); */
    iotc_events_process_blocking();

    iotc_delete_context(iotc_context);

    iotc_shutdown();

    return ESP_OK;
}
