Elite-Capstone/Project-ShutTheFrontDoor/Back End/users/src/main/java/com/theelite/users/security/SecurityConfig.java

package com.theelite.users.security;


import org.springframework.context.annotation.Bean;
import org.springframework.context.annotation.Configuration;
import org.springframework.security.config.annotation.web.builders.HttpSecurity;
import org.springframework.security.config.annotation.web.builders.WebSecurity;
import org.springframework.security.config.annotation.web.configuration.EnableWebSecurity;
import org.springframework.security.config.annotation.web.configuration.WebSecurityConfigurerAdapter;
import org.springframework.security.crypto.bcrypt.BCryptPasswordEncoder;
import org.springframework.security.crypto.password.PasswordEncoder;

import java.security.SecureRandom;
import java.util.Base64;

@Configuration
@EnableWebSecurity
public class SecurityConfig extends WebSecurityConfigurerAdapter {

    @Override
    public void configure(WebSecurity web) throws Exception {
        web.ignoring().antMatchers("*");
    }

    @Override
    protected void configure(HttpSecurity http) throws Exception {
        http.authorizeRequests().antMatchers("*").permitAll();
        http.headers().httpStrictTransportSecurity().disable();
        http.csrf().disable();
    }

    @Bean
    public PasswordEncoder passwordEncoder() {
        return new BCryptPasswordEncoder();
    }

    @Bean
    public SecureRandom secureRandom() {
        return new SecureRandom();
    }

    @Bean
    public Base64.Encoder base64Encoder (){
        return Base64.getUrlEncoder();
    }
}
