Elite-Capstone/Project-ShutTheFrontDoor/(commit log)

2020-10-20 init spring backend project
2020-11-09 new photo of the unlock button to make it more visible
2020-11-09 charts
    I don’t know what happened with sketch;
    added pdf and og file for the software flow charts
2020-11-10 updated flow charts
2021-04-02 Merge Develop into master (#188)
    * added image for the door and the imageview looking gucci
    * tried to use newer version of material design
    * refactoring
    * improved the ui of the homepage
    * added new ui file for register page
    * new class for the register activity
    * refactoring
    * Added view for registering an account
    * added another textfield for confirming password
    plus also removed the actionbar to make it look nicer
    * refactoring plus can now go from register to main activity
    * fixed few mistakes and added password toggler
    * fixed error with the passwords now being hidden properly
    * commented the println and added rounded_shape for rounded
    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
2021-04-03 Merging ESP32_Prog changes to master (#192)
    * commented the println and added rounded_shape for rounded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
    [EDI2CAP.CFG, ESP32-SOLO-1_V1.pcb, ESP32-SOLO-1_V1_BOM(V1.1).xlsx, Final_BOM_Digi-Key.xlsx, SMARTDOOR.OLB, chips.prt, esp32-solo-1_v1_0316.opj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]
2021-04-03 merging storing notifications locally (#193)
    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
2021-04-08 Merging final develop modifications to master (#206)
    * commented the println and added rounded_shape for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
2021-05-04 Bump org.eclipse.paho.client.mqttv3 in /Back End/devices (#209)
    Bumps org.eclipse.paho.client.mqttv3 from 1.0.2 to 1.2.1.
